ORC-Robotics/soul-robot/calibration/report/comparison.png

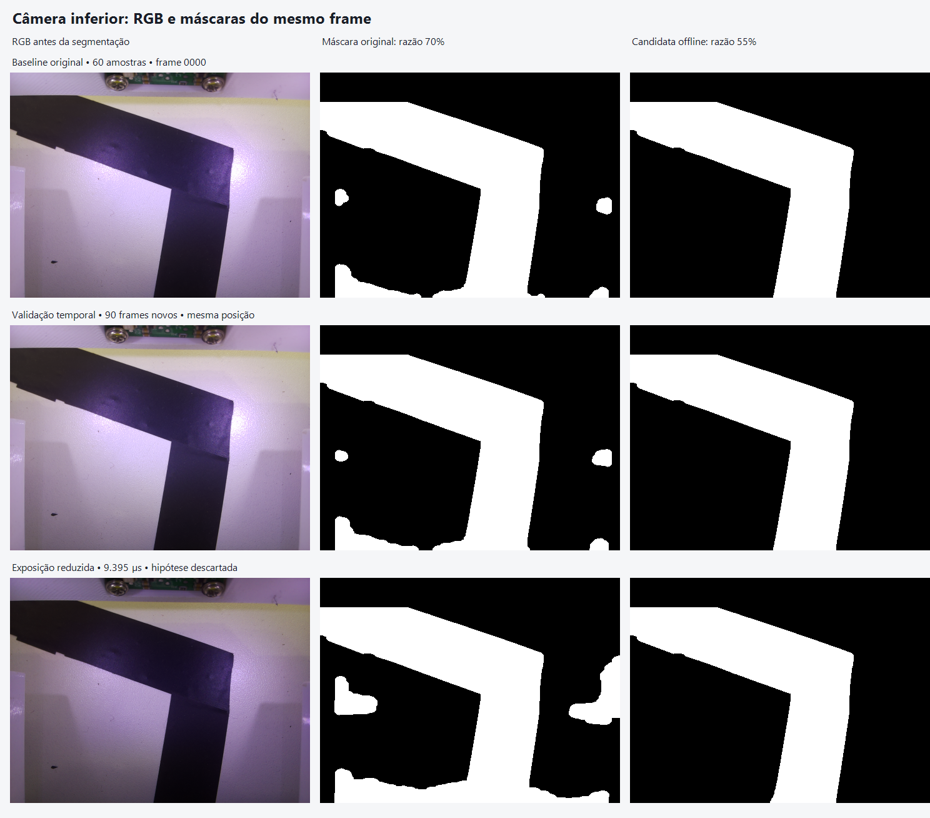
calibration/report/comparison.png
