ORC-Robotics/soul-robot/calibration/report/gap_live_55.png

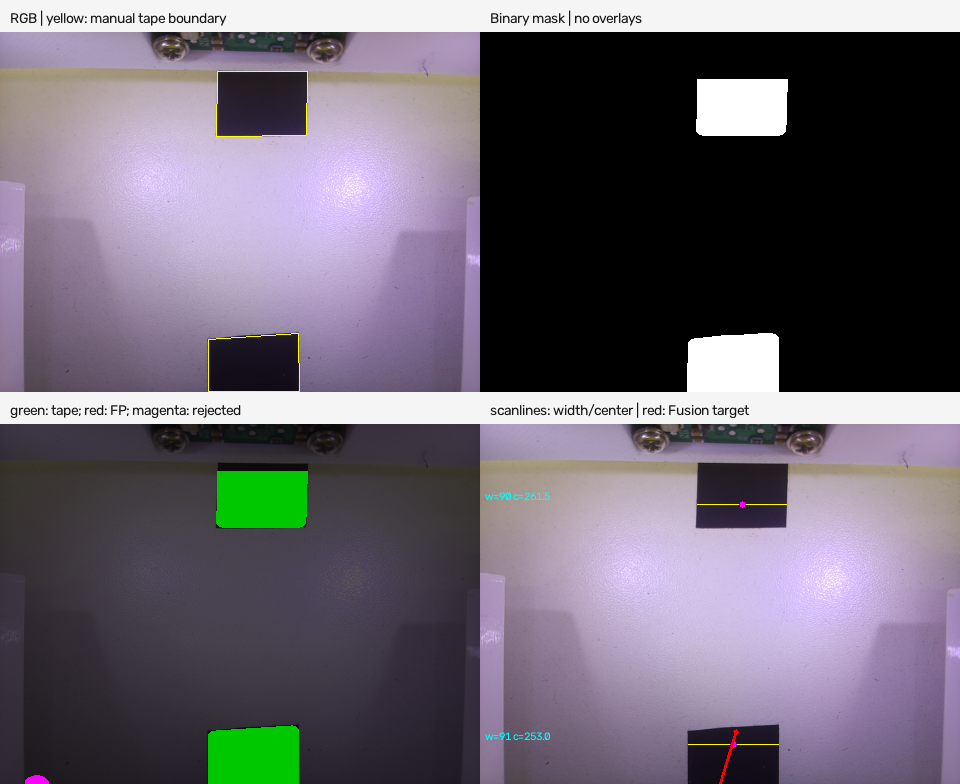
calibration/report/gap_live_55.png
