ORC-Robotics/soul-robot/esp32/obr_esp32_main/README.md

# Firmware principal ESP32 + Raspberry Pi

Abra `obr_esp32_main.ino` no Arduino IDE para gravar o firmware usado no robô.
Ele não cria rede Wi-Fi, não inicia servidor HTTP e não hospeda dashboard.

A ESP32 controla GPIO, motores e sensores. A Raspberry Pi controla o movimento
pela UART de 115200 bps e recebe telemetria a cada 100 ms.

## Ligação UART

| Raspberry Pi | ESP32 | Direção |
| --- | --- | --- |
| GPIO14 / TXD | GPIO3 / RX | Raspberry envia comandos |
| GPIO15 / RXD | GPIO1 / TX | ESP32 envia telemetria |
| GND | GND | Referência elétrica comum |

Desative o console serial da Raspberry antes de conectar. Durante a gravação
da ESP32, mantenha a Raspberry desligada ou desconectada da UART0.

## Comandos recebidos

```text
MOTOR,<esquerda>,<direita>,<emergencia>
STOP
ESTOP
CLEAR_ESTOP
RESET_ENCODERS
CALIBRATE_SENSORS
SYSTEM_STARTING
SYSTEM_READY
SERVO_HOLD,<0|1>
SERVO,<ARM|WRIST|GRIPPER>,<anguloGraus>
SERVO_POSE,<bracoGraus>,<pulsoGraus>,<garraGraus>
SERVO_SLEW,<ARM|WRIST|GRIPPER>,<alvoGraus>,<velocidadeGrausPorSegundo>
SERVO_DISABLE,<ARM|WRIST|GRIPPER>
SERVO_DISABLE_ALL
SERVO_CAL_BEGIN
SERVO_CAL_PULSE,<ARM|WRIST|GRIPPER>,<pulsoUs>
SERVO_CAL_DISABLE
SERVO_CAL_SAVE,<ARM|WRIST|GRIPPER>,<pulsoEmZeroUs>,<pulsoEm180Us>
SERVO_CAL_END
OLED,<duracaoMs>,<tituloHex>,<linha1Hex>,<linha2Hex>
OLED_BIG,<duracaoMs>,<textoPrincipalHex>,<detalheHex>
OLED_CLEAR
PING
```

`OLED` mostra uma página temporária enviada pela Raspberry. O título aceita até
12 caracteres ASCII, cada linha aceita até 20 e a duração fica entre 500 e
30.000 ms. Os textos usam hexadecimal para não conflitar com as vírgulas do
protocolo; um campo vazio é enviado como `-`. `OLED_CLEAR` retorna imediatamente
à página local de bateria e ângulos. E-Stop e calibração continuam tendo
prioridade visual sobre qualquer página remota.

`OLED_BIG` usa o maior tamanho da fonte nativa que comporte o texto principal e
o posiciona somente entre as linhas 16 e 63. Nos módulos bicolores usados pelo
robô, essa é a região fisicamente azul. O detalhe opcional aparece na última
linha. Enquanto ativo, o layout pulsa suavemente o contraste sem apagar o texto.
O conteúdo permanece centralizado, com margem mínima de 4 pixels nas laterais e
2 pixels nos limites verticais da região azul.
E-Stop, calibração e animação de boot continuam tendo prioridade sobre esse
alerta e restauram imediatamente o contraste normal.

O conteúdo e a duração fazem parte de cada comando. Portanto, depois que esta
versão for gravada, novos textos e eventos podem ser criados na Raspberry sem
outra gravação da ESP32. Alterações no layout ou no pulso de contraste continuam
pertencendo ao firmware.

`SYSTEM_STARTING` mantém a animação de inicialização ativa. Depois que UART,
câmera e serviços estão prontos, a Raspberry envia `SYSTEM_READY` a cada segundo.
Se esse heartbeat desaparecer por mais de 3 segundos, a ESP32 volta à animação.
Esse heartbeat não substitui os timeouts e travas dos motores. Fora do modo de
retenção, ele também impede que um pulso antigo permaneça ativo se a Raspberry cair.

`SERVO_HOLD,1` protege mecanismos sujeitos à gravidade: nenhum caminho lógico
aplica `FULL_OFF`, inclusive após Stop, E-Stop ou perda do heartbeat. Novos
movimentos continuam bloqueados sem heartbeat. `SERVO_HOLD,0` libera a trava e
restaura o comportamento normal. A sala de resgate arma a trava; entrar em
Manual ou Calibração, ou pedir o desligamento explícito, libera essa proteção.

`SERVO` movimenta um mecanismo entre 0° e 180°. `SERVO_POSE` valida os três
ângulos antes de aplicar uma pose completa, sendo o formato indicado para
programações predefinidas. Esses dois comandos preservam a aplicação imediata
usada pelas rotinas atuais.

`SERVO_SLEW` é uma capacidade opcional: recebe o alvo e a velocidade máxima
entre 1 e 720 graus por segundo. O canal precisa estar habilitado em uma posição
conhecida antes do comando. A ESP32 atualiza apenas esse servo até o alvo, e um
novo `SERVO`, `SERVO_POSE`, `SERVO_DISABLE` ou `SERVO_DISABLE_ALL` cancela o
movimento gradual correspondente. Nenhum caminho atual da Raspberry envia
`SERVO_SLEW`, portanto gravar o firmware não muda as rotinas existentes.

`SERVO_DISABLE` remove somente o sinal do mecanismo indicado;
`SERVO_DISABLE_ALL` remove os sinais dos três canais quando `SERVO_HOLD` está
inativo. Com a trava ativa, ambos são bloqueados para impedir a queda do braço.
Os servos também são desligados por `STOP`, `ESTOP`, calibração,
`SYSTEM_STARTING` ou perda do heartbeat `SYSTEM_READY`. Os canais e pulsos ficam
centralizados em `../obr_esp32_bridge/robot_config.h`.

A calibração de servo é um modo separado, iniciado por `SERVO_CAL_BEGIN`, e
começa sem emitir pulso. `SERVO_CAL_PULSE` aceita somente 500–2500 µs e mantém
um único canal ativo; se o comando não for renovado por 2 s, o sinal é removido.
`SERVO_CAL_SAVE` recebe os pulsos físicos correspondentes às posições lógicas
0° e 180°, deduz automaticamente a inversão e grava o perfil na NVS com
`Preferences`. `STOP` e `SERVO_CAL_END` encerram o modo e desligam os três
canais. Uma gravação normal preserva os perfis; usar uma opção de apagamento
total da flash pode remover a NVS e restaurar os padrões compilados.

As potências ficam entre `-1.000` e `1.000` e são aplicadas diretamente ao PWM.
Os lados esquerdo e direito são independentes: `MOTOR,0.050,0.000,0` aplica 5%
somente ao lado esquerdo. Não existe perfil, mínimo, boost ou recuperação automática.

Se nenhum comando de motor chegar durante 500 ms, os dois lados são zerados.
O E-Stop permanece travado até `CLEAR_ESTOP` e tem prioridade sobre qualquer
comando de movimento.

O nSLEEP permanece HIGH durante a operação. Partidas e inversões aplicam diretamente
a potência recebida. E-Stop, `STOP` e timeout continuam zerando os motores imediatamente.

`CALIBRATE_SENSORS` para os motores, zera encoders, ângulos e filtros de
navegação e mede novamente os desvios do giroscópio. O mesmo processo começa ao
manter o botão Start no GPIO27 pressionado continuamente por 5 segundos. O robô
deve permanecer imóvel durante a calibração. Depois dela, a trava local mantém
os motores parados até a Raspberry enviar `CLEAR_ESTOP` como parte de uma nova
habilitação explícita; um comando de movimento antigo não é reaplicado.

## Respostas

```text
READY
PONG
ERR,<motivo>
CALIBRATION,START
CALIBRATION,DONE
CALIBRATION,FAILED
START_BUTTON,SHORT
OLED,OK
OLED,CLEARED
SERVO_CAL,START
SERVO_CAL,SAVED,<ARM|WRIST|GRIPPER>
SERVO_CAL,END
SENSOR,<campos CSV...>
```

`START_BUTTON,SHORT` é emitido ao soltar o botão depois de um toque válido. A
Raspberry usa esse evento para iniciar a missão selecionada quando estiver parada.
Em Manual/Autônomo, a telemetria do botão pressionado para o robô imediatamente
e o evento curto posterior é consumido. O evento não é emitido quando a pressão
alcança os 5 segundos da calibração, impedindo que uma tentativa de calibrar
também coloque o robô em movimento.

Os primeiros campos de `SENSOR` preservam o protocolo anterior. Os demais
incluem bateria, encoders, botão, PCA9685, potências aplicadas, velocidades dos
encoders, rampa, giroscópio, temperatura, OLED, nSLEEP, E-Stop e uptime.

Ordem completa dos campos:

```text
SENSOR,
distanciaCm,gyroZ,yawZ,accelX,accelY,accelZ,mpuOk,
bateriaV,encoderEsquerdo,encoderDireito,startButton,pcaOk,
potenciaEsquerda,potenciaDireita,taxaEsquerda,taxaDireita,
rampa,gyroX,gyroY,temperaturaImu,oledOk,nSleepHigh,estop,
bateriaAdcMillivolts,uptimeMs,calibracaoAtiva,oledRemotaAtiva,sistemaRaspberryPronto,
idadeComandoMotorMs,timeoutMotor,fonteMotor,
anguloBraco,pulsoBracoUs,bracoAtivo,
anguloPulso,pulsoPulsoUs,pulsoAtivo,
anguloGarra,pulsoGarraUs,garraAtiva,
calibracaoServoAtiva,indiceServoEmTeste,
minBracoUs,maxBracoUs,bracoInvertido,
minPulsoUs,maxPulsoUs,pulsoInvertido,
minGarraUs,maxGarraUs,garraInvertida
alvoBracoGraus,velocidadeBracoGrausPorSegundo,bracoEmMovimentoGradual,
alvoPulsoGraus,velocidadePulsoGrausPorSegundo,pulsoEmMovimentoGradual,
alvoGarraGraus,velocidadeGarraGrausPorSegundo,garraEmMovimentoGradual
```

A tensão da bateria não é zerada durante a calibração porque é uma medição
absoluta usada para acompanhar a alimentação do robô.
