ORC-Robotics/soul-robot/docs/SILVER_DATASET.md

# Coleta e treinamento da faixa prata

A coleta usa as câmeras já abertas pela aplicação. Na inferior,
`vision.application.DownwardCameraApplication` entrega o frame original ao
`SilverDatasetRecorder`; na frontal, o frame passa pela orientação física antes
da coleta, ainda sem overlays. `vision.status_publisher.LineStatusPublisher`
e o status frontal incluem a mesma telemetria de dataset no dashboard.

O recorder e o classificador já são classes com responsabilidades específicas.
O treinamento permanece offline, separado do ciclo do robô. TensorFlow não é
uma dependência das câmeras. O classificador distingue `black`, `other` e
`silver`; ele não substitui o seguidor geométrico nem calcula comandos dos
motores. Quando quatro inferências consecutivas confirmam `silver`, porém, a
câmera publica `courseMarkerConfirmed=GRAY`. Antes de confirmar a entrada, a
missão recua primeiro 3 cm pelos encoders e então centraliza a linha preta
anterior somente pelo sensor virtual `NEAR`, na parte inferior da imagem. Se a
linha não aparecer, aguarda parada por um frame válido; a busca de vítimas não
é iniciada automaticamente.

## Estado operacional temporário

O detector está ativo por padrão em `vision.camera_config`. A variável de
ambiente `SILVER_DETECTION_ENABLED=0` desliga a inferência durante diagnósticos.
Quando desligado, a câmera publica `courseMarkerConfirmed=false` e
`courseMarker=NONE`; a visão de linha continua funcionando.

O desligamento foi motivado por falsos positivos observados em pista sobre uma
faixa preta sem cinza aparente. O modelo chegou a 85,1% de probabilidade de
`silver`, com margem de 71,4 pontos percentuais, e sustentou quatro positivos
até acionar a entrada na área de resgate. Aumentar somente a confirmação
temporal não corrige esse caso, pois o erro persistiu entre frames.

O modelo atual recebe o frame inteiro reduzido para 128×128. Ele não confirma
cor neutra, brilho, formato transversal, largura nem posição do marcador em
relação à trajetória. O dataset inferior disponível durante o diagnóstico
possuía apenas três sessões físicas, todas coletadas no mesmo dia. Isso permite
que o classificador aprenda iluminação e contexto da cena em vez do material
prateado. Também não há resultado versionado de uma validação independente em
runs completas.

Para continuar melhorando o marcador:

1. grave como exemplos `black` os falsos positivos reais, além de sombras,
   reflexos, curvas, interseções e diferentes trechos de fita;
2. faça novas sessões em dias, posições e iluminações diferentes, separando
   treino, validação e teste por sessão física;
3. detecte primeiro uma faixa transversal plausível e classifique apenas essa
   ROI, exigindo brilho e neutralidade compatíveis com prata;
4. relacione o candidato à trajetória preta e rejeite regiões sem geometria de
   marcador;
5. meça falsos acionamentos por run e recall de prata em sessões que não
   participaram do ajuste;
6. calibre confiança, margem e confirmação temporal somente depois dessas
   medições.

Elevar apenas o limiar não substitui a validação: já houve falso positivo acima
de 85%. O limite operacional foi ajustado para 92% depois que a fita verdadeira
permaneceu acima desse valor e um reflexo roxo chegou a 89,8% na pista.

## Fotografar na Raspberry Pi

Com os serviços normais de câmera em execução e o robô parado, abra uma sessão SSH:

```bash
cd /home/raspberry/OBR2026K
python3 scripts/capture_silver_dataset.py --camera down --session session_001 --fps 4
```

Use `b`, `o` ou `s` e Enter para selecionar a classe e capturar; `p` pausa,
`r` consulta a contagem e `q` encerra pausando. A coleta começa pausada.
Para a frontal, substitua `down` por `forward`. Use um único controlador de
coleta por vez: o arquivo de controle é compartilhado entre as câmeras.

Os JPEGs ficam em `dataset/raw/<camera>/<session>/<classe>/`. A gravação ocorre
na thread do recorder com fila de dois frames. Falhas da coleta não interrompem
a visão. Ao abrir uma sessão, novos frames aguardam a contagem inicial sem
serem contabilizados como descartes. O dashboard mostra coleta ativa, pausada
ou sem atualização (4 segundos). O painel não controla a coleta.

Faça pelo menos duas sessões **por câmera**, cada uma com as três classes.
Para uma coleta simples, use uma sessão `light_on` com a sala acesa e outra
`light_off` com a sala escura, mantendo os LEDs do robô ligados nas duas.
Misture distâncias, ângulos e posições dentro de cada sessão.

Com exatamente duas sessões, o treino separa cada classe de cada sessão em
blocos consecutivos de 20 imagens e distribui blocos inteiros entre treino,
validação e teste. As duas iluminações participam dos três conjuntos sem
dividir frames consecutivos individualmente. Essa avaliação não substitui
passagens reais, pois os três conjuntos ainda vieram das mesmas duas montagens.
Cada classe precisa ter pelo menos 41 imagens em cada sessão; a coleta sugerida
de 500 imagens por classe fica bem acima desse mínimo técnico.

Com três ou mais sessões, o treino continua separando sessões inteiras, que é
o método mais rigoroso. Confira espaço livre e examine alguns JPEGs antes de
fazer uma coleta longa.

## Conferir e treinar no computador

Copie `dataset/raw/` da Raspberry para `dataset/raw/` neste repositório. As
pastas de dataset e resultados continuam ignoradas pelo Git.

```bash
python3 training/training_silver_classifier.py --camera down --validate-only
```

A conferência exige NumPy, mas não TensorFlow. Ela verifica sessões, distribuição
das classes e separação dos conjuntos; a qualidade visual precisa ser revisada.

Para executar a inferência TFLite no serviço da câmera inferior, prepare o
ambiente opcional que o launcher reconhece somente quando todas as dependências
necessárias podem ser importadas:

```bash
cd /home/raspberry/OBR2026K
python3 -m venv --system-site-packages .venv-ai
.venv-ai/bin/python3 -m pip install ai-edge-litert
```

Se esse ambiente estiver ausente ou incompleto, o serviço continua usando
`.venv` ou o Python do sistema. Nesse caso, a visão de linha permanece ativa e
o detector Silver informa indisponibilidade na telemetria, sem confirmar cinza.

Em um ambiente de treinamento com NumPy e TensorFlow instalados:

```bash
python3 training/training_silver_classifier.py --camera down
python3 training/training_silver_classifier.py --camera forward
```

O treinamento usa MobileNetV3Small com pesos ImageNet (o primeiro uso precisa
baixá-los). `--fine-tune` habilita a segunda fase. `--roi LEFT TOP RIGHT BOTTOM`
define um recorte normalizado; se utilizado, a inferência futura deverá aplicar
o mesmo recorte no `SilverLineDetector`. O padrão é a imagem inteira. Os modelos
existentes de teste em `assets/models/` não demonstram qualidade de classificação
na pista.

Saídas: `training_outputs/silver_<camera>/` contém divisão das sessões, modelo
Keras, métricas, histórico e falsos positivos; `assets/models/silver_<camera>.tflite`
recebe o modelo exportado. Reexecutar o treinamento substitui essas saídas da
mesma câmera. Preserve uma cópia quando quiser comparar experimentos.

Depois do treinamento, `vision.silver_detection.SilverLineDetector` carrega o
modelo correspondente com `from_camera_model("down")` ou
`from_camera_model("forward")`. `detect(frame)` retorna `detected`, a classe
vencedora, as probabilidades e a margem da faixa prata sobre a concorrente mais
forte. Os limites atuais são 80% de confiança e 15 pontos percentuais de
margem. A busca e a confirmação rodam em até 30 FPS e exigem quatro positivos
consecutivos. Calibre esses valores com as
métricas e falsos positivos do dataset real antes de operar a missão principal.

## Validação antes de operar

```bash
python3 -m unittest discover -s tests/python
cmake -S . -B build -DBUILD_TESTING=ON
cmake --build build -j2
ctest --test-dir build --output-on-failure
```

Após o deploy autorizado, valide primeiro com rodas suspensas: inicialização
parada, parada de emergência e perda de comandos. Confira ambas as imagens,
as três classes, pausa/retomada, troca de sessão e telemetria antiga com o
processo da câmera parado. Só então teste movimentação em potência reduzida.
Os entrypoints de deploy continuam `scripts/deploy.sh` e `scripts/deploy.ps1`,
delegando para `deployment/`. Nenhum serviço precisa mudar para a coleta.
