ORC-Robotics/soul-robot/calibration/report/border_background_301.png

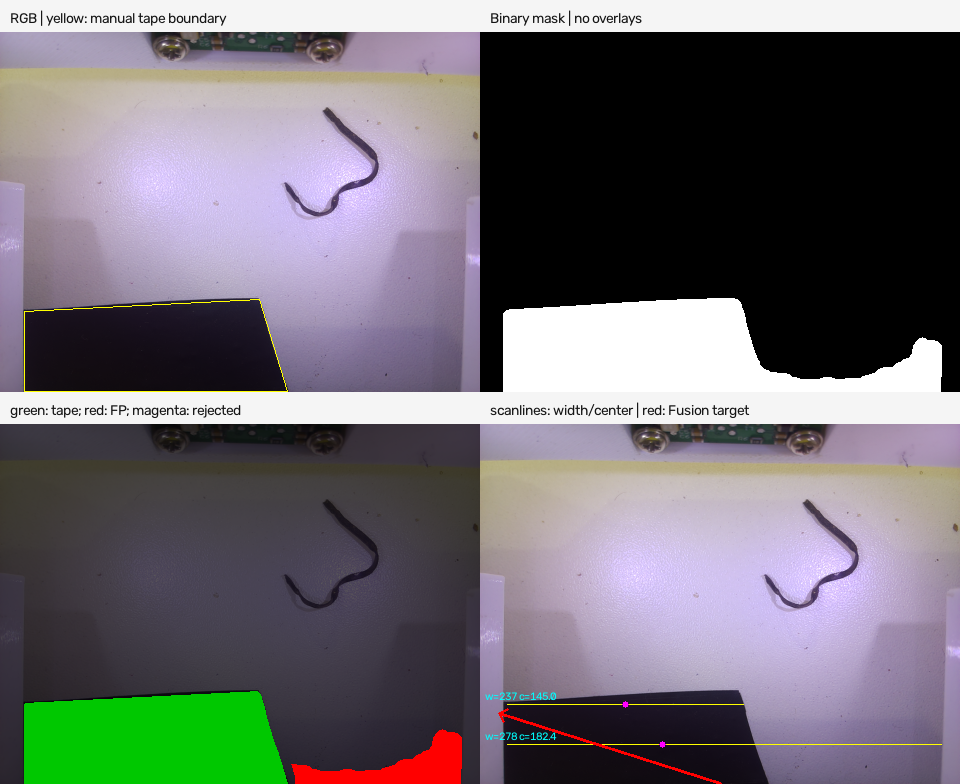
calibration/report/border_background_301.png
