ORC-Robotics/soul-robot/calibration/report/current_pose_preview.png

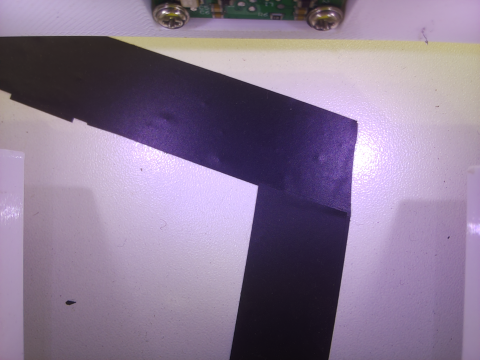
calibration/report/current_pose_preview.png
