ORC-Robotics/soul-robot/calibration/report/final_shadow_after.png

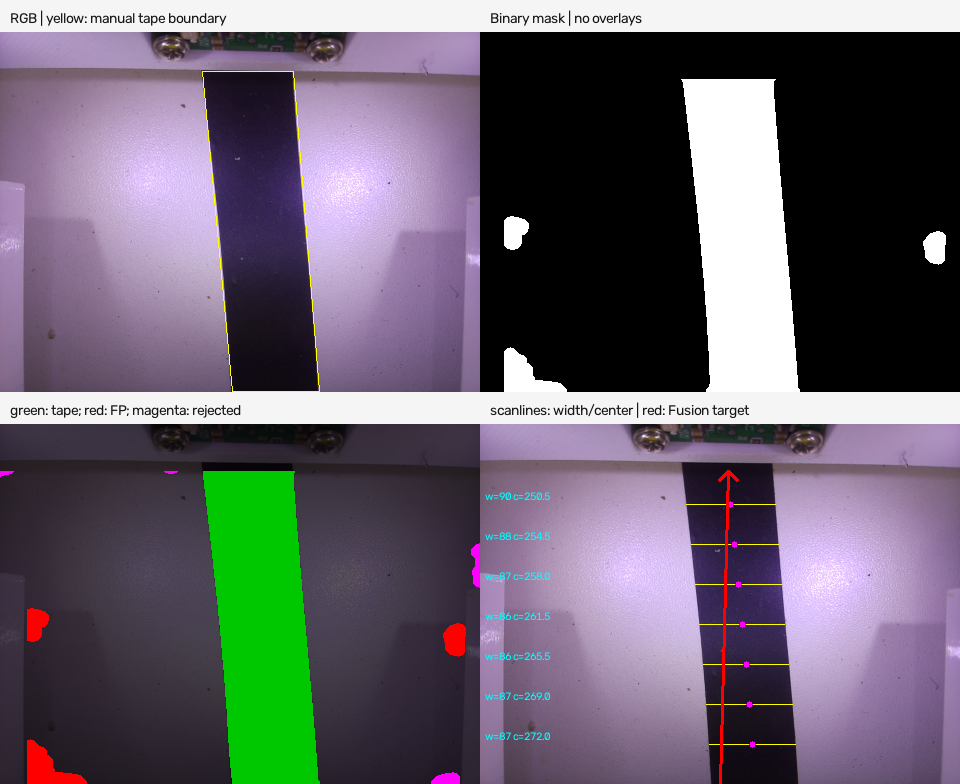
calibration/report/final_shadow_after.png
