ORC-Robotics/soul-robot/calibration/report/final_turn90_after.png

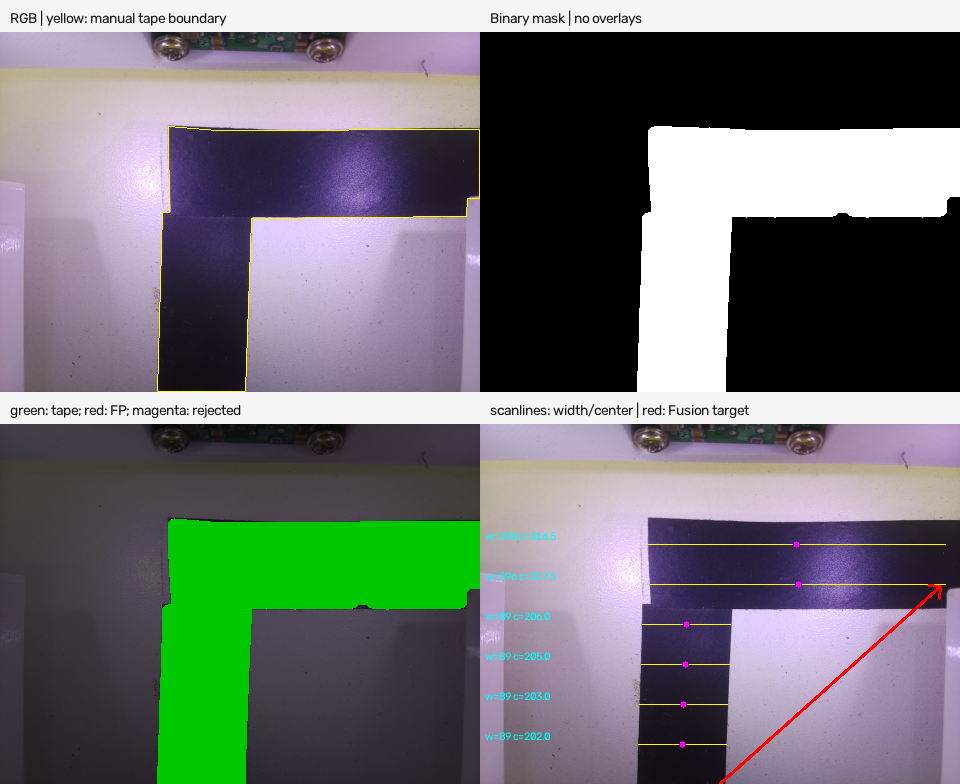
calibration/report/final_turn90_after.png
