ORC-Robotics/soul-robot/calibration/report/gentle_curve_live_55.png

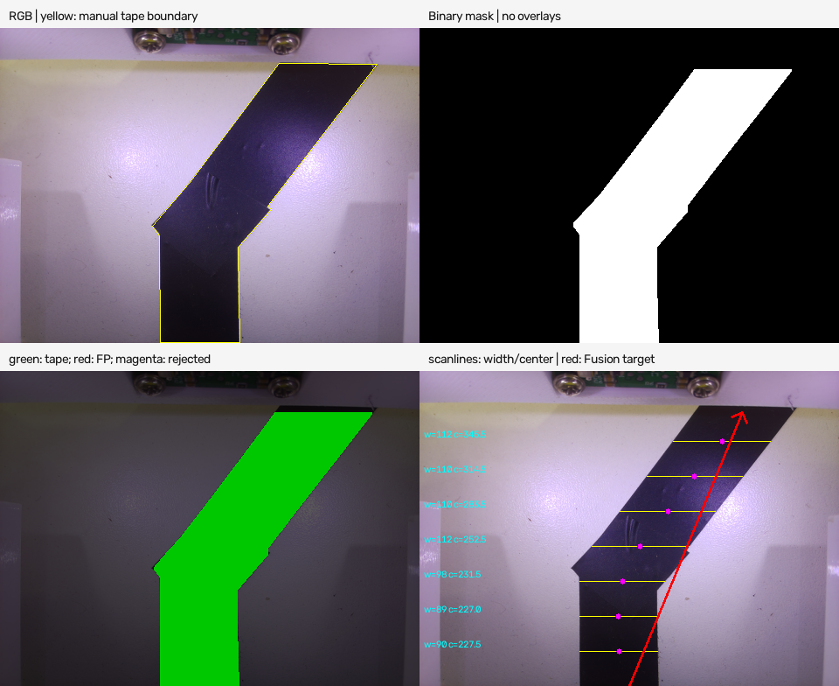
calibration/report/gentle_curve_live_55.png
