ORC-Robotics/soul-robot/calibration/report/green_live_61_exclusion.png

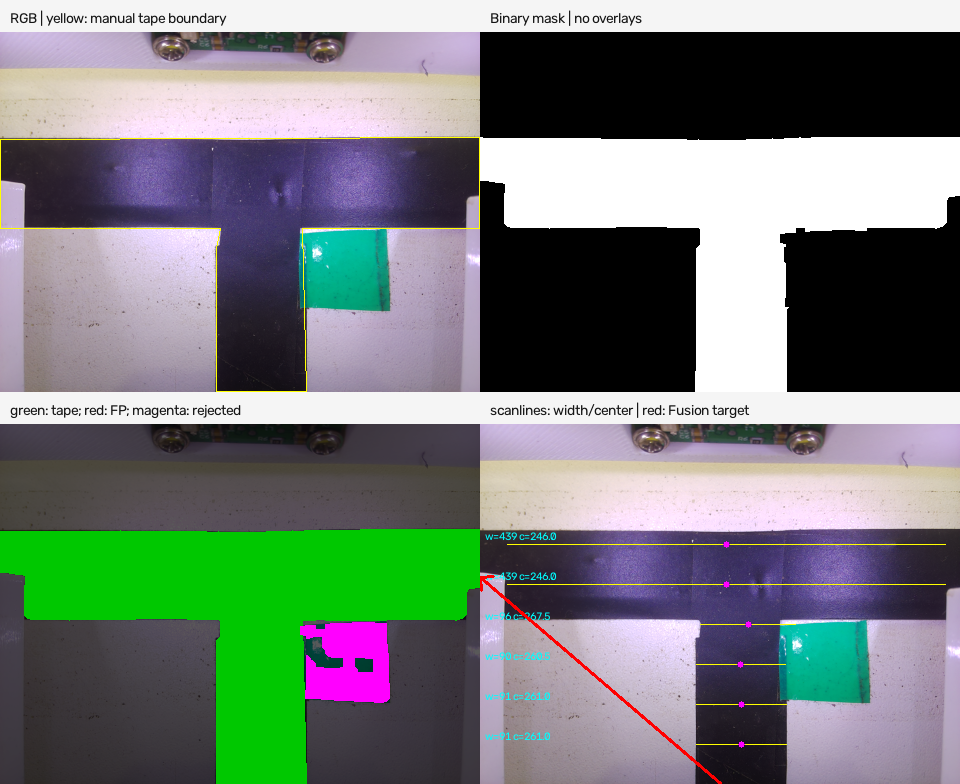
calibration/report/green_live_61_exclusion.png
