ORC-Robotics/soul-robot/calibration/report/illumination_border_wire.png

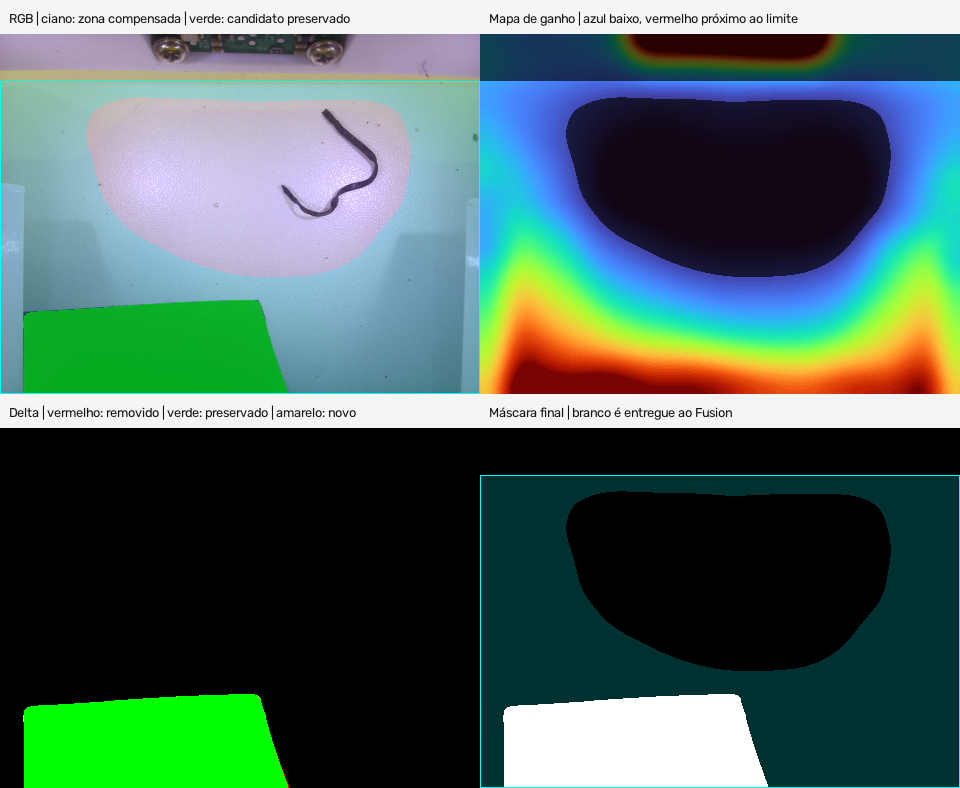
calibration/report/illumination_border_wire.png
