ORC-Robotics/soul-robot/calibration/report/illumination_white_floor.png

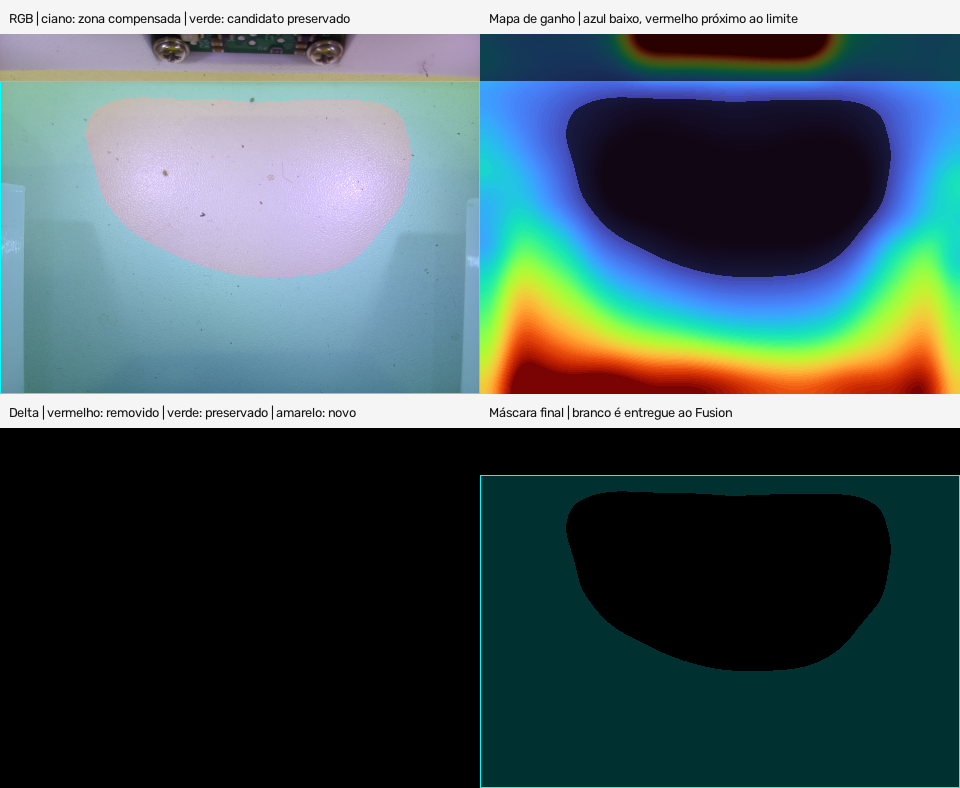
calibration/report/illumination_white_floor.png
