ORC-Robotics/soul-robot/calibration/report/intersection_candidate_55.png

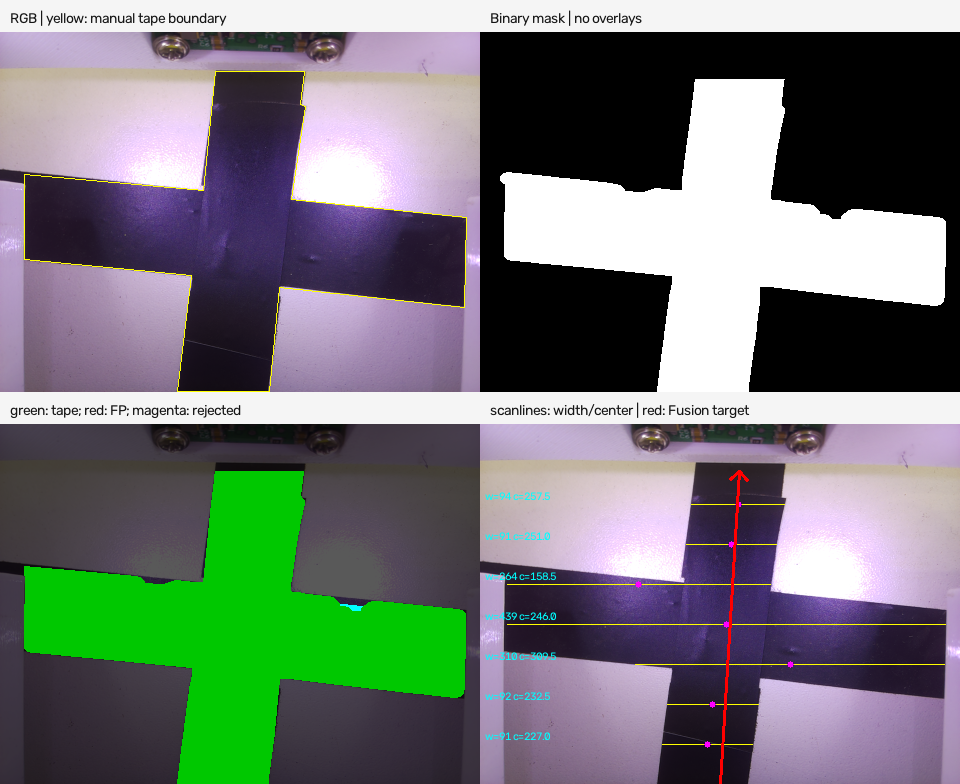
calibration/report/intersection_candidate_55.png
