ORC-Robotics/soul-robot/calibration/report/scanlines_candidate_55.png

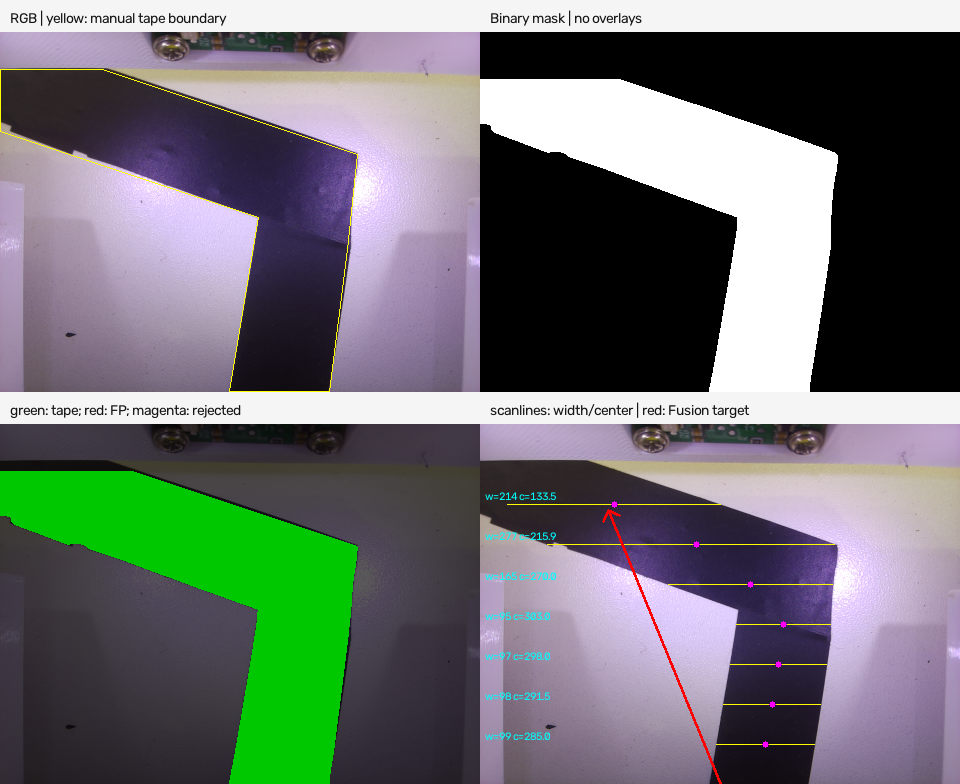
calibration/report/scanlines_candidate_55.png
