ORC-Robotics/soul-robot/calibration/report/straight_candidate_55.png

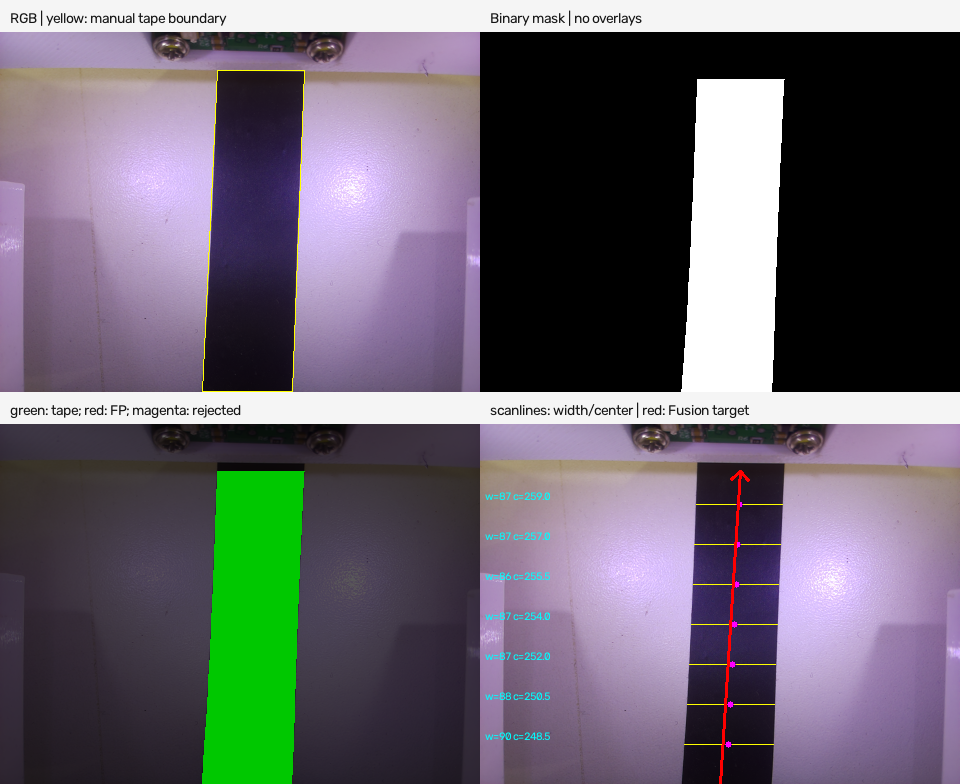
calibration/report/straight_candidate_55.png
