ORC-Robotics/soul-robot/docs/gap-presence-evidence/down.jpg

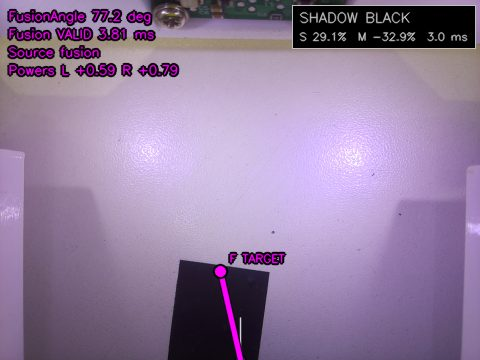
docs/gap-presence-evidence/down.jpg
