ORC-Robotics/soul-robot/docs/gap-presence-evidence/forward.jpg

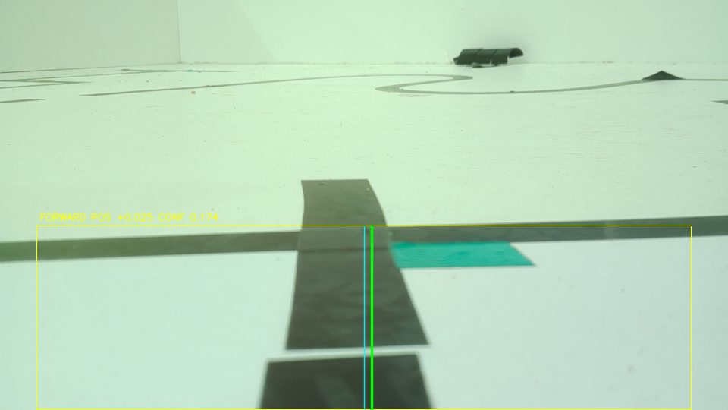
docs/gap-presence-evidence/forward.jpg
