ORC-Robotics/soul-robot/docs/validation-status.md

# Status de validação do robô

**STATUS: EXPERIMENTAL / NÃO VALIDADO**

Este checkpoint preserva o estado atual do algoritmo para instalação e ensaios
sem movimento na Raspberry Pi 5. Ele não representa uma versão estável para
competição e não autoriza testes autônomos no chão.

## Mapeamento físico da Raspberry Pi 5

- CAM0 / índice `0`: câmera inferior (`down`), responsável pelo segue-faixa,
  detecção de verde e publicação de `obr_line_status.json`.
- CAM1 / índice `1`: câmera frontal (`forward`), usada pelo assistente leve de
  linha e pela visão de resgate. O detector de vítimas permanece desligado fora
  da execução explícita de `rescue_area`.

Os papéis são definidos pelos índices configurados, não pelo modelo do sensor.
Uma câmera ausente não pode fazer a outra assumir seu papel automaticamente.

## Problemas conhecidos ainda abertos

- Falsos candidatos verdes podem aparecer no chão branco.
- O verde real ainda pode aparecer como ambíguo em situações físicas.
- O HSV precisa ser calibrado usando frames RGB reais da pista.
- A nova transição START/RUN (`0.67` para `0.61`) ainda precisa de validação
  física com os encoders e as rodas suspensas.
- O pipeline de resgate existe, mas HSV, Hough, FOV, distância e aproximação ainda
  não foram validados na iluminação e no piso da arena.
- O desvio de obstáculo ainda precisa validar no robô os limiares de 8/15 cm e a
  sequência calibrada de giros e deslocamentos.
- A visualização RGB e as máscaras do dashboard continuam em evolução.

## Resultados da validação de 17 de agosto de 2026

- A validação histórica usou `base_speed_preview=0.66` e piso `0.65`. Esses
  valores foram substituídos porque um dos motores não gira nessa potência. A
  calibração física atual definiu partida em `0.67` e manutenção em `0.61`.
  A trajetória válida usa base `0.70`, diferencial contínuo e pode pedir
  `0.86 / 0.61`; a camada C++ mantém `0.67` até o encoder confirmar a roda.
- A captura da câmera inferior já operou próxima de 30 FPS na configuração
  anterior. O [status registrado](../artifacts/pi5-camera-validation-20260817/camera-status.json)
  mostra 30,07 FPS, e o
  [traço de 300 amostras](../artifacts/pi5-camera-validation-20260817/line-regression-trace-300.csv)
  registra a frequência e o tempo de processamento de cada quadro. Após mudar a
  saída inferior para 480×360, é obrigatório registrar uma nova medição antes de
  considerar os 30 FPS confirmados nessa resolução.
- CAM0 e CAM1 foram registradas separadamente nas evidências
  [cam0.jpg](../artifacts/pi5-camera-validation-20260817/cam0.jpg) e
  [cam1.jpg](../artifacts/pi5-camera-validation-20260817/cam1.jpg).
- O controlador normal registrado nas evidências históricas foi removido; esses
  números não descrevem o ponto de extensão atual, que mantém os motores parados.

## Validação física dos verdes em 11 de setembro de 2026

- Os verdes direcionais à esquerda e à direita foram validados fisicamente.
  Depois da confirmação, um pivô inicial curto impede avanço reto; o controle é
  entregue ao Fusion quando o FAR encontra a continuação do ramo selecionado.
- A ROI lateral dos verdes direcionais usa 18% de preto para tolerar a chegada
  diagonal, sem reduzir os 25% exigidos pela ROI superior ligada à faixa.
- O retorno de 180 graus foi validado fisicamente com 140 graus iniciais
  controlados pelo MPU6050. O restante do giro procura a faixa pela câmera e é
  encerrado após duas confirmações consecutivas por NEAR ou Fusion.
- Durante a estabilização após os 140 graus, uma faixa válida tem prioridade
  sobre a espera do giroscópio. Isso devolve imediatamente o controle ao
  segue-faixa quando o robô já está sobre a linha.
- O MPU6050 não apresentou falhas nas outras manobras. A espera angular que
  ocorreu neste ensaio ficou restrita ao retorno e foi resolvida pela prioridade
  visual, sem alterar globalmente os limites do controlador da IMU.
- Caso conhecido para a próxima etapa: dois verdes pertencentes a faixas
  diferentes ainda podem formar um falso retorno de 180 graus. Esse caso não
  foi alterado neste checkpoint para preservar os comportamentos já validados.

## Validação ainda obrigatória antes de novos testes no chão

1. Manter o robô suspenso e o E-Stop disponível no primeiro ensaio após deploy.
2. Confirmar startup com os motores parados e sem loop de reinicialização do
   serviço `obr-robot`.
3. Confirmar que somente CAM0 atualiza `obr_line_status.json` durante a execução.
4. Calibrar o HSV com imagens reais da pista e repetir os casos de verde.
5. Confirmar que o estado normal permanece parado e que uma manobra verde ativa
   mantém seu próprio comando sem ser sobrescrita pela parada normal.
6. Com `obr-line-camera` parado, confirmar que o IPC de linha foi removido e que
   a Missão Principal não pode ser iniciada; após iniciar o serviço, aceitar
   somente uma publicação nova e fresca.
7. Validar por lado a troca STARTING (`0.67`) para RUNNING (`0.61`) depois de
   duas amostras recentes do encoder e o retorno a STARTING após três falhas.
8. Fora de `rescue_area`, confirmar pelo HUD e pela CPU que HSV/Hough permanecem
   inativos; depois iniciar a etapa e validar aquisição, alinhamento, perda do
   alvo, Stop e E-Stop com as rodas suspensas.
9. Validar o desvio primeiro com motores suspensos e potência reduzida; conferir
   confirmação ultrassônica, cada giro, cada distância, falhas de IMU/encoder e
   retorno da autoridade ao segue-faixa.
