ORC-Robotics/soul-robot/scripts/vision/calibration/down_line_illumination_480x360.png

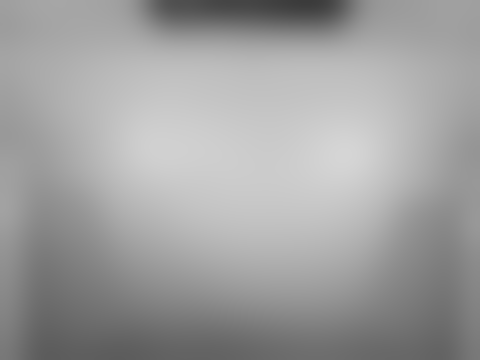
scripts/vision/calibration/down_line_illumination_480x360.png
