ORC-Robotics/soul-robot/esp32/obr_esp32_bridge/obr_esp32_bridge.ino

#include <Arduino.h>
#include <Adafruit_GFX.h>
#include <Adafruit_MPU6050.h>
#include <Adafruit_PWMServoDriver.h>
#include <Adafruit_Sensor.h>
#include <Adafruit_SSD1306.h>
#include <Preferences.h>
#ifndef OBR_ESP32_RASPBERRY_MODE
#include <WebServer.h>
#include <WiFi.h>
#endif
#include <Wire.h>
#include <driver/gpio.h>

#ifndef OBR_ESP32_RASPBERRY_MODE
#include "dashboard_page.h"
#endif
#include "robot_config.h"

#if __has_include(<esp_arduino_version.h>)
#include <esp_arduino_version.h>
#endif

#ifndef ESP_ARDUINO_VERSION_MAJOR
#define ESP_ARDUINO_VERSION_MAJOR 2
#endif

using namespace robot_config;

enum class ControlSource
{
  None,
  Dashboard,
  Raspberry
};

enum class ServoId : uint8_t
{
  Arm = 0,
  Wrist = 1,
  Gripper = 2
};

struct ServoOutputConfig
{
  const char* protocolName;
  const char* preferencesKey;
  uint8_t channel;
  uint16_t defaultMinimumPulseUs;
  uint16_t defaultMaximumPulseUs;
  bool defaultInverted;
};

struct ServoCalibration
{
  uint16_t minimumPulseUs;
  uint16_t maximumPulseUs;
  bool inverted;
};

struct StoredServoCalibration
{
  uint16_t version;
  uint16_t minimumPulseUs;
  uint16_t maximumPulseUs;
  uint8_t inverted;
  uint8_t reserved;
};

static_assert(sizeof(StoredServoCalibration) == 8,
              "Stored servo calibration layout changed");

struct ServoOutputState
{
  float angleDegrees = 0.0f;
  uint16_t pulseUs = 0;
  bool enabled = false;
  float targetAngleDegrees = 0.0f;
  float slewRateDegreesPerSecond = 0.0f;
  uint32_t lastSlewUpdateMs = 0;
  bool slewActive = false;
};

// A ordem desta tabela deve permanecer igual à ordem de ServoId.
// Cada entrada concentra canal, calibração e sentido de um mecanismo.
constexpr ServoOutputConfig kServoOutputConfigs[] = {
    {"ARM", "arm", kArmServoChannel, kArmServoMinimumPulseUs,
     kArmServoMaximumPulseUs, kArmServoInverted},
    {"WRIST", "wrist", kWristServoChannel, kWristServoMinimumPulseUs,
     kWristServoMaximumPulseUs, kWristServoInverted},
    {"GRIPPER", "gripper", kGripperServoChannel, kGripperServoMinimumPulseUs,
     kGripperServoMaximumPulseUs, kGripperServoInverted}};

constexpr size_t kServoOutputCount =
    sizeof(kServoOutputConfigs) / sizeof(kServoOutputConfigs[0]);

void forceMotorPinsLowImmediately()
{
  // Mantém o driver dormindo antes de configurar qualquer entrada de motor.
  // O pull-down físico da PCB garante o mesmo estado antes deste código rodar.
  gpio_set_level(static_cast<gpio_num_t>(kMotorSleepPin), 0);
  // INPUT_OUTPUT permite dirigir nSLEEP e ler no dashboard o nível presente
  // no pad. Em OUTPUT puro, gpio_get_level() pode informar LOW incorretamente.
  gpio_set_direction(static_cast<gpio_num_t>(kMotorSleepPin), GPIO_MODE_INPUT_OUTPUT);

  // Grava LOW antes de habilitar os GPIOs como saída. Assim, nenhuma entrada
  // do DRV8833 recebe um pulso alto causado pela troca de direção do pino.
  gpio_set_level(static_cast<gpio_num_t>(kLeftMotorIn1Pin), 0);
  gpio_set_level(static_cast<gpio_num_t>(kLeftMotorIn2Pin), 0);
  gpio_set_level(static_cast<gpio_num_t>(kRightMotorIn1Pin), 0);
  gpio_set_level(static_cast<gpio_num_t>(kRightMotorIn2Pin), 0);
  gpio_set_direction(static_cast<gpio_num_t>(kLeftMotorIn1Pin), GPIO_MODE_OUTPUT);
  gpio_set_direction(static_cast<gpio_num_t>(kLeftMotorIn2Pin), GPIO_MODE_OUTPUT);
  gpio_set_direction(static_cast<gpio_num_t>(kRightMotorIn1Pin), GPIO_MODE_OUTPUT);
  gpio_set_direction(static_cast<gpio_num_t>(kRightMotorIn2Pin), GPIO_MODE_OUTPUT);
}

// Este inicializador executa antes do setup() e antecipa a parada dos motores.
// Ele existe porque a PCB mantém o DRV8833 habilitado durante o boot da ESP32.
class EarlyMotorSafetyInitializer
{
public:
  EarlyMotorSafetyInitializer()
  {
    forceMotorPinsLowImmediately();
  }
};

EarlyMotorSafetyInitializer earlyMotorSafetyInitializer;

#ifndef OBR_ESP32_RASPBERRY_MODE
// O servidor existe somente no firmware de bancada. O firmware principal
// exclui Wi-Fi e HTTP durante a compilação e obedece apenas à Raspberry.
WebServer server(80);
#endif
Adafruit_MPU6050 mpu;
Adafruit_PWMServoDriver pca9685(kPca9685Address, Wire);
Adafruit_SSD1306 oled(kOledWidth, kOledHeight, &Wire, -1);

struct SensorState
{
  float batteryVoltage = 0.0f;
  uint32_t batteryAdcMillivolts = 0;
  float ultrasonicDistanceCm = -1.0f;
  bool ultrasonicValid = false;
  float accelX = 0.0f;
  float accelY = 0.0f;
  float accelZ = 0.0f;
  float gyroX = 0.0f;
  float gyroY = 0.0f;
  float gyroZ = 0.0f;
  float yawZ = 0.0f;
  float rampAngleDegrees = 0.0f;
  float imuTemperatureCelsius = 0.0f;
  float leftEncoderRate = 0.0f;
  float rightEncoderRate = 0.0f;
};

SensorState sensors;
ServoOutputState servoOutputStates[kServoOutputCount];
ServoCalibration servoCalibrations[kServoOutputCount] = {
    {kArmServoMinimumPulseUs, kArmServoMaximumPulseUs, kArmServoInverted},
    {kWristServoMinimumPulseUs, kWristServoMaximumPulseUs,
     kWristServoInverted},
    {kGripperServoMinimumPulseUs, kGripperServoMaximumPulseUs,
     kGripperServoInverted}};
bool mpuReady = false;
bool pca9685Ready = false;
bool oledReady = false;
bool motorDriverAwake = false;
uint8_t mpuAddress = 0;
uint8_t oledAddress = 0;
bool startButtonPressed = false;
bool rawStartButtonPressed = false;
bool calibrationActive = false;
bool calibrationStopLatched = false;
bool servoCalibrationActive = false;
// Enquanto ativo, nenhum caminho lógico pode remover o PWM dos servos. Esse
// modo existe para mecanismos que caem por gravidade quando recebem FULL_OFF.
bool servoHoldActive = false;
int8_t servoCalibrationSelectedIndex = -1;
bool dashboardArmed = false;
bool emergencyStopActive = false;
float currentLeftPower = 0.0f;
float currentRightPower = 0.0f;
float gyroYBias = 0.0f;
float gyroZBias = 0.0f;
float filteredGyroZ = 0.0f;
bool gyroFilterInitialized = false;
bool rampAngleInitialized = false;
ControlSource controlSource = ControlSource::None;

uint32_t lastMotorCommandMs = 0;
uint32_t lastImuReadMs = 0;
uint32_t lastTelemetryMs = 0;
uint32_t lastBatteryReadMs = 0;
uint32_t lastEncoderRateMs = 0;
uint32_t lastUltrasonicTriggerMs = 0;
uint32_t lastButtonChangeMs = 0;
uint32_t startButtonPressedSinceMs = 0;
uint32_t lastStartButtonShortEventMs = 0;
uint32_t lastMpuIntegrationUs = 0;
uint32_t lastOledRefreshMs = 0;
bool startButtonLongPressHandled = false;
bool remoteOledActive = false;
bool remoteOledLargeLayout = false;
bool oledAlertContrastModified = false;
uint32_t remoteOledStartedAtMs = 0;
uint32_t remoteOledExpiresAtMs = 0;
char remoteOledTitle[kRemoteOledTitleMaxLength + 1] = {};
char remoteOledFirstLine[kRemoteOledLineMaxLength + 1] = {};
char remoteOledSecondLine[kRemoteOledLineMaxLength + 1] = {};
#ifdef OBR_ESP32_RASPBERRY_MODE
bool raspberrySystemReady = false;
#else
// O firmware de bancada não depende da Raspberry e libera a tela imediatamente.
bool raspberrySystemReady = true;
#endif
uint32_t lastRaspberrySystemReadyMs = 0;
uint32_t lastServoCalibrationCommandMs = 0;

portMUX_TYPE encoderMux = portMUX_INITIALIZER_UNLOCKED;
volatile int32_t leftEncoderCount = 0;
volatile int32_t rightEncoderCount = 0;
volatile uint8_t previousLeftEncoderState = 0;
volatile uint8_t previousRightEncoderState = 0;
int32_t lastLeftEncoderRateCount = 0;
int32_t lastRightEncoderRateCount = 0;
portMUX_TYPE ultrasonicMux = portMUX_INITIALIZER_UNLOCKED;
volatile bool ultrasonicWaitingForEcho = false;
volatile bool ultrasonicSampleAvailable = false;
volatile uint32_t ultrasonicTriggerUs = 0;
volatile uint32_t ultrasonicEchoStartUs = 0;
volatile uint32_t ultrasonicEchoDurationUs = 0;

// O maior comando OLED ocupa menos de 128 bytes com os limites definidos em
// robot_config.h. Comandos maiores são descartados antes de serem interpretados.
constexpr size_t kCommandBufferSize = 128;
char commandBuffer[kCommandBufferSize] = {};
size_t commandLength = 0;

// Tabela de transições do encoder quadrature. Transições inválidas
// contam zero e reduzem erros causados por ruído ou bordas perdidas.
constexpr int8_t kQuadratureTransitions[16] = {
    0, -1, 1, 0,
    1, 0, 0, -1,
    -1, 0, 0, 1,
    0, 1, -1, 0};

void ARDUINO_ISR_ATTR updateLeftEncoder()
{
  const uint8_t currentState =
      (digitalRead(kLeftEncoderAPin) << 1) | digitalRead(kLeftEncoderBPin);
  portENTER_CRITICAL_ISR(&encoderMux);
  leftEncoderCount += kQuadratureTransitions[(previousLeftEncoderState << 2) | currentState];
  previousLeftEncoderState = currentState;
  portEXIT_CRITICAL_ISR(&encoderMux);
}

void ARDUINO_ISR_ATTR updateRightEncoder()
{
  const uint8_t currentState =
      (digitalRead(kRightEncoderAPin) << 1) | digitalRead(kRightEncoderBPin);
  portENTER_CRITICAL_ISR(&encoderMux);
  rightEncoderCount += kQuadratureTransitions[(previousRightEncoderState << 2) | currentState];
  previousRightEncoderState = currentState;
  portEXIT_CRITICAL_ISR(&encoderMux);
}

void ARDUINO_ISR_ATTR captureUltrasonicEcho()
{
  const uint32_t nowUs = micros();
  const bool echoHigh = digitalRead(kFrontUltrasonicEchoPin) == HIGH;

  portENTER_CRITICAL_ISR(&ultrasonicMux);
  if (ultrasonicWaitingForEcho && echoHigh)
  {
    ultrasonicEchoStartUs = nowUs;
  }
  else if (ultrasonicWaitingForEcho && ultrasonicEchoStartUs != 0)
  {
    ultrasonicEchoDurationUs = nowUs - ultrasonicEchoStartUs;
    ultrasonicSampleAvailable = true;
    ultrasonicWaitingForEcho = false;
    ultrasonicEchoStartUs = 0;
  }
  portEXIT_CRITICAL_ISR(&ultrasonicMux);
}

void attachMotorPwm(uint8_t pin, uint8_t channel)
{
#if ESP_ARDUINO_VERSION_MAJOR >= 3
  ledcAttach(pin, kMotorPwmFrequencyHz, kMotorPwmResolutionBits);
  ledcWrite(pin, 0);
#else
  ledcSetup(channel, kMotorPwmFrequencyHz, kMotorPwmResolutionBits);
  ledcAttachPin(pin, channel);
  ledcWrite(channel, 0);
#endif
}

void writeMotorPwm(uint8_t pin, uint8_t channel, uint16_t duty)
{
  duty = constrain(duty, 0, kMotorPwmMaxDuty);
#if ESP_ARDUINO_VERSION_MAJOR >= 3
  ledcWrite(pin, duty);
#else
  ledcWrite(channel, duty);
#endif
}

float safeMotorCommand(float command)
{
  if (!isfinite(command))
  {
    return 0.0f;
  }

  // A faixa de -1 a 1 é o próprio formato do protocolo: 0,05 corresponde
  // diretamente a 5% do duty e não recebe remapeamento, mínimo ou boost.
  return constrain(command, -kMaximumMotorPower, kMaximumMotorPower);
}

size_t servoIndex(ServoId servo)
{
  return static_cast<size_t>(servo);
}

const ServoOutputConfig& servoConfig(ServoId servo)
{
  return kServoOutputConfigs[servoIndex(servo)];
}

ServoCalibration& servoCalibration(ServoId servo)
{
  return servoCalibrations[servoIndex(servo)];
}

ServoOutputState& servoState(ServoId servo)
{
  return servoOutputStates[servoIndex(servo)];
}

bool parseServoId(const char* text, ServoId& servo)
{
  for (size_t index = 0; index < kServoOutputCount; ++index)
  {
    if (strcmp(text, kServoOutputConfigs[index].protocolName) == 0)
    {
      servo = static_cast<ServoId>(index);
      return true;
    }
  }
  return false;
}

bool isValidServoAngle(float angleDegrees)
{
  return isfinite(angleDegrees) &&
         angleDegrees >= kServoMinimumAngleDegrees &&
         angleDegrees <= kServoMaximumAngleDegrees;
}

bool isValidServoCalibration(const ServoCalibration& calibration)
{
  return calibration.minimumPulseUs >=
             kServoCalibrationAbsoluteMinimumPulseUs &&
         calibration.maximumPulseUs <=
             kServoCalibrationAbsoluteMaximumPulseUs &&
         calibration.maximumPulseUs > calibration.minimumPulseUs &&
         calibration.maximumPulseUs - calibration.minimumPulseUs >=
             kServoCalibrationMinimumSpanUs;
}

ServoCalibration defaultServoCalibration(ServoId servo)
{
  const ServoOutputConfig& config = servoConfig(servo);
  return {config.defaultMinimumPulseUs, config.defaultMaximumPulseUs,
          config.defaultInverted};
}

void loadServoCalibrations()
{
  Preferences preferences;
  if (!preferences.begin(kServoPreferencesNamespace, true))
  {
    return;
  }

  for (size_t index = 0; index < kServoOutputCount; ++index)
  {
    const ServoId servo = static_cast<ServoId>(index);
    servoCalibrations[index] = defaultServoCalibration(servo);
    const ServoOutputConfig& config = servoConfig(servo);
    if (preferences.getBytesLength(config.preferencesKey) !=
        sizeof(StoredServoCalibration))
    {
      continue;
    }

    StoredServoCalibration stored = {};
    if (preferences.getBytes(
            config.preferencesKey, &stored, sizeof(stored)) != sizeof(stored))
    {
      continue;
    }

    const ServoCalibration loaded = {
        stored.minimumPulseUs, stored.maximumPulseUs, stored.inverted != 0};
    if (stored.version == kServoCalibrationStorageVersion &&
        stored.inverted <= 1 && isValidServoCalibration(loaded))
    {
      servoCalibrations[index] = loaded;
    }
  }
  preferences.end();
}

bool persistServoCalibration(ServoId servo,
                             const ServoCalibration& calibration)
{
  if (!isValidServoCalibration(calibration))
  {
    return false;
  }

  Preferences preferences;
  if (!preferences.begin(kServoPreferencesNamespace, false))
  {
    return false;
  }

  const StoredServoCalibration stored = {
      kServoCalibrationStorageVersion,
      calibration.minimumPulseUs,
      calibration.maximumPulseUs,
      calibration.inverted ? static_cast<uint8_t>(1) : static_cast<uint8_t>(0),
      0};
  const size_t written = preferences.putBytes(
      servoConfig(servo).preferencesKey, &stored, sizeof(stored));
  preferences.end();
  return written == sizeof(stored);
}

uint16_t servoPulseForAngle(const ServoCalibration& calibration,
                            float angleDegrees)
{
  // Conversão linear usada pelas poses: pulso = mínimo +
  // (ângulo / 180°) × (máximo - mínimo), com inversão quando configurada.
  const float normalizedAngle =
      (angleDegrees - kServoMinimumAngleDegrees) /
      (kServoMaximumAngleDegrees - kServoMinimumAngleDegrees);
  const float directedPosition = calibration.inverted
                                     ? 1.0f - normalizedAngle
                                     : normalizedAngle;
  const float pulseUs = calibration.minimumPulseUs +
                        directedPosition *
                            (calibration.maximumPulseUs -
                             calibration.minimumPulseUs);
  return static_cast<uint16_t>(lroundf(pulseUs));
}

uint16_t pca9685TicksForPulse(uint16_t pulseUs)
{
  // O PCA9685 divide o período de 50 Hz em 4096 passos. A conversão mantém a
  // unidade de calibração em microssegundos, que é mais fácil de conferir no
  // programador e no osciloscópio.
  const float ticks = static_cast<float>(pulseUs) *
                      kPca9685FrequencyHz * 4096.0f / 1000000.0f;
  return static_cast<uint16_t>(constrain(lroundf(ticks), 1L, 4095L));
}

void disableServoOutput(ServoId servo)
{
  ServoOutputState& state = servoState(servo);
  if (pca9685Ready && state.enabled)
  {
    // O valor 4096 ativa o bit FULL_OFF do canal e torna o desligamento
    // explícito, sem depender de ON e OFF coincidirem no mesmo contador.
    pca9685.setPWM(servoConfig(servo).channel, 0, 4096);
  }
  state.enabled = false;
  state.pulseUs = 0;
  state.targetAngleDegrees = state.angleDegrees;
  state.slewRateDegreesPerSecond = 0.0f;
  state.lastSlewUpdateMs = 0;
  state.slewActive = false;
  if (servoCalibrationSelectedIndex ==
      static_cast<int8_t>(servoIndex(servo)))
  {
    servoCalibrationSelectedIndex = -1;
  }
}

void disableAllServoOutputs()
{
  if (servoHoldActive)
  {
    // A sala de resgate depende do torque contínuo do braço. Mesmo E-Stop ou
    // perda da Raspberry mantêm a última pose; a tração continua sendo zerada.
    return;
  }

  // Remover o sinal evita manter um comando antigo durante parada, E-Stop,
  // calibração ou perda da Raspberry. Isso não corta a alimentação V+.
  for (size_t index = 0; index < kServoOutputCount; ++index)
  {
    disableServoOutput(static_cast<ServoId>(index));
  }
  servoCalibrationSelectedIndex = -1;
}

bool servoOutputCommandIsAllowed()
{
  if (!pca9685Ready || emergencyStopActive || calibrationActive ||
      calibrationStopLatched || servoCalibrationActive)
  {
    return false;
  }

#ifdef OBR_ESP32_RASPBERRY_MODE
  const uint32_t nowMs = millis();
  if (!raspberrySystemReady ||
      nowMs - lastRaspberrySystemReadyMs > kRaspberrySystemReadyTimeoutMs)
  {
    return false;
  }
#endif

  return true;
}

void writeServoAngle(ServoId servo, float angleDegrees)
{
  const ServoOutputConfig& config = servoConfig(servo);
  ServoOutputState& state = servoState(servo);
  const uint16_t pulseUs = servoPulseForAngle(
      servoCalibration(servo), angleDegrees);
  pca9685.setPWM(config.channel, 0, pca9685TicksForPulse(pulseUs));
  state.angleDegrees = angleDegrees;
  state.pulseUs = pulseUs;
  state.enabled = true;
}

bool applyServoAngle(ServoId servo, float angleDegrees)
{
  if (!isValidServoAngle(angleDegrees) || !servoOutputCommandIsAllowed())
  {
    return false;
  }

  ServoOutputState& state = servoState(servo);
  writeServoAngle(servo, angleDegrees);
  state.targetAngleDegrees = angleDegrees;
  state.slewRateDegreesPerSecond = 0.0f;
  state.lastSlewUpdateMs = 0;
  state.slewActive = false;
  return true;
}

bool beginServoSlew(ServoId servo, float targetAngleDegrees,
                    float maximumSpeedDegreesPerSecond)
{
  if (!isValidServoAngle(targetAngleDegrees) ||
      !isfinite(maximumSpeedDegreesPerSecond) ||
      maximumSpeedDegreesPerSecond <
          kServoSlewMinimumSpeedDegreesPerSecond ||
      maximumSpeedDegreesPerSecond >
          kServoSlewMaximumSpeedDegreesPerSecond ||
      !servoOutputCommandIsAllowed())
  {
    return false;
  }

  ServoOutputState& state = servoState(servo);
  // Sem realimentação física, um canal desligado não possui uma posição inicial
  // confiável. A Raspberry deve primeiro aplicar uma pose conhecida.
  if (!state.enabled)
  {
    return false;
  }

  state.targetAngleDegrees = targetAngleDegrees;
  state.slewRateDegreesPerSecond = maximumSpeedDegreesPerSecond;
  state.lastSlewUpdateMs = millis();
  state.slewActive = fabsf(
      state.targetAngleDegrees - state.angleDegrees) > 0.001f;
  return true;
}

void updateServoSlewMotion()
{
  bool hasActiveSlew = false;
  for (size_t index = 0; index < kServoOutputCount; ++index)
  {
    hasActiveSlew = hasActiveSlew || servoOutputStates[index].slewActive;
  }
  if (!hasActiveSlew)
  {
    return;
  }

  if (!servoOutputCommandIsAllowed())
  {
    return;
  }

  const uint32_t nowMs = millis();
  for (size_t index = 0; index < kServoOutputCount; ++index)
  {
    ServoOutputState& state = servoOutputStates[index];
    if (!state.enabled || !state.slewActive)
    {
      continue;
    }

    const uint32_t elapsedSinceUpdateMs =
        nowMs - state.lastSlewUpdateMs;
    if (elapsedSinceUpdateMs < kServoSlewUpdateIntervalMs)
    {
      continue;
    }
    const uint32_t elapsedMs = min(
        elapsedSinceUpdateMs,
        kServoSlewMaximumElapsedMs);
    state.lastSlewUpdateMs = nowMs;

    const float difference =
        state.targetAngleDegrees - state.angleDegrees;
    const float maximumStep =
        state.slewRateDegreesPerSecond * elapsedMs / 1000.0f;
    const float nextAngle =
        fabsf(difference) <= maximumStep
            ? state.targetAngleDegrees
            : state.angleDegrees + copysignf(maximumStep, difference);
    writeServoAngle(static_cast<ServoId>(index), nextAngle);
    if (fabsf(state.targetAngleDegrees - state.angleDegrees) <= 0.001f)
    {
      state.angleDegrees = state.targetAngleDegrees;
      state.slewActive = false;
    }
  }
}

bool applyServoPose(float armDegrees, float wristDegrees,
                    float gripperDegrees)
{
  // Valida a pose inteira antes de movimentar o primeiro mecanismo. Assim, um
  // campo inválido nunca deixa uma programação predefinida aplicada pela metade.
  if (!isValidServoAngle(armDegrees) ||
      !isValidServoAngle(wristDegrees) ||
      !isValidServoAngle(gripperDegrees))
  {
    return false;
  }

  return applyServoAngle(ServoId::Arm, armDegrees) &&
         applyServoAngle(ServoId::Wrist, wristDegrees) &&
         applyServoAngle(ServoId::Gripper, gripperDegrees);
}

void zeroMotorPwmOutputs()
{
  writeMotorPwm(kLeftMotorIn1Pin, kLeftMotorIn1Channel, 0);
  writeMotorPwm(kLeftMotorIn2Pin, kLeftMotorIn2Channel, 0);
  writeMotorPwm(kRightMotorIn1Pin, kRightMotorIn1Channel, 0);
  writeMotorPwm(kRightMotorIn2Pin, kRightMotorIn2Channel, 0);
  currentLeftPower = 0.0f;
  currentRightPower = 0.0f;
}

void keepMotorDriverEnabled();

void stopMotorOutputs()
{
  // A parada mantém o DRV8833 habilitado e zera somente IN1/IN2. Isso evita
  // repetir o tempo de inicialização do driver a cada novo movimento.
  keepMotorDriverEnabled();
  zeroMotorPwmOutputs();
}

bool beginServoCalibrationMode()
{
  if (!pca9685Ready || emergencyStopActive || calibrationActive ||
      servoHoldActive)
  {
    return false;
  }

#ifdef OBR_ESP32_RASPBERRY_MODE
  const uint32_t nowMs = millis();
  if (!raspberrySystemReady ||
      nowMs - lastRaspberrySystemReadyMs > kRaspberrySystemReadyTimeoutMs)
  {
    return false;
  }
#endif

  // Entrar neste modo sempre zera a tração e começa sem sinal de servo. O
  // operador precisa acionar explicitamente o primeiro pulso pelo dashboard.
  stopMotorOutputs();
  dashboardArmed = false;
  disableAllServoOutputs();
  servoCalibrationActive = true;
  lastServoCalibrationCommandMs = millis();
  return true;
}

void endServoCalibrationMode()
{
  disableAllServoOutputs();
  servoCalibrationActive = false;
}

bool applyServoCalibrationPulse(ServoId servo, uint16_t pulseUs)
{
  if (!servoCalibrationActive || !pca9685Ready || emergencyStopActive ||
      calibrationActive ||
      pulseUs < kServoCalibrationAbsoluteMinimumPulseUs ||
      pulseUs > kServoCalibrationAbsoluteMaximumPulseUs)
  {
    return false;
  }

#ifdef OBR_ESP32_RASPBERRY_MODE
  const uint32_t nowMs = millis();
  if (!raspberrySystemReady ||
      nowMs - lastRaspberrySystemReadyMs > kRaspberrySystemReadyTimeoutMs)
  {
    return false;
  }
#endif

  // Somente um canal recebe pulso bruto por vez. Isso evita que outro
  // mecanismo permaneça exercendo força enquanto o operador observa o atual.
  disableAllServoOutputs();
  const ServoOutputConfig& config = servoConfig(servo);
  ServoOutputState& state = servoState(servo);
  pca9685.setPWM(config.channel, 0, pca9685TicksForPulse(pulseUs));
  state.angleDegrees = -1.0f;
  state.pulseUs = pulseUs;
  state.enabled = true;
  state.targetAngleDegrees = -1.0f;
  state.slewRateDegreesPerSecond = 0.0f;
  state.lastSlewUpdateMs = 0;
  state.slewActive = false;
  servoCalibrationSelectedIndex = static_cast<int8_t>(servoIndex(servo));
  lastServoCalibrationCommandMs = millis();
  return true;
}

bool saveServoCalibration(ServoId servo, uint16_t pulseAtZeroUs,
                          uint16_t pulseAt180Us)
{
  if (!servoCalibrationActive ||
      pulseAtZeroUs < kServoCalibrationAbsoluteMinimumPulseUs ||
      pulseAtZeroUs > kServoCalibrationAbsoluteMaximumPulseUs ||
      pulseAt180Us < kServoCalibrationAbsoluteMinimumPulseUs ||
      pulseAt180Us > kServoCalibrationAbsoluteMaximumPulseUs)
  {
    return false;
  }

  const uint16_t minimumPulseUs = min(pulseAtZeroUs, pulseAt180Us);
  const uint16_t maximumPulseUs = max(pulseAtZeroUs, pulseAt180Us);
  const ServoCalibration calibration = {
      minimumPulseUs, maximumPulseUs, pulseAtZeroUs > pulseAt180Us};
  if (!isValidServoCalibration(calibration) ||
      !persistServoCalibration(servo, calibration))
  {
    return false;
  }

  // A RAM só muda depois da confirmação de escrita na NVS. O canal é desligado
  // para o valor bruto usado na busca não permanecer aplicado após salvar.
  servoCalibration(servo) = calibration;
  disableAllServoOutputs();
  lastServoCalibrationCommandMs = millis();
  return true;
}

void keepMotorDriverEnabled()
{
  // Reafirma HIGH sem alternar nSLEEP e sem repetir o tempo de wake. Esta
  // escrita ocorre em todo comando para garantir a habilitação do driver
  // mesmo quando somente um dos lados recebe potência.
  gpio_set_level(static_cast<gpio_num_t>(kMotorSleepPin), 1);
  motorDriverAwake = true;
}

void enableMotorDriver()
{
  // O driver é habilitado uma única vez, depois que os quatro PWMs já estão
  // em zero. O tempo de estabilização ocorre apenas durante o setup().
  zeroMotorPwmOutputs();
  keepMotorDriverEnabled();
  delayMicroseconds(kMotorDriverWakeDelayUs);
}

void setMotorSide(uint8_t in1Pin, uint8_t in1Channel, uint8_t in2Pin,
                  uint8_t in2Channel, float power, bool inverted)
{
  const float directedPower = inverted ? -power : power;
  const uint16_t duty = static_cast<uint16_t>(fabs(directedPower) * kMotorPwmMaxDuty);

  // Zera o sentido oposto antes de aplicar PWM para nunca comandar uma
  // mudança de direção com as duas entradas ativas por engano.
  if (directedPower > 0.0f)
  {
    writeMotorPwm(in2Pin, in2Channel, 0);
    writeMotorPwm(in1Pin, in1Channel, duty);
  }
  else if (directedPower < 0.0f)
  {
    writeMotorPwm(in1Pin, in1Channel, 0);
    writeMotorPwm(in2Pin, in2Channel, duty);
  }
  else
  {
    writeMotorPwm(in1Pin, in1Channel, 0);
    writeMotorPwm(in2Pin, in2Channel, 0);
  }
}

void applyMotorPowers(float leftPower, float rightPower)
{
  // Os dois lados são atualizados na mesma passagem do loop. A diferença entre
  // as escritas LEDC é de apenas microssegundos e não envolve o nSLEEP.
  setMotorSide(kLeftMotorIn1Pin, kLeftMotorIn1Channel, kLeftMotorIn2Pin,
               kLeftMotorIn2Channel, leftPower, kLeftMotorInverted);
  setMotorSide(kRightMotorIn1Pin, kRightMotorIn1Channel, kRightMotorIn2Pin,
               kRightMotorIn2Channel, rightPower, kRightMotorInverted);
  currentLeftPower = leftPower;
  currentRightPower = rightPower;
}

void applyMotorCommand(float leftPower, float rightPower, ControlSource source)
{
  if (emergencyStopActive || calibrationActive || calibrationStopLatched ||
      servoCalibrationActive ||
      (source == ControlSource::Dashboard && !dashboardArmed))
  {
    // A calibração dos servos nunca aceita tração, mesmo que uma origem envie
    // por engano um comando de motor diferente de zero durante o ajuste.
    stopMotorOutputs();
    return;
  }

  keepMotorDriverEnabled();

  const float safeLeftCommand = safeMotorCommand(leftPower);
  const float safeRightCommand = safeMotorCommand(rightPower);

  if (safeLeftCommand == 0.0f && safeRightCommand == 0.0f)
  {
    stopMotorOutputs();
    controlSource = source;
    lastMotorCommandMs = millis();
    return;
  }

  controlSource = source;
  lastMotorCommandMs = millis();

  // Cada lado é independente. As rodas omni permitem parar um lado sem que o
  // firmware invente movimento no outro, e o duty aplicado é exatamente o recebido.
  applyMotorPowers(safeLeftCommand, safeRightCommand);
}

void setupMotors()
{
  // Mantém nSLEEP em LOW até que o periférico PWM esteja configurado e com
  // as quatro saídas zeradas. Depois disso, o driver permanece habilitado.
  forceMotorPinsLowImmediately();
  attachMotorPwm(kLeftMotorIn1Pin, kLeftMotorIn1Channel);
  attachMotorPwm(kLeftMotorIn2Pin, kLeftMotorIn2Channel);
  attachMotorPwm(kRightMotorIn1Pin, kRightMotorIn1Channel);
  attachMotorPwm(kRightMotorIn2Pin, kRightMotorIn2Channel);
  enableMotorDriver();
}

bool i2cDeviceResponds(uint8_t address)
{
  Wire.beginTransmission(address);
  return Wire.endTransmission() == 0;
}

void setupOled()
{
  if (i2cDeviceResponds(kOledPrimaryAddress))
  {
    oledAddress = kOledPrimaryAddress;
  }
  else if (i2cDeviceResponds(kOledSecondaryAddress))
  {
    oledAddress = kOledSecondaryAddress;
  }

  if (oledAddress == 0)
  {
    return;
  }

  // O Wire já usa SDA13/SCL14. periphBegin=false impede a biblioteca do OLED
  // de reiniciar o I2C nos pinos padrão da placa e desconectar MPU/PCA9685.
  oledReady = oled.begin(SSD1306_SWITCHCAPVCC, oledAddress, true, false);
  if (!oledReady)
  {
    oledAddress = 0;
    return;
  }

  oled.clearDisplay();
  oled.setTextWrap(false);
  oled.setTextColor(SSD1306_WHITE);
  oled.drawRoundRect(0, 0, kOledWidth, kOledHeight, 4, SSD1306_WHITE);
  oled.setTextSize(1);
  oled.setCursor(25, 16);
  oled.print(F("OBR 2026"));
  oled.setCursor(19, 38);
  oled.print(F("INICIALIZANDO"));
  oled.display();
}

void drawCalibrationProgress(int completedSamples, int totalSamples)
{
  if (!oledReady)
  {
    return;
  }

  // Os pontos ao redor do centro formam uma animação circular. A posição
  // preenchida avança junto com as amostras reais coletadas pelo MPU6050.
  constexpr int8_t kOrbitX[] = {0, 6, 8, 6, 0, -6, -8, -6};
  constexpr int8_t kOrbitY[] = {-8, -6, 0, 6, 8, 6, 0, -6};
  constexpr int kOrbitPointCount = sizeof(kOrbitX) / sizeof(kOrbitX[0]);
  const int animationFrame =
      (completedSamples * kOrbitPointCount / totalSamples) % kOrbitPointCount;
  const int progressWidth = constrain(completedSamples * 100 / totalSamples, 0, 100);

  oled.clearDisplay();
  oled.drawRoundRect(0, 0, kOledWidth, kOledHeight, 4, SSD1306_WHITE);
  oled.setTextColor(SSD1306_WHITE);
  oled.setTextSize(1);
  oled.setCursor(34, 4);
  oled.print(F("CALIBRANDO"));

  for (int point = 0; point < kOrbitPointCount; ++point)
  {
    const int16_t pointX = 64 + kOrbitX[point];
    const int16_t pointY = 27 + kOrbitY[point];
    if (point == animationFrame)
    {
      oled.fillCircle(pointX, pointY, 2, SSD1306_WHITE);
    }
    else
    {
      oled.drawPixel(pointX, pointY, SSD1306_WHITE);
    }
  }

  oled.setCursor(40, 39);
  oled.print(F("NAO MOVA"));
  oled.drawRoundRect(12, 52, 104, 8, 3, SSD1306_WHITE);
  if (progressWidth > 0)
  {
    oled.fillRoundRect(14, 54, progressWidth, 4, 1, SSD1306_WHITE);
  }
  oled.display();
}

void drawCalibrationResult(bool succeeded)
{
  if (!oledReady)
  {
    return;
  }

  oled.clearDisplay();
  oled.drawRoundRect(0, 0, kOledWidth, kOledHeight, 4, SSD1306_WHITE);
  oled.setTextColor(SSD1306_WHITE);
  oled.setTextSize(1);
  oled.setCursor(34, 4);
  oled.print(F("CALIBRACAO"));
  oled.drawCircle(23, 36, 12, SSD1306_WHITE);

  if (succeeded)
  {
    // O símbolo de confirmação permanece grande e legível mesmo à distância.
    oled.drawLine(16, 36, 21, 42, SSD1306_WHITE);
    oled.drawLine(21, 42, 31, 30, SSD1306_WHITE);
    oled.setTextSize(2);
    oled.setCursor(43, 24);
    oled.print(F("PRONTO"));
    oled.setTextSize(1);
    oled.setCursor(47, 45);
    oled.print(F("SENSORES OK"));
  }
  else
  {
    oled.drawLine(17, 30, 29, 42, SSD1306_WHITE);
    oled.drawLine(29, 30, 17, 42, SSD1306_WHITE);
    oled.setTextSize(2);
    oled.setCursor(43, 24);
    oled.print(F("FALHOU"));
    oled.setTextSize(1);
    oled.setCursor(47, 45);
    oled.print(F("VERIFIQUE MPU"));
  }
  oled.display();
}

void calibrateGyroscopeBias()
{
  // A calibração ocorre no boot ou após uma solicitação de reset. O robô deve
  // permanecer parado para reduzir a deriva nas leituras de giro e rampa.
  constexpr int kCalibrationSamples = 300;
  constexpr int kOledProgressUpdateSamples = 25;
  float gyroYSum = 0.0f;
  float gyroZSum = 0.0f;
  for (int sample = 0; sample < kCalibrationSamples; ++sample)
  {
    if (sample % kOledProgressUpdateSamples == 0)
    {
      drawCalibrationProgress(sample, kCalibrationSamples);
    }

    sensors_event_t accel;
    sensors_event_t gyro;
    sensors_event_t temperature;
    mpu.getEvent(&accel, &gyro, &temperature);
    gyroYSum += gyro.gyro.y;
    gyroZSum += gyro.gyro.z;
    delay(3);
  }
  gyroYBias = gyroYSum / kCalibrationSamples;
  gyroZBias = gyroZSum / kCalibrationSamples;
  drawCalibrationProgress(kCalibrationSamples, kCalibrationSamples);
}

void resetEncoderData()
{
  portENTER_CRITICAL(&encoderMux);
  leftEncoderCount = 0;
  rightEncoderCount = 0;
  portEXIT_CRITICAL(&encoderMux);
  lastLeftEncoderRateCount = 0;
  lastRightEncoderRateCount = 0;
  sensors.leftEncoderRate = 0.0f;
  sensors.rightEncoderRate = 0.0f;
  lastEncoderRateMs = millis();
}

void resetSensorMeasurements()
{
  // Mantém a tensão da bateria disponível, mas limpa medidas de navegação que
  // dependem de posição, movimento ou de uma referência inicial do MPU6050.
  sensors.ultrasonicDistanceCm = -1.0f;
  sensors.ultrasonicValid = false;
  sensors.accelX = 0.0f;
  sensors.accelY = 0.0f;
  sensors.accelZ = 0.0f;
  sensors.gyroX = 0.0f;
  sensors.gyroY = 0.0f;
  sensors.gyroZ = 0.0f;
  sensors.yawZ = 0.0f;
  sensors.rampAngleDegrees = 0.0f;
  sensors.imuTemperatureCelsius = 0.0f;
  filteredGyroZ = 0.0f;
  gyroFilterInitialized = false;
  rampAngleInitialized = false;
  lastMpuIntegrationUs = micros();

  portENTER_CRITICAL(&ultrasonicMux);
  ultrasonicWaitingForEcho = false;
  ultrasonicSampleAvailable = false;
  ultrasonicEchoStartUs = 0;
  ultrasonicEchoDurationUs = 0;
  portEXIT_CRITICAL(&ultrasonicMux);

  resetEncoderData();
}

void runSensorCalibration()
{
  // A calibração sempre começa com motores e servos parados e desabilita o
  // controle de bancada. O E-Stop existente é preservado e nunca é liberado aqui.
  dashboardArmed = false;
  stopMotorOutputs();
  endServoCalibrationMode();
  controlSource = ControlSource::None;
  calibrationActive = true;
  calibrationStopLatched = true;
  Serial.println("CALIBRATION,START");

  if (oledReady && oledAlertContrastModified)
  {
    // A calibração desenha a própria página dentro de um trecho bloqueante.
    // Por isso, restaura o brilho antes de iniciar as amostras do MPU6050.
    oled.dim(false);
    oledAlertContrastModified = false;
  }

  resetSensorMeasurements();
  if (mpuReady)
  {
    calibrateGyroscopeBias();
  }

  drawCalibrationResult(mpuReady);
  if (oledReady)
  {
    // Mantém o resultado visível sem liberar os motores durante a mensagem.
    delay(kOledCalibrationResultDurationMs);
  }

  lastMotorCommandMs = millis();
  calibrationActive = false;
  Serial.println(mpuReady ? "CALIBRATION,DONE" : "CALIBRATION,FAILED");
}

void setupI2cDevices()
{
  Wire.begin(kI2cSdaPin, kI2cSclPin, kI2cFrequencyHz);
  setupOled();

  if (mpu.begin(kMpu6050PrimaryAddress, &Wire))
  {
    mpuAddress = kMpu6050PrimaryAddress;
    mpuReady = true;
  }
  else if (mpu.begin(kMpu6050SecondaryAddress, &Wire))
  {
    mpuAddress = kMpu6050SecondaryAddress;
    mpuReady = true;
  }

  if (mpuReady)
  {
    mpu.setAccelerometerRange(MPU6050_RANGE_8_G);
    mpu.setGyroRange(MPU6050_RANGE_500_DEG);
    mpu.setFilterBandwidth(MPU6050_BAND_21_HZ);
    calibrateGyroscopeBias();
  }

  drawCalibrationResult(mpuReady);
  if (oledReady)
  {
    delay(kOledCalibrationResultDurationMs);
  }

  pca9685Ready = i2cDeviceResponds(kPca9685Address) && pca9685.begin();
  if (pca9685Ready)
  {
    pca9685.setPWMFreq(kPca9685FrequencyHz);
    for (uint8_t channel = 0; channel < 16; ++channel)
    {
      // Todos os canais começam em FULL_OFF. Braço, pulso e garra só recebem
      // sinal após um comando válido, evitando movimento inesperado na partida.
      pca9685.setPWM(channel, 0, 4096);
    }
  }
}

bool isRemoteOledPageActive(uint32_t nowMs)
{
  if (!remoteOledActive)
  {
    return false;
  }

  // A subtração com sinal mantém a comparação correta mesmo quando millis()
  // ultrapassa o limite de 32 bits após várias semanas de funcionamento.
  if (static_cast<int32_t>(nowMs - remoteOledExpiresAtMs) >= 0)
  {
    remoteOledActive = false;
    return false;
  }
  return true;
}

bool isRaspberrySystemReady(uint32_t nowMs)
{
#ifdef OBR_ESP32_RASPBERRY_MODE
  if (raspberrySystemReady &&
      nowMs - lastRaspberrySystemReadyMs > kRaspberrySystemReadyTimeoutMs)
  {
    // A ausência do heartbeat indica que o serviço da Raspberry reiniciou ou
    // caiu. A OLED volta ao boot e os servos deixam de repetir comandos antigos.
    raspberrySystemReady = false;
    endServoCalibrationMode();
  }
#else
  (void)nowMs;
#endif
  return raspberrySystemReady;
}

void drawCenteredOledText(const char* text, int16_t y, uint8_t textSize)
{
  int16_t textX;
  int16_t textY;
  uint16_t textWidth;
  uint16_t textHeight;
  oled.setTextSize(textSize);
  oled.getTextBounds(text, 0, 0, &textX, &textY, &textWidth, &textHeight);
  int16_t centeredX = (kOledWidth - static_cast<int16_t>(textWidth)) / 2;
  if (centeredX < 3)
  {
    centeredX = 3;
  }
  oled.setCursor(centeredX, y);
  oled.print(text);
}

void drawEmergencyOledPage()
{
  oled.clearDisplay();
  oled.drawRoundRect(0, 0, kOledWidth, kOledHeight, 4, SSD1306_WHITE);
  oled.setTextColor(SSD1306_WHITE);
  oled.setTextSize(1);
  oled.setCursor(28, 4);
  oled.print(F("EMERGENCIA"));
  oled.drawLine(3, 15, 124, 15, SSD1306_WHITE);
  drawCenteredOledText("E-STOP ATIVO", 23, 1);
  drawCenteredOledText("MOTORES", 37, 1);
  drawCenteredOledText("BLOQUEADOS", 49, 1);
  oled.display();
}

void drawSystemStartingOledPage(uint32_t nowMs)
{
  constexpr int8_t kSpinnerX[8] = {0, 6, 9, 6, 0, -6, -9, -6};
  constexpr int8_t kSpinnerY[8] = {-9, -6, 0, 6, 9, 6, 0, -6};
  const uint8_t activeDot = static_cast<uint8_t>((nowMs / 120) % 8);

  oled.clearDisplay();
  oled.drawRoundRect(0, 0, kOledWidth, kOledHeight, 4, SSD1306_WHITE);
  oled.setTextColor(SSD1306_WHITE);
  oled.setTextSize(1);
  oled.setCursor(25, 4);
  oled.print(F("OBR | SISTEMA"));
  oled.drawLine(3, 15, 124, 15, SSD1306_WHITE);

  // O indicador circular e a barra são animações indeterminadas: mostram que
  // o boot continua ativo sem inventar um percentual que a Raspberry não mede.
  for (uint8_t index = 0; index < 8; ++index)
  {
    const int16_t x = 17 + kSpinnerX[index];
    const int16_t y = 33 + kSpinnerY[index];
    if (index == activeDot)
    {
      oled.fillCircle(x, y, 2, SSD1306_WHITE);
    }
    else
    {
      oled.drawPixel(x, y, SSD1306_WHITE);
    }
  }

  oled.setCursor(34, 23);
  oled.print(F("INICIALIZANDO"));
  oled.setCursor(40, 37);
  oled.print(F("RASPBERRY PI"));

  constexpr uint8_t kBarTravel = 90;
  uint8_t barPosition = static_cast<uint8_t>((nowMs / 35) % (kBarTravel * 2));
  if (barPosition > kBarTravel)
  {
    barPosition = kBarTravel * 2 - barPosition;
  }
  oled.drawRoundRect(5, 50, 118, 8, 3, SSD1306_WHITE);
  oled.fillRoundRect(8 + barPosition, 53, 20, 2, 1, SSD1306_WHITE);
  oled.display();
}

void drawRemoteOledPage(uint32_t nowMs)
{
  oled.clearDisplay();
  oled.drawRoundRect(0, 0, kOledWidth, kOledHeight, 4, SSD1306_WHITE);
  oled.setTextColor(SSD1306_WHITE);
  oled.setTextSize(1);
  oled.setCursor(4, 4);
  oled.print(F("RPI | "));
  oled.print(remoteOledTitle[0] != '\0' ? remoteOledTitle : "MENSAGEM");
  oled.drawLine(3, 15, 124, 15, SSD1306_WHITE);

  // O conteúdo remoto usa somente a fonte nativa do SSD1306. Isso mantém o
  // desenho leve e garante que a atualização não atrase sensores ou motores.
  if (remoteOledSecondLine[0] == '\0')
  {
    drawCenteredOledText(remoteOledFirstLine, 30, 1);
  }
  else
  {
    drawCenteredOledText(remoteOledFirstLine, 23, 1);
    drawCenteredOledText(remoteOledSecondLine, 37, 1);
  }

  const uint32_t remainingMs = remoteOledExpiresAtMs - nowMs;
  char footer[18];
  snprintf(footer, sizeof(footer), "REMOTO | %lus",
           static_cast<unsigned long>((remainingMs + 999) / 1000));
  oled.drawLine(3, 51, 124, 51, SSD1306_WHITE);
  drawCenteredOledText(footer, 54, 1);
  oled.display();
}

uint8_t largestOledTextSize(const char* text, uint8_t maximumSize)
{
  // Quatro pixels de cada lado são a menor margem visual do alerta. Para
  // "VERDE", isso ainda permite usar tamanho 4 em uma tela de 128 pixels.
  constexpr int16_t kHorizontalMargin = 4;
  constexpr int16_t kAvailableWidth =
      kOledWidth - 2 * kHorizontalMargin;

  // A fonte nativa ocupa aproximadamente 6 pixels por caractere em cada nível.
  // getTextBounds() confirma a largura real para nunca cortar o alerta.
  for (uint8_t textSize = maximumSize; textSize > 1; --textSize)
  {
    int16_t textX;
    int16_t textY;
    uint16_t textWidth;
    uint16_t textHeight;
    oled.setTextSize(textSize);
    oled.getTextBounds(text, 0, 0, &textX, &textY, &textWidth, &textHeight);
    if (textWidth <= kAvailableWidth)
    {
      return textSize;
    }
  }
  return 1;
}

uint8_t oledAlertContrast(uint32_t nowMs)
{
  constexpr float kFullCycleRadians = 6.28318530718f;
  const uint32_t elapsedMs = nowMs - remoteOledStartedAtMs;
  const float phase = static_cast<float>(
                            elapsedMs % kOledAlertPulsePeriodMs) /
                      static_cast<float>(kOledAlertPulsePeriodMs);
  // O cosseno começa no brilho máximo e cria uma transição contínua. O valor
  // mínimo permanece visível para o alerta poder ser lido durante todo o pulso.
  const float wave = 0.5f + 0.5f * cosf(phase * kFullCycleRadians);
  const float contrast = kOledAlertMinimumContrast +
                         wave * (kOledAlertMaximumContrast -
                                 kOledAlertMinimumContrast);
  return static_cast<uint8_t>(lroundf(contrast));
}

void applyOledAlertContrast(uint32_t nowMs)
{
  oled.ssd1306_command(SSD1306_SETCONTRAST);
  oled.ssd1306_command(oledAlertContrast(nowMs));
  oledAlertContrastModified = true;
}

void restoreNormalOledContrast()
{
  if (!oledAlertContrastModified)
  {
    return;
  }

  // A biblioteca restaura o contraste padrão correto para o tipo de alimentação
  // usado no begin(), evitando manter a tela normal artificialmente escura.
  oled.dim(false);
  oledAlertContrastModified = false;
}

void drawLargeRemoteOledPage(uint32_t nowMs)
{
  applyOledAlertContrast(nowMs);
  oled.clearDisplay();
  oled.setTextColor(SSD1306_WHITE);

  // Em módulos bicolores, as linhas 16 a 63 são fisicamente azuis. O texto
  // principal e o detalhe ficam inteiros nessa região; a cor não é programável.
  constexpr int16_t kBlueRegionTop = 16;
  constexpr int16_t kVerticalMargin = 2;
  constexpr int16_t kSecondaryTextY = 54;
  const bool hasSecondaryText = remoteOledSecondLine[0] != '\0';
  const int16_t primaryRegionTop = kBlueRegionTop + kVerticalMargin;
  const int16_t primaryRegionBottom = hasSecondaryText
                                          ? kSecondaryTextY - kVerticalMargin
                                          : kOledHeight - kVerticalMargin;
  const uint8_t primaryTextSize = largestOledTextSize(remoteOledFirstLine, 4);

  int16_t textX;
  int16_t textY;
  uint16_t textWidth;
  uint16_t textHeight;
  oled.setTextSize(primaryTextSize);
  oled.getTextBounds(remoteOledFirstLine, 0, 0, &textX, &textY,
                     &textWidth, &textHeight);
  const int16_t primaryY = primaryRegionTop +
      (primaryRegionBottom - primaryRegionTop -
       static_cast<int16_t>(textHeight)) / 2;
  drawCenteredOledText(remoteOledFirstLine, primaryY, primaryTextSize);

  if (hasSecondaryText)
  {
    drawCenteredOledText(remoteOledSecondLine, kSecondaryTextY, 1);
  }
  oled.display();
}

void updateOledIfDue()
{
  const uint32_t nowMs = millis();
  if (!oledReady || nowMs - lastOledRefreshMs < kOledRefreshIntervalMs)
  {
    return;
  }
  lastOledRefreshMs = nowMs;

  // Estados locais críticos sempre têm prioridade sobre mensagens da Raspberry.
  if (emergencyStopActive)
  {
    restoreNormalOledContrast();
    drawEmergencyOledPage();
    return;
  }
  if (calibrationActive)
  {
    restoreNormalOledContrast();
    return;
  }
  if (!isRaspberrySystemReady(nowMs))
  {
    restoreNormalOledContrast();
    drawSystemStartingOledPage(nowMs);
    return;
  }
  if (isRemoteOledPageActive(nowMs))
  {
    if (remoteOledLargeLayout)
    {
      drawLargeRemoteOledPage(nowMs);
    }
    else
    {
      restoreNormalOledContrast();
      drawRemoteOledPage(nowMs);
    }
    return;
  }

  restoreNormalOledContrast();

  char batteryText[10] = "--.--V";
  char yawText[8] = "  --";
  char rampText[8] = "  --";
  if (isfinite(sensors.batteryVoltage))
  {
    snprintf(batteryText, sizeof(batteryText), "%5.2fV", sensors.batteryVoltage);
  }
  if (mpuReady && isfinite(sensors.yawZ))
  {
    snprintf(yawText, sizeof(yawText), "%+4.0f", sensors.yawZ);
  }
  if (mpuReady && isfinite(sensors.rampAngleDegrees))
  {
    snprintf(rampText, sizeof(rampText), "%+4.0f", sensors.rampAngleDegrees);
  }

  const float batteryGauge = constrain(
      (sensors.batteryVoltage - kBatteryGaugeMinimumVoltage) /
          (kBatteryGaugeMaximumVoltage - kBatteryGaugeMinimumVoltage),
      0.0f, 1.0f);
  const int16_t batteryFillWidth = static_cast<int16_t>(batteryGauge * 67.0f);

  oled.clearDisplay();
  oled.drawRoundRect(0, 0, kOledWidth, kOledHeight, 4, SSD1306_WHITE);

  // Nos OLEDs bicolores, as primeiras 16 linhas são fisicamente amarelas.
  // Título e barra ficam nessa faixa para criar contraste sem cortar a tensão.
  oled.setTextColor(SSD1306_WHITE);
  oled.setTextSize(1);
  oled.setCursor(4, 4);
  oled.print(F("BATERIA"));

  oled.drawRoundRect(50, 3, 73, 9, 3, SSD1306_WHITE);
  if (batteryFillWidth > 0)
  {
    oled.fillRoundRect(53, 6, batteryFillWidth, 3, 1, SSD1306_WHITE);
  }

  // A tensão começa abaixo da linha 16 para permanecer completamente azul
  // nos displays SSD1306 que possuem duas cores definidas pelo próprio painel.
  oled.setTextColor(SSD1306_WHITE);
  oled.setTextSize(2);
  int16_t textX;
  int16_t textY;
  uint16_t textWidth;
  uint16_t textHeight;
  oled.getTextBounds(batteryText, 0, 0, &textX, &textY, &textWidth, &textHeight);
  oled.setCursor((kOledWidth - textWidth) / 2, 18);
  oled.print(batteryText);

  // A faixa inferior mantém giro e rampa disponíveis como informações
  // secundárias. Os sinais positivos e negativos facilitam testes de sentido.
  oled.drawLine(3, 39, 124, 39, SSD1306_WHITE);
  oled.drawLine(64, 42, 64, 60, SSD1306_WHITE);
  oled.setTextSize(1);
  oled.setCursor(5, 48);
  oled.print(F("GIR"));
  oled.setCursor(25, 48);
  oled.print(yawText);
  oled.drawCircle(57, 48, 1, SSD1306_WHITE);
  oled.setCursor(68, 48);
  oled.print(F("RMP"));
  oled.setCursor(89, 48);
  oled.print(rampText);
  oled.drawCircle(121, 48, 1, SSD1306_WHITE);
  oled.display();
}

void setupEncoders()
{
  pinMode(kLeftEncoderAPin, INPUT_PULLUP);
  pinMode(kLeftEncoderBPin, INPUT_PULLUP);
  pinMode(kRightEncoderAPin, INPUT_PULLUP);
  pinMode(kRightEncoderBPin, INPUT_PULLUP);
  previousLeftEncoderState =
      (digitalRead(kLeftEncoderAPin) << 1) | digitalRead(kLeftEncoderBPin);
  previousRightEncoderState =
      (digitalRead(kRightEncoderAPin) << 1) | digitalRead(kRightEncoderBPin);
  attachInterrupt(digitalPinToInterrupt(kLeftEncoderAPin), updateLeftEncoder, CHANGE);
  attachInterrupt(digitalPinToInterrupt(kLeftEncoderBPin), updateLeftEncoder, CHANGE);
  attachInterrupt(digitalPinToInterrupt(kRightEncoderAPin), updateRightEncoder, CHANGE);
  attachInterrupt(digitalPinToInterrupt(kRightEncoderBPin), updateRightEncoder, CHANGE);
}

void setupUltrasonic()
{
  pinMode(kFrontUltrasonicTriggerPin, OUTPUT);
  pinMode(kFrontUltrasonicEchoPin, INPUT);
  digitalWrite(kFrontUltrasonicTriggerPin, LOW);
  attachInterrupt(digitalPinToInterrupt(kFrontUltrasonicEchoPin), captureUltrasonicEcho, CHANGE);
}

void triggerUltrasonicIfDue()
{
  const uint32_t nowMs = millis();
  const uint32_t nowUs = micros();

  portENTER_CRITICAL(&ultrasonicMux);
  if (ultrasonicWaitingForEcho &&
      nowUs - ultrasonicTriggerUs > kUltrasonicTimeoutUs)
  {
    ultrasonicWaitingForEcho = false;
    ultrasonicEchoStartUs = 0;
    sensors.ultrasonicValid = false;
  }
  const bool canTrigger = !ultrasonicWaitingForEcho &&
                          nowMs - lastUltrasonicTriggerMs >= kUltrasonicIntervalMs;
  if (canTrigger)
  {
    ultrasonicWaitingForEcho = true;
    ultrasonicTriggerUs = nowUs;
    ultrasonicEchoStartUs = 0;
    lastUltrasonicTriggerMs = nowMs;
  }
  portEXIT_CRITICAL(&ultrasonicMux);

  if (canTrigger)
  {
    digitalWrite(kFrontUltrasonicTriggerPin, HIGH);
    delayMicroseconds(10);
    digitalWrite(kFrontUltrasonicTriggerPin, LOW);
  }
}

void consumeUltrasonicSample()
{
  uint32_t durationUs = 0;
  portENTER_CRITICAL(&ultrasonicMux);
  if (ultrasonicSampleAvailable)
  {
    durationUs = ultrasonicEchoDurationUs;
    ultrasonicSampleAvailable = false;
  }
  portEXIT_CRITICAL(&ultrasonicMux);

  if (durationUs == 0)
  {
    return;
  }

  const float distanceCm = durationUs * 0.0343f / 2.0f;
  sensors.ultrasonicValid = distanceCm >= 2.0f && distanceCm <= 400.0f;
  sensors.ultrasonicDistanceCm = sensors.ultrasonicValid ? distanceCm : -1.0f;
}

void readBatteryIfDue()
{
  const uint32_t nowMs = millis();
  if (nowMs - lastBatteryReadMs < kBatteryReadIntervalMs)
  {
    return;
  }
  lastBatteryReadMs = nowMs;

  constexpr int kSampleCount = 16;
  uint32_t millivoltSum = 0;
  for (int sample = 0; sample < kSampleCount; ++sample)
  {
    millivoltSum += analogReadMilliVolts(kBatteryAdcPin);
  }
  sensors.batteryAdcMillivolts = millivoltSum / kSampleCount;
  sensors.batteryVoltage =
      (sensors.batteryAdcMillivolts / 1000.0f) * kBatteryDividerRatio;
}

void readImuIfDue()
{
  const uint32_t nowMs = millis();
  if (!mpuReady || nowMs - lastImuReadMs < kImuReadIntervalMs)
  {
    return;
  }
  lastImuReadMs = nowMs;

  sensors_event_t accel;
  sensors_event_t gyro;
  sensors_event_t temperature;
  mpu.getEvent(&accel, &gyro, &temperature);

  const uint32_t nowUs = micros();
  const float deltaSeconds = lastMpuIntegrationUs == 0
                                 ? 0.0f
                                 : (nowUs - lastMpuIntegrationUs) / 1000000.0f;
  lastMpuIntegrationUs = nowUs;

  sensors.accelX = accel.acceleration.x;
  sensors.accelY = accel.acceleration.y;
  sensors.accelZ = accel.acceleration.z;
  sensors.gyroX = gyro.gyro.x * RAD_TO_DEG;
  sensors.gyroY = (gyro.gyro.y - gyroYBias) * RAD_TO_DEG;
  const float correctedGyroZ = (gyro.gyro.z - gyroZBias) * RAD_TO_DEG;

  if (!gyroFilterInitialized)
  {
    filteredGyroZ = correctedGyroZ;
    gyroFilterInitialized = true;
  }
  else
  {
    filteredGyroZ = kGyroLowPassAlpha * filteredGyroZ +
                    (1.0f - kGyroLowPassAlpha) * correctedGyroZ;
  }
  sensors.gyroZ = fabs(filteredGyroZ) < kGyroDeadbandDegreesPerSecond
                      ? 0.0f
                      : filteredGyroZ;
  sensors.imuTemperatureCelsius = temperature.temperature;

  const float accelRampAngle =
      atan2f(-sensors.accelX,
             sqrtf(sensors.accelY * sensors.accelY + sensors.accelZ * sensors.accelZ)) *
      RAD_TO_DEG * kRampAngleSign;
  const float rampGyroRate = sensors.gyroY * kRampAngleSign;
  if (!rampAngleInitialized || deltaSeconds <= 0.0f || deltaSeconds > 0.20f)
  {
    sensors.rampAngleDegrees = accelRampAngle;
    rampAngleInitialized = true;
  }
  else
  {
    const float filterAlpha =
        kRampFilterTimeConstantSeconds / (kRampFilterTimeConstantSeconds + deltaSeconds);
    sensors.rampAngleDegrees =
        filterAlpha * (sensors.rampAngleDegrees + rampGyroRate * deltaSeconds) +
        (1.0f - filterAlpha) * accelRampAngle;
  }

  sensors.yawZ += sensors.gyroZ * deltaSeconds;
  if (sensors.yawZ > 180.0f)
  {
    sensors.yawZ -= 360.0f;
  }
  else if (sensors.yawZ < -180.0f)
  {
    sensors.yawZ += 360.0f;
  }
}

void updateEncoderRatesIfDue()
{
  const uint32_t nowMs = millis();
  const uint32_t elapsedMs = nowMs - lastEncoderRateMs;
  if (elapsedMs < kEncoderRateIntervalMs)
  {
    return;
  }

  int32_t currentLeftCount;
  int32_t currentRightCount;
  portENTER_CRITICAL(&encoderMux);
  currentLeftCount = leftEncoderCount;
  currentRightCount = rightEncoderCount;
  portEXIT_CRITICAL(&encoderMux);

  sensors.leftEncoderRate =
      (currentLeftCount - lastLeftEncoderRateCount) * 1000.0f / elapsedMs;
  sensors.rightEncoderRate =
      (currentRightCount - lastRightEncoderRateCount) * 1000.0f / elapsedMs;
  lastLeftEncoderRateCount = currentLeftCount;
  lastRightEncoderRateCount = currentRightCount;
  lastEncoderRateMs = nowMs;
}

void updateStartButton()
{
  const uint32_t nowMs = millis();
  const bool sampledPressed = digitalRead(kStartButtonPin) == LOW;
  if (sampledPressed != rawStartButtonPressed)
  {
    // A janela começa novamente a cada oscilação elétrica. O estado estável
    // só muda quando a leitura permanece igual durante todo o debounce.
    rawStartButtonPressed = sampledPressed;
    lastButtonChangeMs = nowMs;
  }

  if (rawStartButtonPressed != startButtonPressed &&
      nowMs - lastButtonChangeMs >= kStartButtonDebounceMs)
  {
    startButtonPressed = rawStartButtonPressed;
    if (startButtonPressed)
    {
      startButtonPressedSinceMs = nowMs;
      startButtonLongPressHandled = false;
    }
    else
    {
      const uint32_t pressDurationMs = nowMs - startButtonPressedSinceMs;
      if (!startButtonLongPressHandled && startButtonPressedSinceMs != 0 &&
          pressDurationMs >= kStartButtonMinimumPressMs &&
          (lastStartButtonShortEventMs == 0 ||
           nowMs - lastStartButtonShortEventMs >= kStartButtonDuplicateGuardMs))
      {
        // O evento só é emitido ao soltar para distinguir um toque curto da
        // pressão de 5 segundos reservada à calibração dos sensores.
        Serial.println("START_BUTTON,SHORT");
        lastStartButtonShortEventMs = nowMs;
      }
      startButtonPressedSinceMs = 0;
      startButtonLongPressHandled = false;
    }
  }

  if (startButtonPressed && !startButtonLongPressHandled &&
      nowMs - startButtonPressedSinceMs >= kSensorCalibrationHoldMs)
  {
    startButtonLongPressHandled = true;
    runSensorCalibration();
  }
}

#ifndef OBR_ESP32_RASPBERRY_MODE
const char* controlSourceName()
{
  if (controlSource == ControlSource::Dashboard)
  {
    return "dashboard";
  }
  if (controlSource == ControlSource::Raspberry)
  {
    return "raspberry";
  }
  return "nenhuma";
}

void addJsonFloat(String& json, const char* name, float value, uint8_t digits = 3)
{
  json += ",\"";
  json += name;
  json += "\":";
  json += isfinite(value) ? String(value, static_cast<unsigned int>(digits)) : "0";
}

String telemetryJson()
{
  int32_t leftCount;
  int32_t rightCount;
  portENTER_CRITICAL(&encoderMux);
  leftCount = leftEncoderCount;
  rightCount = rightEncoderCount;
  portEXIT_CRITICAL(&encoderMux);

  String json;
  json.reserve(1100);
  json = '{';
  json += "\"uptimeMs\":" + String(millis());
  json += ",\"wifiClients\":" + String(WiFi.softAPgetStationNum());
  json += ",\"emergencyStop\":" + String(emergencyStopActive ? "true" : "false");
  json += ",\"dashboardArmed\":" + String(dashboardArmed ? "true" : "false");
  json += ",\"startButtonPressed\":" + String(startButtonPressed ? "true" : "false");
  json += ",\"calibrationActive\":" + String(calibrationActive ? "true" : "false");
  json += ",\"mpuReady\":" + String(mpuReady ? "true" : "false");
  json += ",\"mpuAddress\":" + String(mpuAddress);
  json += ",\"pca9685Ready\":" + String(pca9685Ready ? "true" : "false");
  json += ",\"oledReady\":" + String(oledReady ? "true" : "false");
  json += ",\"oledAddress\":" + String(oledAddress);
  json += ",\"motorDriverAwake\":" + String(motorDriverAwake ? "true" : "false");
  json += ",\"motorSleepPinHigh\":" +
          String(gpio_get_level(static_cast<gpio_num_t>(kMotorSleepPin)) ? "true" : "false");
  json += ",\"ultrasonicValid\":" + String(sensors.ultrasonicValid ? "true" : "false");
  json += ",\"controlSource\":\"" + String(controlSourceName()) + "\"";
  json += ",\"lastCommandAgeMs\":" + String(millis() - lastMotorCommandMs);
  json += ",\"leftEncoderCount\":" + String(leftCount);
  json += ",\"rightEncoderCount\":" + String(rightCount);
  addJsonFloat(json, "batteryVoltage", sensors.batteryVoltage);
  json += ",\"batteryAdcMillivolts\":" + String(sensors.batteryAdcMillivolts);
  addJsonFloat(json, "ultrasonicDistanceCm", sensors.ultrasonicDistanceCm);
  addJsonFloat(json, "leftMotorPower", currentLeftPower);
  addJsonFloat(json, "rightMotorPower", currentRightPower);
  addJsonFloat(json, "leftEncoderRate", sensors.leftEncoderRate);
  addJsonFloat(json, "rightEncoderRate", sensors.rightEncoderRate);
  addJsonFloat(json, "accelX", sensors.accelX);
  addJsonFloat(json, "accelY", sensors.accelY);
  addJsonFloat(json, "accelZ", sensors.accelZ);
  addJsonFloat(json, "gyroX", sensors.gyroX);
  addJsonFloat(json, "gyroY", sensors.gyroY);
  addJsonFloat(json, "gyroZ", sensors.gyroZ);
  addJsonFloat(json, "yawZ", sensors.yawZ);
  addJsonFloat(json, "rampAngleDegrees", sensors.rampAngleDegrees);
  addJsonFloat(json, "imuTemperatureCelsius", sensors.imuTemperatureCelsius);
  json += '}';
  return json;
}

void sendJsonResponse(int statusCode, const String& body)
{
  server.sendHeader("Cache-Control", "no-store");
  server.send(statusCode, "application/json", body);
}

bool readValidatedMotorArgument(const char* name, float& value)
{
  if (!server.hasArg(name))
  {
    return false;
  }
  const String text = server.arg(name);
  char* end = nullptr;
  value = strtof(text.c_str(), &end);
  return end != text.c_str() && *end == '\0' && isfinite(value) &&
         value >= -kMaximumMotorPower && value <= kMaximumMotorPower;
}

void setupDashboardRoutes()
{
  server.on("/", HTTP_GET, []()
            {
              // Impede que o celular continue mostrando uma versão antiga do
              // dashboard depois que um novo firmware é gravado na ESP32.
              server.sendHeader("Cache-Control", "no-store, no-cache, must-revalidate, max-age=0");
              server.sendHeader("Pragma", "no-cache");
              server.send_P(200, "text/html; charset=utf-8", DASHBOARD_HTML); });
  server.on("/api/telemetry", HTTP_GET, []()
            { sendJsonResponse(200, telemetryJson()); });
  server.on("/api/arm", HTTP_POST, []()
            {
              stopMotorOutputs();
              if (emergencyStopActive)
              {
                sendJsonResponse(409, "{\"error\":\"Libere o E-Stop antes de habilitar\"}");
                return;
              }
              calibrationStopLatched = false;
              dashboardArmed = true;
              controlSource = ControlSource::Dashboard;
              lastMotorCommandMs = millis();
              sendJsonResponse(200, "{\"ok\":true}"); });
  server.on("/api/disarm", HTTP_ANY, []()
            {
              dashboardArmed = false;
              stopMotorOutputs();
              endServoCalibrationMode();
              sendJsonResponse(200, "{\"ok\":true}"); });
  server.on("/api/estop", HTTP_POST, []()
            {
              emergencyStopActive = true;
              dashboardArmed = false;
              stopMotorOutputs();
              endServoCalibrationMode();
              sendJsonResponse(200, "{\"ok\":true}"); });
  server.on("/api/clear-estop", HTTP_POST, []()
            {
              stopMotorOutputs();
              dashboardArmed = false;
              emergencyStopActive = false;
              sendJsonResponse(200, "{\"ok\":true}"); });
  server.on("/api/motor", HTTP_POST, []()
            {
              float leftPower;
              float rightPower;
              if (!readValidatedMotorArgument("left", leftPower) ||
                  !readValidatedMotorArgument("right", rightPower))
              {
                stopMotorOutputs();
                sendJsonResponse(400, "{\"error\":\"Potencia fora do limite seguro\"}");
                return;
              }
              if (!dashboardArmed || emergencyStopActive)
              {
                stopMotorOutputs();
                sendJsonResponse(409, "{\"error\":\"Motores nao habilitados\"}");
                return;
              }
              applyMotorCommand(leftPower, rightPower, ControlSource::Dashboard);
              sendJsonResponse(200, "{\"ok\":true}"); });
  server.on("/api/reset-encoders", HTTP_POST, []()
            {
              resetEncoderData();
              sendJsonResponse(200, "{\"ok\":true}"); });
  server.on("/api/calibrate-sensors", HTTP_POST, []()
            {
              runSensorCalibration();
              sendJsonResponse(mpuReady ? 200 : 503,
                               mpuReady ? "{\"ok\":true}" : "{\"error\":\"MPU6050 indisponivel\"}"); });
  server.onNotFound([]()
                    { sendJsonResponse(404, "{\"error\":\"Endpoint nao encontrado\"}"); });
  server.begin();
}
#endif

void sendUartError(const char* message)
{
  Serial.print("ERR,");
  Serial.println(message);
}

int8_t hexadecimalNibble(char character)
{
  if (character >= '0' && character <= '9')
  {
    return character - '0';
  }
  if (character >= 'A' && character <= 'F')
  {
    return character - 'A' + 10;
  }
  if (character >= 'a' && character <= 'f')
  {
    return character - 'a' + 10;
  }
  return -1;
}

bool decodeRemoteOledText(const char* encoded, char* destination,
                          size_t destinationSize)
{
  if (strcmp(encoded, "-") == 0)
  {
    destination[0] = '\0';
    return true;
  }

  const size_t encodedLength = strlen(encoded);
  if (encodedLength == 0 || (encodedLength % 2) != 0 ||
      encodedLength / 2 >= destinationSize)
  {
    return false;
  }

  for (size_t index = 0; index < encodedLength; index += 2)
  {
    const int8_t high = hexadecimalNibble(encoded[index]);
    const int8_t low = hexadecimalNibble(encoded[index + 1]);
    if (high < 0 || low < 0)
    {
      return false;
    }

    const char decoded = static_cast<char>((high << 4) | low);
    // A fonte padrão da biblioteca exibe ASCII imprimível. Outros bytes são
    // rejeitados para não mostrar símbolos corrompidos nem controles na tela.
    if (decoded < 32 || decoded > 126)
    {
      return false;
    }
    destination[index / 2] = decoded;
  }
  destination[encodedLength / 2] = '\0';
  return true;
}

bool applyRemoteOledCommand(const char* line)
{
  unsigned long durationMs = 0;
  char encodedTitle[kRemoteOledTitleMaxLength * 2 + 1] = {};
  char encodedFirstLine[kRemoteOledLineMaxLength * 2 + 1] = {};
  char encodedSecondLine[kRemoteOledLineMaxLength * 2 + 1] = {};
  int consumedCharacters = 0;
  const int parsedFields = sscanf(
      line, "OLED,%lu,%24[^,],%40[^,],%40s%n", &durationMs, encodedTitle,
      encodedFirstLine, encodedSecondLine, &consumedCharacters);
  if (parsedFields != 4 ||
      consumedCharacters != static_cast<int>(strlen(line)) ||
      durationMs < kRemoteOledMinimumDurationMs ||
      durationMs > kRemoteOledMaximumDurationMs)
  {
    return false;
  }

  char title[kRemoteOledTitleMaxLength + 1] = {};
  char firstLine[kRemoteOledLineMaxLength + 1] = {};
  char secondLine[kRemoteOledLineMaxLength + 1] = {};
  if (!decodeRemoteOledText(encodedTitle, title, sizeof(title)) ||
      !decodeRemoteOledText(encodedFirstLine, firstLine, sizeof(firstLine)) ||
      !decodeRemoteOledText(encodedSecondLine, secondLine, sizeof(secondLine)))
  {
    return false;
  }
  if (title[0] == '\0' && firstLine[0] == '\0' && secondLine[0] == '\0')
  {
    return false;
  }

  memcpy(remoteOledTitle, title, sizeof(remoteOledTitle));
  memcpy(remoteOledFirstLine, firstLine, sizeof(remoteOledFirstLine));
  memcpy(remoteOledSecondLine, secondLine, sizeof(remoteOledSecondLine));
  remoteOledStartedAtMs = millis();
  remoteOledExpiresAtMs = remoteOledStartedAtMs +
                          static_cast<uint32_t>(durationMs);
  remoteOledLargeLayout = false;
  remoteOledActive = true;
  return true;
}

bool applyLargeRemoteOledCommand(const char* line)
{
  unsigned long durationMs = 0;
  char encodedPrimaryText[kRemoteOledLineMaxLength * 2 + 1] = {};
  char encodedSecondaryText[kRemoteOledLineMaxLength * 2 + 1] = {};
  int consumedCharacters = 0;
  const int parsedFields = sscanf(
      line, "OLED_BIG,%lu,%40[^,],%40s%n", &durationMs, encodedPrimaryText,
      encodedSecondaryText, &consumedCharacters);
  if (parsedFields != 3 ||
      consumedCharacters != static_cast<int>(strlen(line)) ||
      durationMs < kRemoteOledMinimumDurationMs ||
      durationMs > kRemoteOledMaximumDurationMs)
  {
    return false;
  }

  char primaryText[kRemoteOledLineMaxLength + 1] = {};
  char secondaryText[kRemoteOledLineMaxLength + 1] = {};
  if (!decodeRemoteOledText(
          encodedPrimaryText, primaryText, sizeof(primaryText)) ||
      !decodeRemoteOledText(
          encodedSecondaryText, secondaryText, sizeof(secondaryText)) ||
      primaryText[0] == '\0')
  {
    return false;
  }

  remoteOledTitle[0] = '\0';
  memcpy(remoteOledFirstLine, primaryText, sizeof(remoteOledFirstLine));
  memcpy(remoteOledSecondLine, secondaryText, sizeof(remoteOledSecondLine));
  remoteOledStartedAtMs = millis();
  remoteOledExpiresAtMs = remoteOledStartedAtMs +
                          static_cast<uint32_t>(durationMs);
  remoteOledLargeLayout = true;
  remoteOledActive = true;
  return true;
}

void handleUartCommand(const char* line)
{
  if (strcmp(line, "PING") == 0)
  {
    Serial.println("PONG");
    return;
  }
  if (strcmp(line, "STOP") == 0)
  {
    stopMotorOutputs();
    endServoCalibrationMode();
    controlSource = ControlSource::Raspberry;
    lastMotorCommandMs = millis();
    return;
  }
  if (strcmp(line, "ESTOP") == 0)
  {
    emergencyStopActive = true;
    dashboardArmed = false;
    stopMotorOutputs();
    endServoCalibrationMode();
    return;
  }
  if (strcmp(line, "CLEAR_ESTOP") == 0)
  {
    stopMotorOutputs();
    emergencyStopActive = false;
    calibrationStopLatched = false;
    return;
  }
  if (strcmp(line, "RESET_ENCODERS") == 0)
  {
    resetEncoderData();
    return;
  }
  if (strcmp(line, "CALIBRATE_SENSORS") == 0)
  {
    runSensorCalibration();
    return;
  }
  if (strcmp(line, "SYSTEM_STARTING") == 0)
  {
    raspberrySystemReady = false;
    remoteOledActive = false;
    endServoCalibrationMode();
    return;
  }
  if (strcmp(line, "SYSTEM_READY") == 0)
  {
    raspberrySystemReady = true;
    lastRaspberrySystemReadyMs = millis();
    return;
  }
  if (strcmp(line, "SERVO_HOLD,1") == 0)
  {
    // A trava conserva o último PWM. O timeout da Raspberry ainda impede que
    // comandos de movimento novos sejam aceitos até o heartbeat retornar.
    servoHoldActive = true;
    Serial.println("SERVO_HOLD,ON");
    return;
  }
  if (strcmp(line, "SERVO_HOLD,0") == 0)
  {
    servoHoldActive = false;
    if (!isRaspberrySystemReady(millis()))
    {
      disableAllServoOutputs();
    }
    Serial.println("SERVO_HOLD,OFF");
    return;
  }
  if (strcmp(line, "OLED_CLEAR") == 0)
  {
    remoteOledActive = false;
    remoteOledLargeLayout = false;
    Serial.println("OLED,CLEARED");
    return;
  }
  if (strncmp(line, "OLED_BIG,", 9) == 0)
  {
    if (applyLargeRemoteOledCommand(line))
    {
      Serial.println("OLED,OK");
    }
    else
    {
      sendUartError("invalid_large_oled_message");
    }
    return;
  }
  if (strncmp(line, "OLED,", 5) == 0)
  {
    if (applyRemoteOledCommand(line))
    {
      Serial.println("OLED,OK");
    }
    else
    {
      sendUartError("invalid_oled_message");
    }
    return;
  }

  if (strcmp(line, "SERVO_CAL_BEGIN") == 0)
  {
    if (beginServoCalibrationMode())
    {
      Serial.println("SERVO_CAL,START");
    }
    else
    {
      sendUartError("servo_calibration_unavailable");
    }
    return;
  }

  if (strcmp(line, "SERVO_CAL_END") == 0)
  {
    endServoCalibrationMode();
    Serial.println("SERVO_CAL,END");
    return;
  }

  if (strcmp(line, "SERVO_CAL_DISABLE") == 0)
  {
    if (!servoCalibrationActive)
    {
      sendUartError("servo_calibration_not_active");
    }
    else
    {
      disableAllServoOutputs();
    }
    return;
  }

  if (strncmp(line, "SERVO_CAL_PULSE,", 16) == 0)
  {
    char servoName[16] = {};
    unsigned int pulseUs = 0;
    int consumedCharacters = 0;
    const int parsedFields = sscanf(
        line, "SERVO_CAL_PULSE,%15[^,],%u%n", servoName, &pulseUs,
        &consumedCharacters);
    ServoId servo = ServoId::Arm;
    if (parsedFields != 2 ||
        consumedCharacters != static_cast<int>(strlen(line)) ||
        !parseServoId(servoName, servo) ||
        pulseUs > UINT16_MAX ||
        !applyServoCalibrationPulse(servo, static_cast<uint16_t>(pulseUs)))
    {
      disableAllServoOutputs();
      sendUartError("invalid_servo_calibration_pulse");
    }
    return;
  }

  if (strncmp(line, "SERVO_CAL_SAVE,", 15) == 0)
  {
    char servoName[16] = {};
    unsigned int pulseAtZeroUs = 0;
    unsigned int pulseAt180Us = 0;
    int consumedCharacters = 0;
    const int parsedFields = sscanf(
        line, "SERVO_CAL_SAVE,%15[^,],%u,%u%n", servoName,
        &pulseAtZeroUs, &pulseAt180Us, &consumedCharacters);
    ServoId servo = ServoId::Arm;
    if (parsedFields != 3 ||
        consumedCharacters != static_cast<int>(strlen(line)) ||
        !parseServoId(servoName, servo) ||
        pulseAtZeroUs > UINT16_MAX || pulseAt180Us > UINT16_MAX ||
        !saveServoCalibration(servo,
                              static_cast<uint16_t>(pulseAtZeroUs),
                              static_cast<uint16_t>(pulseAt180Us)))
    {
      disableAllServoOutputs();
      sendUartError("servo_calibration_save_failed");
    }
    else
    {
      Serial.print("SERVO_CAL,SAVED,");
      Serial.println(servoConfig(servo).protocolName);
    }
    return;
  }

  if (strcmp(line, "SERVO_DISABLE_ALL") == 0)
  {
    disableAllServoOutputs();
    return;
  }

  if (strncmp(line, "SERVO_DISABLE,", 14) == 0)
  {
    if (servoHoldActive)
    {
      sendUartError("servo_hold_active");
      return;
    }
    char servoName[16] = {};
    int consumedCharacters = 0;
    const int parsedFields = sscanf(
        line, "SERVO_DISABLE,%15[^,]%n", servoName, &consumedCharacters);
    ServoId servo = ServoId::Arm;
    if (parsedFields != 1 ||
        consumedCharacters != static_cast<int>(strlen(line)) ||
        !parseServoId(servoName, servo))
    {
      sendUartError("invalid_servo_disable");
      return;
    }
    disableServoOutput(servo);
    return;
  }

  if (strncmp(line, "SERVO_SLEW,", 11) == 0)
  {
    char servoName[16] = {};
    float targetAngleDegrees = 0.0f;
    float maximumSpeedDegreesPerSecond = 0.0f;
    int consumedCharacters = 0;
    const int parsedFields = sscanf(
        line, "SERVO_SLEW,%15[^,],%f,%f%n", servoName,
        &targetAngleDegrees, &maximumSpeedDegreesPerSecond,
        &consumedCharacters);
    ServoId servo = ServoId::Arm;
    if (parsedFields != 3 ||
        consumedCharacters != static_cast<int>(strlen(line)) ||
        !parseServoId(servoName, servo) ||
        !beginServoSlew(
            servo, targetAngleDegrees, maximumSpeedDegreesPerSecond))
    {
      sendUartError("invalid_servo_slew");
      return;
    }
    return;
  }

  if (strncmp(line, "SERVO_POSE,", 11) == 0)
  {
    float armDegrees = 0.0f;
    float wristDegrees = 0.0f;
    float gripperDegrees = 0.0f;
    int consumedCharacters = 0;
    const int parsedFields = sscanf(
        line, "SERVO_POSE,%f,%f,%f%n", &armDegrees, &wristDegrees,
        &gripperDegrees, &consumedCharacters);
    if (parsedFields != 3 ||
        consumedCharacters != static_cast<int>(strlen(line)) ||
        !applyServoPose(armDegrees, wristDegrees, gripperDegrees))
    {
      disableAllServoOutputs();
      sendUartError("invalid_servo_pose");
      return;
    }
    return;
  }

  if (strncmp(line, "SERVO,", 6) == 0)
  {
    char servoName[16] = {};
    float angleDegrees = 0.0f;
    int consumedCharacters = 0;
    const int parsedFields = sscanf(
        line, "SERVO,%15[^,],%f%n", servoName, &angleDegrees,
        &consumedCharacters);
    ServoId servo = ServoId::Arm;
    if (parsedFields != 2 ||
        consumedCharacters != static_cast<int>(strlen(line)) ||
        !parseServoId(servoName, servo) ||
        !applyServoAngle(servo, angleDegrees))
    {
      sendUartError("invalid_servo_command");
      return;
    }
    return;
  }

  float leftPower = 0.0f;
  float rightPower = 0.0f;
  int emergencyFlag = 0;
  const int parsedFields = sscanf(line, "MOTOR,%f,%f,%d",
                                  &leftPower, &rightPower, &emergencyFlag);
  if (parsedFields == 3)
  {
    if (emergencyFlag != 0)
    {
      emergencyStopActive = true;
      dashboardArmed = false;
      stopMotorOutputs();
      endServoCalibrationMode();
      return;
    }
    if (!isfinite(leftPower) || !isfinite(rightPower) ||
        leftPower < -1.0f || leftPower > 1.0f ||
        rightPower < -1.0f || rightPower > 1.0f)
    {
      stopMotorOutputs();
      sendUartError("invalid_motor_power");
      return;
    }
    applyMotorCommand(leftPower, rightPower, ControlSource::Raspberry);
    return;
  }
  sendUartError("bad_command");
}

void readUartCommands()
{
  while (Serial.available() > 0)
  {
    const char character = static_cast<char>(Serial.read());
    if (character == '\n')
    {
      commandBuffer[commandLength] = '\0';
      if (commandLength > 0)
      {
        handleUartCommand(commandBuffer);
      }
      commandLength = 0;
    }
    else if (character != '\r')
    {
      if (commandLength < kCommandBufferSize - 1)
      {
        commandBuffer[commandLength++] = character;
      }
      else
      {
        commandLength = 0;
        sendUartError("command_too_long");
      }
    }
  }
}

void sendUartTelemetryIfDue()
{
  const uint32_t nowMs = millis();
  if (nowMs - lastTelemetryMs < kTelemetryIntervalMs)
  {
    return;
  }
  lastTelemetryMs = nowMs;

  int32_t leftCount;
  int32_t rightCount;
  portENTER_CRITICAL(&encoderMux);
  leftCount = leftEncoderCount;
  rightCount = rightEncoderCount;
  portEXIT_CRITICAL(&encoderMux);

  // Os oito primeiros campos mantêm compatibilidade com o parser atual da
  // Raspberry. Os campos adicionais levam bateria, encoders, botão e PCA9685.
  Serial.print("SENSOR,");
  Serial.print(sensors.ultrasonicValid ? sensors.ultrasonicDistanceCm : -1.0f, 2);
  Serial.print(',');
  Serial.print(sensors.gyroZ, 2);
  Serial.print(',');
  Serial.print(sensors.yawZ, 2);
  Serial.print(',');
  Serial.print(sensors.accelX, 2);
  Serial.print(',');
  Serial.print(sensors.accelY, 2);
  Serial.print(',');
  Serial.print(sensors.accelZ, 2);
  Serial.print(',');
  Serial.print(mpuReady ? 1 : 0);
  Serial.print(',');
  Serial.print(sensors.batteryVoltage, 2);
  Serial.print(',');
  Serial.print(leftCount);
  Serial.print(',');
  Serial.print(rightCount);
  Serial.print(',');
  Serial.print(startButtonPressed ? 1 : 0);
  Serial.print(',');
  Serial.print(pca9685Ready ? 1 : 0);
  Serial.print(',');
  Serial.print(currentLeftPower, 2);
  Serial.print(',');
  Serial.print(currentRightPower, 2);
  Serial.print(',');
  Serial.print(sensors.leftEncoderRate, 1);
  Serial.print(',');
  Serial.print(sensors.rightEncoderRate, 1);
  Serial.print(',');
  Serial.print(sensors.rampAngleDegrees, 2);
  Serial.print(',');
  Serial.print(sensors.gyroX, 2);
  Serial.print(',');
  Serial.print(sensors.gyroY, 2);
  Serial.print(',');
  Serial.print(sensors.imuTemperatureCelsius, 2);
  Serial.print(',');
  Serial.print(oledReady ? 1 : 0);
  Serial.print(',');
  Serial.print(gpio_get_level(static_cast<gpio_num_t>(kMotorSleepPin)) ? 1 : 0);
  Serial.print(',');
  Serial.print(emergencyStopActive ? 1 : 0);
  Serial.print(',');
  Serial.print(sensors.batteryAdcMillivolts);
  Serial.print(',');
  Serial.print(millis());
  Serial.print(',');
  Serial.print(calibrationActive ? 1 : 0);
  Serial.print(',');
  Serial.print(isRemoteOledPageActive(nowMs) ? 1 : 0);
  Serial.print(',');
  Serial.print(isRaspberrySystemReady(nowMs) ? 1 : 0);

  // Estes campos adicionais são somente diagnósticos. Eles permitem conferir
  // se o watchdog zerou a saída e qual interface enviou o último comando.
  const uint32_t motorCommandAgeMs = nowMs - lastMotorCommandMs;
  Serial.print(',');
  Serial.print(motorCommandAgeMs);
  Serial.print(',');
  Serial.print(motorCommandAgeMs > kMotorCommandTimeoutMs ? 1 : 0);
  Serial.print(',');
  Serial.print(static_cast<int>(controlSource));

  // Os ângulos são as últimas referências realmente aplicadas. O campo enabled
  // informa se o PCA9685 ainda emite o pulso de cada mecanismo.
  for (size_t index = 0; index < kServoOutputCount; ++index)
  {
    Serial.print(',');
    Serial.print(servoOutputStates[index].angleDegrees, 1);
    Serial.print(',');
    Serial.print(servoOutputStates[index].pulseUs);
    Serial.print(',');
    Serial.print(servoOutputStates[index].enabled ? 1 : 0);
  }

  Serial.print(',');
  Serial.print(servoCalibrationActive ? 1 : 0);
  Serial.print(',');
  Serial.print(servoCalibrationSelectedIndex);
  for (size_t index = 0; index < kServoOutputCount; ++index)
  {
    // A Raspberry recebe a calibração realmente carregada da NVS, não apenas
    // os valores padrão compilados. Isso permite conferir o que será usado.
    Serial.print(',');
    Serial.print(servoCalibrations[index].minimumPulseUs);
    Serial.print(',');
    Serial.print(servoCalibrations[index].maximumPulseUs);
    Serial.print(',');
    Serial.print(servoCalibrations[index].inverted ? 1 : 0);
  }

  // Estes campos opcionais mostram o alvo e o progresso de SERVO_SLEW.
  // Firmwares e parsers anteriores ignoram os campos anexados ao final.
  for (size_t index = 0; index < kServoOutputCount; ++index)
  {
    Serial.print(',');
    Serial.print(servoOutputStates[index].targetAngleDegrees, 1);
    Serial.print(',');
    Serial.print(servoOutputStates[index].slewRateDegreesPerSecond, 1);
    Serial.print(',');
    Serial.print(servoOutputStates[index].slewActive ? 1 : 0);
  }
  // Confirma à Raspberry que o firmware protege a pose contra FULL_OFF.
  Serial.print(',');
  Serial.print(servoHoldActive ? 1 : 0);
  Serial.println();
}

void enforceMotorTimeout()
{
  if (millis() - lastMotorCommandMs <= kMotorCommandTimeoutMs)
  {
    return;
  }

  stopMotorOutputs();
  if (controlSource == ControlSource::Dashboard)
  {
    // O navegador deve enviar heartbeat continuamente. Se ele desaparecer,
    // a habilitação de bancada também é removida e exige nova ação humana.
    dashboardArmed = false;
  }
}

void enforceServoSafety()
{
  if (emergencyStopActive || calibrationActive)
  {
    endServoCalibrationMode();
    return;
  }

  if (calibrationStopLatched && !servoCalibrationActive)
  {
    disableAllServoOutputs();
    return;
  }


  if (servoCalibrationActive && servoCalibrationSelectedIndex >= 0 &&
      millis() - lastServoCalibrationCommandMs >
          kServoCalibrationCommandTimeoutMs)
  {
    // A calibração continua aberta para permitir nova tentativa, mas o pulso
    // bruto expira sozinho quando a aba deixa de renová-lo.
    disableAllServoOutputs();
  }

#ifdef OBR_ESP32_RASPBERRY_MODE
  // Os servos posicionais podem manter esforço indefinidamente. Se o processo
  // principal cair, o heartbeat expirado remove os sinais em até três segundos.
  if (!isRaspberrySystemReady(millis()))
  {
    endServoCalibrationMode();
  }
#endif
}

void setup()
{
  // Os motores são a primeira parte configurada pelo setup(). Sensores, UART
  // e o modo opcional de bancada só iniciam depois que as entradas estão LOW.
  setupMotors();

  // A UART0 usa exatamente GPIO1/GPIO3, conforme a fiação com a Raspberry.
  // Mensagens de depuração não são enviadas para evitar corromper o protocolo.
  Serial.begin(kRaspberryBaudRate, SERIAL_8N1, kRaspberryRxPin, kRaspberryTxPin);

  // Carrega os limites antes de inicializar o PCA9685. Nenhum pulso é emitido
  // nesta etapa; valores ausentes ou inválidos mantêm os padrões compilados.
  loadServoCalibrations();

  pinMode(kStartButtonPin, INPUT_PULLUP);
  rawStartButtonPressed = digitalRead(kStartButtonPin) == LOW;
  startButtonPressed = rawStartButtonPressed;
  lastButtonChangeMs = millis();
  startButtonPressedSinceMs = startButtonPressed ? lastButtonChangeMs : 0;
  setupEncoders();
  setupUltrasonic();

  analogReadResolution(12);
  analogSetPinAttenuation(kBatteryAdcPin, ADC_11db);
  setupI2cDevices();

#ifndef OBR_ESP32_RASPBERRY_MODE
  WiFi.mode(WIFI_AP);
  WiFi.softAP(kWifiSsid, kWifiPassword);
  setupDashboardRoutes();
#endif

  lastMotorCommandMs = millis();
  lastEncoderRateMs = millis();
  Serial.println("READY");
}

void loop()
{
#ifndef OBR_ESP32_RASPBERRY_MODE
  server.handleClient();
#endif
  readUartCommands();
  updateStartButton();
  readImuIfDue();
  readBatteryIfDue();
  updateOledIfDue();
  updateEncoderRatesIfDue();
  triggerUltrasonicIfDue();
  consumeUltrasonicSample();
  enforceMotorTimeout();
  enforceServoSafety();
  updateServoSlewMotion();
  sendUartTelemetryIfDue();
  delay(1);
}
