ORC-Robotics/soul-robot/src/dashboard/dashboard_server.cpp

#include "obr/dashboard_server.h"

#include "obr/config.h"

#include <algorithm>
#include <chrono>
#include <cctype>
#include <cmath>
#include <cstdio>
#include <cstdint>
#include <exception>
#include <fstream>
#include <iomanip>
#include <iostream>
#include <limits>
#include <sstream>
#include <thread>

namespace
{
// O serviço inicia na raiz do projeto, onde o deploy também copia os recursos visuais.
constexpr const char* kDashboardLogoPath = "assets/dashboard-logo.png";
constexpr const char* kDashboardFaviconPath = "assets/soul-sync-favicon.png";

std::string lowerCopy(std::string text)
{
    std::transform(text.begin(), text.end(), text.begin(), [](unsigned char c) {
        return static_cast<char>(std::tolower(c));
    });
    return text;
}

bool parseServoName(const std::string& name, ServoId& servo)
{
    if (name == "arm")
    {
        servo = ServoId::Arm;
        return true;
    }
    if (name == "wrist")
    {
        servo = ServoId::Wrist;
        return true;
    }
    if (name == "gripper")
    {
        servo = ServoId::Gripper;
        return true;
    }
    return false;
}
}

DashboardServer::DashboardServer(RobotState& robotState, Telemetry& telemetry, Esp32Bridge& esp32,
                                 MotorController& motors, ServoController& servos,
                                 StatusLed& readyLed)
    : robotState_(robotState), telemetry_(telemetry), esp32_(esp32),
      motors_(motors), servos_(servos), readyLed_(readyLed)
{
}

DashboardServer::~DashboardServer()
{
    stop();
}

bool DashboardServer::start()
{
    if (!initializeSockets())
    {
        std::cerr << "Failed to initialize sockets\n";
        return false;
    }

    server_ = socket(AF_INET, SOCK_STREAM, 0);
    if (isInvalidSocket(server_))
    {
        std::cerr << "Failed to create socket\n";
        cleanupSockets();
        return false;
    }

    int opt = 1;
#ifdef _WIN32
    const char* reuseOpt = reinterpret_cast<const char*>(&opt);
#else
    const void* reuseOpt = &opt;
#endif
    setsockopt(server_, SOL_SOCKET, SO_REUSEADDR, reuseOpt, sizeof(opt));

    sockaddr_in address = {};
    address.sin_family = AF_INET;
#ifdef _WIN32
    // No Windows, o executável serve apenas como prévia local sem hardware.
    // Restringir ao loopback impede o acesso ao painel por outros computadores da rede.
    address.sin_addr.s_addr = htonl(INADDR_LOOPBACK);
#else
    address.sin_addr.s_addr = INADDR_ANY;
#endif
    address.sin_port = htons(config::kDashboardPort);

    if (bind(server_, reinterpret_cast<sockaddr*>(&address), sizeof(address)) < 0)
    {
        std::cerr << "Failed to bind port " << config::kDashboardPort << "\n";
        closeSocket(server_);
        cleanupSockets();
        return false;
    }

    if (listen(server_, 8) < 0)
    {
        std::cerr << "Failed to listen on port " << config::kDashboardPort << "\n";
        closeSocket(server_);
        cleanupSockets();
        return false;
    }

    running_ = true;
    acceptThread_ = std::thread(&DashboardServer::acceptLoop, this);
    telemetryThread_ = std::thread(&DashboardServer::telemetryLoop, this);

    return true;
}

void DashboardServer::stop()
{
    if (!running_)
    {
        return;
    }

    running_ = false;
    shutdownSocket(server_);

    {
        std::lock_guard<std::mutex> lock(clientsMutex_);
        for (SocketHandle client : clients_)
        {
            closeSocket(client);
        }
        clients_.clear();
    }

    if (acceptThread_.joinable())
    {
        acceptThread_.join();
    }

    if (telemetryThread_.joinable())
    {
        telemetryThread_.join();
    }

    cleanupSockets();
}

bool DashboardServer::initializeSockets()
{
#if defined(_WIN32) && !defined(__INTELLISENSE__)
    WSADATA data;
    return WSAStartup(MAKEWORD(2, 2), &data) == 0;
#else
    return true;
#endif
}

void DashboardServer::cleanupSockets()
{
#if defined(_WIN32) && !defined(__INTELLISENSE__)
    WSACleanup();
#endif
}

bool DashboardServer::isInvalidSocket(SocketHandle socketHandle) const
{
#ifdef _WIN32
    return socketHandle == INVALID_SOCKET;
#else
    return socketHandle < 0;
#endif
}

void DashboardServer::closeSocket(SocketHandle socketHandle)
{
#if defined(_WIN32) && defined(__INTELLISENSE__)
    (void)socketHandle;
#elif defined(_WIN32)
    closesocket(socketHandle);
#else
    close(socketHandle);
#endif
}

void DashboardServer::shutdownSocket(SocketHandle socketHandle)
{
#if defined(_WIN32) && defined(__INTELLISENSE__)
    (void)socketHandle;
#elif defined(_WIN32)
    shutdown(socketHandle, SD_BOTH);
    closesocket(socketHandle);
#else
    shutdown(socketHandle, SHUT_RDWR);
    close(socketHandle);
#endif
}

void DashboardServer::acceptLoop()
{
    while (running_)
    {
        sockaddr_in clientAddress = {};
        SocketLength clientLength = sizeof(clientAddress);
        SocketHandle client = accept(server_, reinterpret_cast<sockaddr*>(&clientAddress), &clientLength);

        if (!isInvalidSocket(client))
        {
            std::thread(&DashboardServer::handleClient, this, client).detach();
        }
    }
}

void DashboardServer::telemetryLoop()
{
    int telemetryLogCounter = 0;
    auto previousTelemetryTime = std::chrono::steady_clock::time_point{};
    double previousWorkMs = 0.0;

    while (running_)
    {
        std::this_thread::sleep_for(std::chrono::milliseconds(config::kTelemetryPeriodMs));

        const auto workStartedAt = std::chrono::steady_clock::now();
        const double effectiveIntervalMs =
            previousTelemetryTime.time_since_epoch().count() == 0
                ? 0.0
                : std::chrono::duration<double, std::milli>(
                      workStartedAt - previousTelemetryTime)
                      .count();
        previousTelemetryTime = workStartedAt;

        TelemetrySample sample = telemetry_.read();
        const long long generatedUnixMs =
            std::chrono::duration_cast<std::chrono::milliseconds>(
                std::chrono::system_clock::now().time_since_epoch())
                .count();
        std::size_t websocketClientCount = 0;
        {
            std::lock_guard<std::mutex> lock(clientsMutex_);
            websocketClientCount = clients_.size();
        }
        const std::uint64_t sequence = ++telemetrySequence_;
        // O pacote publica o custo do ciclo anterior porque só é possível
        // incluir o tempo completo depois que o broadcast daquele ciclo termina.
        std::string json = buildTelemetryJson(
            sample,
            sequence,
            generatedUnixMs,
            effectiveIntervalMs,
            previousWorkMs,
            websocketClientCount);
        broadcast(json);
        previousWorkMs = std::chrono::duration<double, std::milli>(
                             std::chrono::steady_clock::now() - workStartedAt)
                             .count();

        ++telemetryLogCounter;
        if (telemetryLogCounter >= config::kTelemetryLogEverySamples)
        {
            telemetryLogCounter = 0;
            std::cout << "Telemetry " << json << "\n";
        }
    }
}

void DashboardServer::handleClient(SocketHandle client)
{
    char buffer[4096] = {};
    SocketResult bytesRead = recv(client, buffer, sizeof(buffer) - 1, 0);
    if (bytesRead <= 0)
    {
        closeSocket(client);
        return;
    }

    std::string request(buffer, bytesRead);
    if (lowerCopy(request).find("upgrade: websocket") != std::string::npos)
    {
        handleWebSocket(client, request);
        return;
    }

    if (request.find("GET /camera.jpg") == 0)
    {
        if (!sendCameraFrame(client))
        {
            sendHttpNotFound(client);
        }
        closeSocket(client);
        return;
    }

    if (request.find("GET /camera-stream.mjpg") == 0)
    {
        if (!proxyCameraStream(client, request, config::kCameraStreamPort,
                               config::kCameraStreamPath, true))
        {
            sendHttpNotFound(client);
        }
        closeSocket(client);
        return;
    }

    if (request.find("HEAD /camera-stream.mjpg") == 0)
    {
        if (!sendCameraStreamHead(client, config::kCameraStreamPort))
        {
            sendHttpNotFound(client);
        }
        closeSocket(client);
        return;
    }

    if (request.find("GET /camera-status.json") == 0)
    {
        sendCameraStatus(client, config::kCameraStatusPath);
        closeSocket(client);
        return;
    }

    if (request.find("GET /forward-camera-stream.mjpg") == 0)
    {
        if (!proxyCameraStream(client, request, config::kForwardCameraStreamPort,
                               config::kForwardCameraStreamPath, true))
        {
            sendHttpNotFound(client);
        }
        closeSocket(client);
        return;
    }

    if (request.find("HEAD /forward-camera-stream.mjpg") == 0)
    {
        if (!sendCameraStreamHead(client, config::kForwardCameraStreamPort))
        {
            sendHttpNotFound(client);
        }
        closeSocket(client);
        return;
    }

    if (request.find("GET /forward-camera-status.json") == 0)
    {
        sendCameraStatus(client, config::kForwardCameraStatusPath);
        closeSocket(client);
        return;
    }

    if (request.find("GET /dashboard-logo.png") == 0)
    {
        if (!sendStaticFile(client, kDashboardLogoPath, "image/png"))
        {
            sendHttpNotFound(client);
        }
        closeSocket(client);
        return;
    }

    if (request.find("GET /soul-sync-favicon.png") == 0)
    {
        if (!sendStaticFile(client, kDashboardFaviconPath, "image/png"))
        {
            sendHttpNotFound(client);
        }
        closeSocket(client);
        return;
    }

    sendHttpResponse(client, dashboardHtml(), "text/html; charset=utf-8");
    closeSocket(client);
}

void DashboardServer::handleWebSocket(SocketHandle client, const std::string& request)
{
    std::string key = getHeaderValue(request, "Sec-WebSocket-Key: ");
    std::string accept = base64Encode(sha1(key + "258EAFA5-E914-47DA-95CA-C5AB0DC85B11"));

    std::ostringstream response;
    response << "HTTP/1.1 101 Switching Protocols\r\n"
             << "Upgrade: websocket\r\n"
             << "Connection: Upgrade\r\n"
             << "Sec-WebSocket-Accept: " << accept << "\r\n\r\n";

    std::string text = response.str();
    send(client, text.c_str(), static_cast<int>(text.size()), 0);
    addWebSocketClient(client);

    std::string payload;
    while (running_ && readWebSocketFrame(client, payload))
    {
        handleCommand(payload);
    }

    removeWebSocketClient(client);
    closeSocket(client);
}

void DashboardServer::addWebSocketClient(SocketHandle client)
{
    std::lock_guard<std::mutex> lock(clientsMutex_);
    clients_.push_back(client);
}

void DashboardServer::removeWebSocketClient(SocketHandle client)
{
    std::lock_guard<std::mutex> lock(clientsMutex_);
    clients_.erase(std::remove(clients_.begin(), clients_.end(), client), clients_.end());
}

void DashboardServer::broadcast(const std::string& message)
{
    std::lock_guard<std::mutex> lock(clientsMutex_);

    for (auto it = clients_.begin(); it != clients_.end();)
    {
        if (sendWebSocketText(*it, message))
        {
            ++it;
        }
        else
        {
            closeSocket(*it);
            it = clients_.erase(it);
        }
    }
}

void DashboardServer::endServoCalibrationIfActive()
{
    const RobotSnapshot state = robotState_.snapshot();
    const Esp32TelemetrySnapshot esp32 = esp32_.telemetrySnapshot();
    if (state.servoCalibrationActive || esp32.servoCalibrationActive)
    {
        // O encerramento é enviado antes da próxima troca de modo para remover
        // o pulso imediatamente. O STOP subsequente permanece como segunda trava.
        if (!servos_.endCalibration())
        {
            std::cerr << "Servo calibration end command was not sent to ESP32\n";
        }
    }
    robotState_.endServoCalibration();
}

void DashboardServer::handleCommand(const std::string& message)
{
    if (message.find("\"command\":\"estop\"") != std::string::npos)
    {
        endServoCalibrationIfActive();
        robotState_.emergencyStop();
        std::cout << "Emergency stop received\n";
    }
    else if (message.find("\"command\":\"start\"") != std::string::npos)
    {
        endServoCalibrationIfActive();
        esp32_.sendClearEmergencyStop();
        robotState_.start();
        std::cout << "Start received\n";
    }
    else if (message.find("\"command\":\"auto\"") != std::string::npos)
    {
        endServoCalibrationIfActive();
        if (robotState_.snapshot().waveBonusRequested)
        {
            std::cout << "Autonomous start ignored: wave bonus is active\n";
            return;
        }
        if (!readyLed_.isReady())
        {
            std::cout << "Autonomous start ignored: system readiness is not stable\n";
            return;
        }
        esp32_.sendClearEmergencyStop();
        robotState_.startAutonomous();
        std::cout << "Autonomous start received\n";
    }
    else if (message.find("\"command\":\"set_rescue_test_memory\"") != std::string::npos)
    {
        const double alive = getJsonNumber(message, "alive", -1.0);
        const double dead = getJsonNumber(message, "dead", -1.0);
        if (!std::isfinite(alive) || !std::isfinite(dead) ||
            alive != std::floor(alive) || dead != std::floor(dead) ||
            alive < 0.0 || alive > 2.0 || dead < 0.0 || dead > 1.0 ||
            !robotState_.setRescueTestDeliveries(
                static_cast<int>(alive), static_cast<int>(dead)))
        {
            std::cerr << "Rescue test memory ignored: robot must be stopped and counts valid\n";
            return;
        }
        std::cout << "Rescue test memory set: alive=" << alive
                  << " dead=" << dead << '\n';
    }
    else if (message.find("\"command\":\"set_autonomous_mission\"") != std::string::npos)
    {
        endServoCalibrationIfActive();
        if (message.find("\"mission\":\"main_mission\"") != std::string::npos)
        {
            robotState_.setAutonomousMission(AutonomousMission::MainMission);
            std::cout << "Autonomous mission selected: main_mission\n";
        }
        else if (message.find("\"mission\":\"turn_right_90\"") != std::string::npos)
        {
            robotState_.setAutonomousMission(AutonomousMission::TurnRight90);
            std::cout << "Autonomous mission selected: turn_right_90\n";
        }
        else if (message.find("\"mission\":\"drive_distance\"") != std::string::npos)
        {
            const double targetCm = getJsonNumber(
                message, "distanceCm", config::kDriveDistanceDefaultTargetCm);
            if (robotState_.setDriveDistanceTargetCm(targetCm))
            {
                robotState_.setAutonomousMission(AutonomousMission::DriveDistance);
                std::cout << "Autonomous mission selected: drive_distance, target="
                          << targetCm << " cm\n";
            }
            else
            {
                // Alvos inválidos não podem substituir a missão segura atual.
                std::cerr << "Invalid drive-distance target ignored\n";
            }
        }
        else if (message.find("\"mission\":\"rescue_exit\"") != std::string::npos)
        {
            robotState_.setAutonomousMission(AutonomousMission::RescueExit);
            std::cout << "Autonomous mission selected: rescue_exit\n";
        }
        else if (message.find("\"mission\":\"rescue_exit_with_reverse\"") != std::string::npos)
        {
            robotState_.setAutonomousMission(
                AutonomousMission::RescueExitWithReverse);
            std::cout << "Autonomous mission selected: rescue_exit_with_reverse\n";
        }
        else if (message.find("\"mission\":\"rescue_corner_yaw_test\"") != std::string::npos)
        {
            robotState_.setAutonomousMission(AutonomousMission::RescueCornerYawTest);
            std::cout << "Autonomous mission selected: rescue_corner_yaw_test\n";
        }
        else if (message.find("\"mission\":\"rescue_area\"") != std::string::npos)
        {
            // Selecionar a etapa não liga o detector. O gate só abre depois
            // que o modo autônomo inicia, e fecha novamente em Stop ou E-Stop.
            robotState_.setAutonomousMission(AutonomousMission::RescueArea);
            std::cout << "Autonomous mission selected: rescue_area\n";
        }
        else if (message.find("\"mission\":\"rescue_zone_detection\"") != std::string::npos)
        {
            robotState_.setAutonomousMission(
                AutonomousMission::RescueZoneDetection);
            std::cout << "Autonomous mission selected: rescue_zone_detection\n";
        }
        else if (message.find("\"mission\":\"rescue_zone_align\"") != std::string::npos)
        {
            const bool targetRed =
                message.find("\"targetColor\":\"red\"") != std::string::npos;
            const bool targetGreen =
                message.find("\"targetColor\":\"green\"") != std::string::npos;
            if (!targetRed && !targetGreen)
            {
                std::cerr << "ALIGN_ZONE target color must be green or red\n";
                return;
            }
            robotState_.setAutonomousMission(AutonomousMission::RescueZoneAlign);
            robotState_.setRescueZoneTargetColor(
                targetRed ? RescueZoneTargetColor::Red
                          : RescueZoneTargetColor::Green);
            std::cout << "Autonomous mission selected: rescue_zone_align, target="
                      << (targetRed ? "red" : "green") << '\n';
        }
        else if (message.find("\"mission\":\"rescue_zone_search\"") != std::string::npos ||
                 message.find("\"mission\":\"rescue_zone_triangle\"") != std::string::npos)
        {
            const bool targetRed =
                message.find("\"targetColor\":\"red\"") != std::string::npos;
            const bool targetGreen =
                message.find("\"targetColor\":\"green\"") != std::string::npos;
            if (!targetRed && !targetGreen)
            {
                std::cerr << "SEARCH_ZONE/TRIANGLE target color must be green or red\n";
                return;
            }
            const bool triangle =
                message.find("\"mission\":\"rescue_zone_triangle\"") != std::string::npos;
            robotState_.setAutonomousMission(
                triangle ? AutonomousMission::RescueZoneTriangle
                         : AutonomousMission::RescueZoneSearch);
            robotState_.setRescueZoneTargetColor(
                targetRed ? RescueZoneTargetColor::Red
                          : RescueZoneTargetColor::Green);
            std::cout << "Autonomous mission selected: "
                      << (triangle ? "rescue_zone_triangle" : "rescue_zone_search")
                      << ", target=" << (targetRed ? "red" : "green") << '\n';
        }
        else if (message.find("\"mission\":\"rescue_zone_approach\"") != std::string::npos)
        {
            robotState_.setAutonomousMission(
                AutonomousMission::RescueZoneApproach);
            std::cout << "Autonomous mission selected: rescue_zone_approach\n";
        }
        else if (message.find("\"mission\":\"obstacle_avoidance\"") != std::string::npos)
        {
            robotState_.setAutonomousMission(
                AutonomousMission::ObstacleAvoidance);
            std::cout << "Autonomous mission selected: obstacle_avoidance\n";
        }
        else if (message.find("\"mission\":\"servo_initialize\"") != std::string::npos)
        {
            robotState_.setAutonomousMission(AutonomousMission::ServoInitialize);
            std::cout << "Autonomous mission selected: servo_initialize\n";
        }
        else if (message.find("\"mission\":\"servo_wave\"") != std::string::npos)
        {
            robotState_.setAutonomousMission(AutonomousMission::ServoWave);
            std::cout << "Autonomous mission selected: servo_wave\n";
        }
        else if (message.find("\"mission\":\"servo_capture\"") != std::string::npos)
        {
            robotState_.setAutonomousMission(AutonomousMission::ServoCapture);
            std::cout << "Autonomous mission selected: servo_capture\n";
        }
        else if (message.find("\"mission\":\"servo_internal_storage\"") != std::string::npos)
        {
            robotState_.setAutonomousMission(
                AutonomousMission::ServoInternalStorage);
            std::cout << "Autonomous mission selected: servo_internal_storage\n";
        }
        else if (message.find("\"mission\":\"servo_deposit\"") != std::string::npos)
        {
            robotState_.setAutonomousMission(AutonomousMission::ServoDeposit);
            std::cout << "Autonomous mission selected: servo_deposit\n";
        }
        else if (message.find("\"mission\":\"servo_full_sequence\"") != std::string::npos)
        {
            robotState_.setAutonomousMission(
                AutonomousMission::ServoFullSequence);
            std::cout << "Autonomous mission selected: servo_full_sequence\n";
        }
        else if (message.find("\"mission\":\"servo_full_sequence_two\"") != std::string::npos)
        {
            robotState_.setAutonomousMission(
                AutonomousMission::ServoFullSequenceTwo);
            std::cout << "Autonomous mission selected: servo_full_sequence_two\n";
        }
        else
        {
            // Missões desconhecidas são ignoradas para nunca executar um
            // comportamento diferente daquele selecionado pelo operador.
            std::cerr << "Invalid autonomous mission ignored\n";
        }
    }
    else if (message.find("\"command\":\"servo_routine_confirm\"") != std::string::npos)
    {
        if (!robotState_.confirmServoRoutineAction())
        {
            std::cerr << "Servo routine confirmation ignored: no step is waiting\n";
        }
    }
    else if (message.find("\"command\":\"stop\"") != std::string::npos)
    {
        endServoCalibrationIfActive();
        robotState_.stop();
        motors_.stop();
        std::cout << "Stop received\n";
    }
    else if (message.find("\"command\":\"calibrate\"") != std::string::npos)
    {
        // A calibração nunca preserva um comando de movimento anterior.
        // A ESP32 também trava motores e servos até uma nova partida explícita.
        endServoCalibrationIfActive();
        robotState_.stop();
        if (!esp32_.sendCalibrateSensors())
        {
            std::cerr << "Sensor calibration command was not sent to ESP32\n";
        }
        else
        {
            std::cout << "Sensor calibration requested\n";
        }
    }
    else if (message.find("\"command\":\"oled_large_message\"") != std::string::npos)
    {
        const std::string primaryText = getJsonString(message, "primaryText", "");
        const std::string secondaryText = getJsonString(message, "secondaryText", "");
        const double requestedDurationMs = getJsonNumber(
            message, "durationMs", config::kRemoteOledMaximumDurationMs);
        const int durationMs = static_cast<int>(std::clamp(
            requestedDurationMs,
            static_cast<double>(config::kRemoteOledMinimumDurationMs),
            static_cast<double>(config::kRemoteOledMaximumDurationMs)));
        // O layout grande usa o mesmo caminho dos alertas automáticos. Assim,
        // o painel testa exatamente a fonte adaptativa e o pulso gravados na ESP32.
        if (!esp32_.sendOledLargeMessage(
                primaryText, secondaryText, durationMs))
        {
            std::cerr << "Large OLED message was not sent to ESP32\n";
        }
    }
    else if (message.find("\"command\":\"oled_message\"") != std::string::npos)
    {
        const std::string title = getJsonString(message, "title", "");
        const std::string firstLine = getJsonString(message, "firstLine", "");
        const std::string secondLine = getJsonString(message, "secondLine", "");
        const double requestedDurationMs = getJsonNumber(
            message, "durationMs", config::kRemoteOledMaximumDurationMs);
        const int durationMs = static_cast<int>(std::clamp(
            requestedDurationMs,
            static_cast<double>(config::kRemoteOledMinimumDurationMs),
            static_cast<double>(config::kRemoteOledMaximumDurationMs)));
        if (!esp32_.sendOledMessage(title, firstLine, secondLine, durationMs))
        {
            std::cerr << "OLED message was not sent to ESP32\n";
        }
    }
    else if (message.find("\"command\":\"oled_clear\"") != std::string::npos)
    {
        if (!esp32_.clearOledMessage())
        {
            std::cerr << "OLED clear command was not sent to ESP32\n";
        }
    }
    else if (message.find("\"command\":\"servo_disable_all\"") != std::string::npos)
    {
        // O botão é uma ordem explícita de manutenção. Libera primeiro a trava
        // herdada do resgate para que SERVO_DISABLE_ALL não seja ignorado.
        esp32_.sendServoHoldEnabled(false);
        robotState_.disableServos();
    }
    else if (message.find("\"command\":\"servo_calibration_begin\"") != std::string::npos)
    {
        const RobotSnapshot state = robotState_.snapshot();
        const Esp32TelemetrySnapshot esp32 = esp32_.telemetrySnapshot();
        const bool calibrationAllowed =
            (state.mode == "stopped" || state.mode == "manual") &&
            !state.emergencyStop &&
            esp32.sensorFresh && esp32.pca9685Ok &&
            esp32.raspberrySystemReady &&
            esp32.servoCalibrationSupported &&
            !esp32.emergencyStopActive && !esp32.calibrationActive &&
            !esp32.servoCalibrationActive;
        if (!calibrationAllowed)
        {
            std::cerr << "Servo calibration begin ignored: system is not in a safe state\n";
        }
        else
        {
            // A transição local ocorre primeiro para que o laço principal passe
            // a renovar somente MOTOR 0,0 antes de qualquer pulso de bancada.
            robotState_.stop();
            if (!robotState_.beginServoCalibration() ||
                !servos_.beginCalibration())
            {
                robotState_.endServoCalibration();
                motors_.stop();
                std::cerr << "Servo calibration could not be started\n";
            }
            else
            {
                std::cout << "Servo calibration started\n";
            }
        }
    }
    else if (message.find("\"command\":\"servo_calibration_end\"") != std::string::npos)
    {
        endServoCalibrationIfActive();
        robotState_.stop();
        motors_.stop();
        std::cout << "Servo calibration stopped\n";
    }
    else if (message.find("\"command\":\"servo_calibration_disable\"") != std::string::npos)
    {
        const RobotSnapshot state = robotState_.snapshot();
        if (state.servoCalibrationActive &&
            !servos_.disableCalibrationOutput())
        {
            std::cerr << "Servo calibration output could not be disabled\n";
        }
    }
    else if (message.find("\"command\":\"servo_calibration_pulse\"") != std::string::npos)
    {
        const std::string servoName = getJsonString(message, "servo", "");
        const double requestedPulseUs = getJsonNumber(
            message, "pulseUs", std::numeric_limits<double>::quiet_NaN());
        ServoId servo = ServoId::Arm;
        const bool pulseIsInteger = std::isfinite(requestedPulseUs) &&
                                    std::floor(requestedPulseUs) == requestedPulseUs;
        const bool valueFitsInt = pulseIsInteger &&
                                  requestedPulseUs >= std::numeric_limits<int>::min() &&
                                  requestedPulseUs <= std::numeric_limits<int>::max();
        const int pulseUs = valueFitsInt ? static_cast<int>(requestedPulseUs) : 0;
        const RobotSnapshot state = robotState_.snapshot();
        const Esp32TelemetrySnapshot esp32 = esp32_.telemetrySnapshot();
        const bool calibrationControlAllowed =
            state.servoCalibrationActive && !state.emergencyStop &&
            esp32.sensorFresh && esp32.pca9685Ok &&
            esp32.raspberrySystemReady && esp32.servoCalibrationActive &&
            !esp32.emergencyStopActive && !esp32.calibrationActive;
        if (!parseServoName(servoName, servo) || !valueFitsInt ||
            !ServoController::isValidCalibrationPulse(pulseUs) ||
            !calibrationControlAllowed ||
            !servos_.setCalibrationPulse(servo, pulseUs))
        {
            std::cerr << "Servo calibration pulse ignored\n";
        }
    }
    else if (message.find("\"command\":\"servo_calibration_save\"") != std::string::npos)
    {
        const std::string servoName = getJsonString(message, "servo", "");
        const double requestedZeroUs = getJsonNumber(
            message, "pulseAtZeroUs", std::numeric_limits<double>::quiet_NaN());
        const double requested180Us = getJsonNumber(
            message, "pulseAt180Us", std::numeric_limits<double>::quiet_NaN());
        ServoId servo = ServoId::Arm;
        const bool valuesAreIntegers =
            std::isfinite(requestedZeroUs) && std::isfinite(requested180Us) &&
            std::floor(requestedZeroUs) == requestedZeroUs &&
            std::floor(requested180Us) == requested180Us;
        const bool valuesFitInt =
            valuesAreIntegers &&
            requestedZeroUs >= std::numeric_limits<int>::min() &&
            requestedZeroUs <= std::numeric_limits<int>::max() &&
            requested180Us >= std::numeric_limits<int>::min() &&
            requested180Us <= std::numeric_limits<int>::max();
        const int pulseAtZeroUs = valuesFitInt ? static_cast<int>(requestedZeroUs) : 0;
        const int pulseAt180Us = valuesFitInt ? static_cast<int>(requested180Us) : 0;
        const RobotSnapshot state = robotState_.snapshot();
        const Esp32TelemetrySnapshot esp32 = esp32_.telemetrySnapshot();
        const bool calibrationControlAllowed =
            state.servoCalibrationActive && !state.emergencyStop &&
            esp32.sensorFresh && esp32.pca9685Ok &&
            esp32.raspberrySystemReady && esp32.servoCalibrationActive &&
            !esp32.emergencyStopActive && !esp32.calibrationActive;
        if (!parseServoName(servoName, servo) || !valuesFitInt ||
            !ServoController::isValidCalibrationEndpoints(
                pulseAtZeroUs, pulseAt180Us) ||
            !calibrationControlAllowed ||
            !servos_.saveCalibration(servo, pulseAtZeroUs, pulseAt180Us))
        {
            std::cerr << "Servo calibration save ignored\n";
        }
    }
    else if (message.find("\"command\":\"servo_angle\"") != std::string::npos)
    {
        const std::string servoName = getJsonString(message, "servo", "");
        const double angleDegrees = getJsonNumber(
            message, "angleDegrees", std::numeric_limits<double>::quiet_NaN());
        ServoId servo = ServoId::Arm;
        const bool knownServo = parseServoName(servoName, servo);

        const RobotSnapshot state = robotState_.snapshot();
        const Esp32TelemetrySnapshot esp32 = esp32_.telemetrySnapshot();
        const bool manualControlAllowed =
            state.mode == "manual" && !state.emergencyStop &&
            esp32.sensorFresh && esp32.pca9685Ok &&
            esp32.raspberrySystemReady && !esp32.emergencyStopActive &&
            !esp32.calibrationActive && !esp32.servoCalibrationActive &&
            !state.servoCalibrationActive;
        if (!knownServo)
        {
            std::cerr << "Servo command ignored: invalid name\n";
        }
        else if (!manualControlAllowed)
        {
            // O painel só movimenta mecanismos no modo Manual. As rotinas
            // autônomas publicam poses validadas no RobotState.
            std::cerr << "Servo command ignored: manual control is not available\n";
        }
        else if (!robotState_.setManualServoAngle(servo, angleDegrees))
        {
            std::cerr << "Servo command ignored: invalid angle or state\n";
        }
    }
    else if (message.find("\"command\":\"set_forward_camera\"") != std::string::npos)
    {
        bool enabled = false;
        if (!getJsonBool(message, "enabled", enabled))
        {
            std::cerr << "Forward camera command ignored: enabled must be boolean\n";
        }
        else if (!setForwardCameraEnabled(enabled))
        {
            std::cerr << "Forward camera state could not be written\n";
        }
        else
        {
            std::cout << "Forward camera requested: "
                      << (enabled ? "enabled" : "disabled") << "\n";
        }
    }
    else if (message.find("\"command\":\"set_line_camera\"") != std::string::npos)
    {
        bool enabled = false;
        if (!getJsonBool(message, "enabled", enabled))
        {
            std::cerr << "Line camera command ignored: enabled must be boolean\n";
        }
        else if (!setLineCameraEnabled(enabled))
        {
            std::cerr << "Line camera state could not be written\n";
        }
        else
        {
            std::cout << "Line camera requested: "
                      << (enabled ? "enabled" : "disabled") << "\n";
        }
    }
    else if (message.find("\"command\":\"drive_raw\"") != std::string::npos)
    {
        const double left = getJsonNumber(message, "left", 0.0);
        const double right = getJsonNumber(message, "right", 0.0);
        robotState_.driveRawDiagnostic(left, right);
        std::cout << "Raw diagnostic drive left=" << left << " right=" << right << "\n";
    }
    else if (message.find("\"command\":\"drive\"") != std::string::npos)
    {
        double left = getJsonNumber(message, "left", 0.0);
        double right = getJsonNumber(message, "right", 0.0);
        robotState_.drive(left, right);
        std::cout << "Drive left=" << left << " right=" << right << "\n";
    }
}

std::string DashboardServer::buildTelemetryJson(
    const TelemetrySample& sample,
    std::uint64_t sequence,
    long long generatedUnixMs,
    double effectiveIntervalMs,
    double previousWorkMs,
    std::size_t websocketClientCount) const
{
    RobotSnapshot state = robotState_.snapshot();
    Esp32TelemetrySnapshot esp32 = esp32_.telemetrySnapshot();
    MotorSynchronizationSnapshot motorSync = motors_.synchronizationSnapshot();
    const bool rescueZoneAlignAimAvailable =
        state.autonomousStatus.rescueZoneAlignState != "UNAVAILABLE" &&
        std::isfinite(state.autonomousStatus.rescueZoneAlignAimNormalized);
    const bool rescueZoneAlignHeadingAvailable = std::isfinite(
        state.autonomousStatus.rescueZoneAlignLockedHeading);
    const bool rescueZoneLockedHeadingAvailable =
        std::isfinite(state.rescueZoneLockedHeading);
    const bool rescueZoneApproachHeadingAvailable = std::isfinite(
        state.autonomousStatus.rescueZoneApproachLockedHeading);
    const bool rescueZoneApproachErrorAvailable = std::isfinite(
        state.autonomousStatus.rescueZoneApproachHeadingError);
    const bool obstacleYawBaseAvailable =
        std::isfinite(state.autonomousStatus.obstacleYawBase);
    const bool obstacleLeftClearanceAvailable =
        std::isfinite(state.autonomousStatus.obstacleLeftClearance);
    const bool obstacleRightClearanceAvailable =
        std::isfinite(state.autonomousStatus.obstacleRightClearance);

    std::ostringstream json;
    json << std::fixed << std::setprecision(2)
         << "{\"cpu\":" << sample.cpuUsage
         << ",\"temperature\":" << sample.temperature
         << ",\"ram\":" << sample.ramUsage
         << ",\"telemetrySequence\":" << sequence
         << ",\"telemetryGeneratedUnixMs\":" << generatedUnixMs
         << ",\"telemetryConfiguredPeriodMs\":" << config::kTelemetryPeriodMs
         << ",\"telemetryEffectiveIntervalMs\":" << effectiveIntervalMs
         << ",\"telemetryServerWorkMs\":" << previousWorkMs
         << ",\"websocketClientCount\":" << websocketClientCount
         << ",\"mode\":\"" << state.mode << "\""
         << ",\"autonomousMission\":\"" << autonomousMissionName(state.autonomousMission) << "\""
         << ",\"rescueZoneTargetColor\":\""
         << rescueZoneTargetColorName(state.rescueZoneTargetColor) << "\""
         << ",\"autonomousRunSequence\":" << state.autonomousRunSequence
         << ",\"rescueDeliveredAliveVictims\":" << state.rescueDeliveredAliveVictims
         << ",\"rescueDeliveredDeadVictims\":" << state.rescueDeliveredDeadVictims
         << ",\"rescueTestMemoryActive\":" << (state.rescueTestMemoryActive ? "true" : "false")
         << ",\"missionFinished\":" << (state.missionFinished ? "true" : "false")
         << ",\"redRatio\":" << state.redRatio
         << ",\"redValid\":" << (state.redValid ? "true" : "false")
         << ",\"rawMotorCommand\":" << (state.rawMotorCommand ? "true" : "false")
         << ",\"autonomousPhase\":\"" << state.autonomousStatus.phase << "\""
         << ",\"autonomousAction\":\"" << state.autonomousStatus.action << "\""
         << ",\"autonomousProgressPercent\":" << state.autonomousStatus.progressPercent
         << ",\"driveDistanceTargetCm\":" << state.driveDistanceTargetCm
         << ",\"autonomousTargetDistanceCm\":" << state.autonomousStatus.targetDistanceCm
         << ",\"autonomousLeftDistanceCm\":" << state.autonomousStatus.leftDistanceCm
         << ",\"autonomousRightDistanceCm\":" << state.autonomousStatus.rightDistanceCm
         << ",\"autonomousAverageDistanceCm\":" << state.autonomousStatus.averageDistanceCm
         << ",\"obstacleYawBase\":"
         << (obstacleYawBaseAvailable
                 ? state.autonomousStatus.obstacleYawBase
                 : 0.0)
         << ",\"obstacleYawBaseAvailable\":"
         << (obstacleYawBaseAvailable ? "true" : "false")
         << ",\"obstacleLeftClearance\":"
         << (obstacleLeftClearanceAvailable
                 ? state.autonomousStatus.obstacleLeftClearance
                 : 0.0)
         << ",\"obstacleLeftClearanceAvailable\":"
         << (obstacleLeftClearanceAvailable ? "true" : "false")
         << ",\"obstacleRightClearance\":"
         << (obstacleRightClearanceAvailable
                 ? state.autonomousStatus.obstacleRightClearance
                 : 0.0)
         << ",\"obstacleRightClearanceAvailable\":"
         << (obstacleRightClearanceAvailable ? "true" : "false")
         << ",\"obstacleSelectedSide\":\""
         << state.autonomousStatus.obstacleSelectedSide << "\""
         << ",\"obstacleWaitSecondsRemaining\":"
         << state.autonomousStatus.obstacleWaitSecondsRemaining
         << ",\"cameraBlackLeft\":"
         << (state.autonomousStatus.cameraBlackLeft ? "true" : "false")
         << ",\"cameraBlackRight\":"
         << (state.autonomousStatus.cameraBlackRight ? "true" : "false")
         << ",\"cameraBlackLeftFrames\":"
         << state.autonomousStatus.cameraBlackLeftFrames
         << ",\"cameraBlackRightFrames\":"
         << state.autonomousStatus.cameraBlackRightFrames
         << ",\"selectedSideSource\":\""
         << state.autonomousStatus.selectedSideSource << "\""
         << ",\"rawBestParabolaSide\":\""
         << state.autonomousStatus.rawBestParabolaSide << "\""
         << ",\"bestParabolaSide\":\""
         << state.autonomousStatus.bestParabolaSide << "\""
         << ",\"bestParabolaScore\":"
         << state.autonomousStatus.bestParabolaScore
         << ",\"bestParabolaLeftBlack\":"
         << state.autonomousStatus.bestParabolaLeftBlack
         << ",\"bestParabolaRightBlack\":"
         << state.autonomousStatus.bestParabolaRightBlack
         << ",\"bestParabolaSequence\":"
         << state.autonomousStatus.bestParabolaSequence
         << ",\"bestParabolaSideValid\":"
         << (state.autonomousStatus.bestParabolaSideValid ? "true" : "false")
         << ",\"nearForwardLineVisible\":"
         << (state.autonomousStatus.nearForwardLineVisible ? "true" : "false")
         << ",\"nearForwardLineVotes\":"
         << state.autonomousStatus.nearForwardLineVotes
         << ",\"nearForwardLineSamples\":"
         << state.autonomousStatus.nearForwardLineSamples
         << ",\"case3Armed\":"
         << (state.autonomousStatus.case3Armed ? "true" : "false")
         << ",\"case3FusionAcquireTime\":"
         << state.autonomousStatus.case3FusionAcquireTime
         << ",\"case3TimeRemainingMs\":"
         << state.autonomousStatus.case3TimeRemainingMs
         << ",\"servoRoutineWaitingForConfirmation\":"
         << (state.autonomousStatus.servoRoutineWaitingForConfirmation ? "true" : "false")
         << ",\"servoRoutineInternalObjectStored\":"
         << (state.servoRoutineInternalObjectStored ? "true" : "false")
         << ",\"waveBonusRequested\":" << (state.waveBonusRequested ? "true" : "false")
         << ",\"forwardAssistState\":\"" << state.autonomousStatus.forwardAssistState << "\""
         << ",\"forwardAssistDirection\":\"" << state.autonomousStatus.forwardAssistDirection << "\""
         << ",\"forwardAssistLatchedDirection\":\"" << state.autonomousStatus.forwardAssistLatchedDirection << "\""
         << ",\"forwardAssistEntryBlocker\":\"" << state.autonomousStatus.forwardAssistEntryBlocker << "\""
         << ",\"forwardAssistYawDeltaDeg\":" << state.autonomousStatus.forwardAssistYawDeltaDeg
         << ",\"forwardAssistFarTrusted\":" << (state.autonomousStatus.forwardAssistFarTrusted ? "true" : "false")
         << ",\"forwardAssistMediumTrusted\":" << (state.autonomousStatus.forwardAssistMediumTrusted ? "true" : "false")
         << ",\"forwardAssistGapCandidate\":" << (state.autonomousStatus.forwardAssistGapCandidate ? "true" : "false")
         << ",\"forwardAssistEntryAllowed\":" << (state.autonomousStatus.forwardAssistEntryAllowed ? "true" : "false")
         << ",\"forwardAssistYawLimitDeg\":" << config::kForwardAssistMaximumSearchDegrees
         << ",\"bottomStableRequiredFrames\":" << config::kForwardAssistBottomStableFrames
         << ",\"forwardLineVisible\":" << (state.autonomousStatus.forwardLineVisible ? "true" : "false")
         << ",\"forwardPathConfidence\":" << state.autonomousStatus.forwardPathConfidence
         << ",\"forwardPathState\":\"" << state.autonomousStatus.forwardPathState << "\""
         << ",\"gapValidationDecision\":\"" << state.autonomousStatus.gapValidationDecision << "\""
         << ",\"nearLineState\":\"" << state.autonomousStatus.nearLineState << "\""
         << ",\"lineControlSource\":" << std::quoted(state.autonomousStatus.bottomLineControlSource)
         << ",\"forwardLinePosition\":" << state.autonomousStatus.forwardLinePosition
         << ",\"bottomStableFrames\":" << state.autonomousStatus.bottomStableFrames
         << ",\"rescueZoneUltrasonicFresh\":"
         << (state.autonomousStatus.rescueZoneUltrasonicFresh ? "true" : "false")
         << ",\"rescueZoneUltrasonicValid\":"
         << (state.autonomousStatus.rescueZoneUltrasonicValid ? "true" : "false")
         << ",\"rescueZoneUltrasonicDistanceCm\":"
         << state.autonomousStatus.rescueZoneUltrasonicDistanceCm
         << ",\"rescueZoneAlignAimNormalized\":"
         << (rescueZoneAlignAimAvailable
                 ? std::to_string(
                       state.autonomousStatus.rescueZoneAlignAimNormalized)
                 : "null")
         << ",\"rescueZoneAlignState\":"
         << std::quoted(state.autonomousStatus.rescueZoneAlignState)
         << ",\"rescueZoneAlignLockedHeading\":"
         << (rescueZoneAlignHeadingAvailable
                 ? std::to_string(
                       state.autonomousStatus.rescueZoneAlignLockedHeading)
                 : "null")
         << ",\"rescueZoneAlignCompletionReason\":"
         << std::quoted(state.autonomousStatus.rescueZoneAlignCompletionReason)
         << ",\"rescueZoneLockedHeading\":"
         << (rescueZoneLockedHeadingAvailable
                 ? std::to_string(state.rescueZoneLockedHeading)
                 : "null")
         << ",\"rescueZoneApproachLockedHeading\":"
         << (rescueZoneApproachHeadingAvailable
                 ? std::to_string(
                       state.autonomousStatus.rescueZoneApproachLockedHeading)
                 : "null")
         << ",\"rescueZoneApproachHeadingError\":"
         << (rescueZoneApproachErrorAvailable
                 ? std::to_string(
                       state.autonomousStatus.rescueZoneApproachHeadingError)
                 : "null")
         << ",\"rescueZoneApproachNearLatched\":"
         << (state.autonomousStatus.rescueZoneApproachNearLatched
                 ? "true" : "false")
         << ",\"rescueZoneApproachSpeedState\":"
         << std::quoted(
                state.autonomousStatus.rescueZoneApproachSpeedState)
         << ",\"rescueZoneApproachCompletionReason\":"
         << std::quoted(
                state.autonomousStatus.rescueZoneApproachCompletionReason)
         << ",\"rescueZoneSearchTargetColor\":"
         << std::quoted(state.autonomousStatus.rescueZoneSearchTargetColor)
         << ",\"rescueZoneSearchTargetDetected\":"
         << (state.autonomousStatus.rescueZoneSearchTargetDetected
                 ? "true" : "false")
         << ",\"rescueZoneSearchState\":"
         << std::quoted(state.autonomousStatus.rescueZoneSearchState)
         << ",\"rescueZoneSearchCompletionReason\":"
         << std::quoted(
                state.autonomousStatus.rescueZoneSearchCompletionReason)
         << ",\"rescueZoneTrianglePhase\":"
         << std::quoted(state.autonomousStatus.rescueZoneTrianglePhase)
         << ",\"exitSector\":" << state.autonomousStatus.exitSector
         << ",\"exitConfidence\":" << state.autonomousStatus.exitConfidence
         << ",\"exitHeadingDegrees\":" << state.autonomousStatus.exitHeadingDegrees
         << ",\"exitRound\":" << state.autonomousStatus.exitRound
         << ",\"exitAdvanceCm\":" << state.autonomousStatus.exitAdvanceCm
         << ",\"exitReverseCm\":" << state.autonomousStatus.exitReverseCm
         << ",\"exitExplorationHeadingDegrees\":"
         << state.autonomousStatus.exitExplorationHeadingDegrees
         << ",\"exitExplorationAttempt\":"
         << state.autonomousStatus.exitExplorationAttempt
         << ",\"exitExplorationAdvanceCm\":"
         << state.autonomousStatus.exitExplorationAdvanceCm
         << ",\"exitExplorationBlockReason\":"
         << std::quoted(state.autonomousStatus.exitExplorationBlockReason)
         << ",\"exitRejections\":" << std::quoted(state.autonomousStatus.exitRejections)
         << ",\"exitLastFailure\":" << std::quoted(state.autonomousStatus.exitLastFailure)
          << ",\"left\":" << state.left
          << ",\"right\":" << state.right
         << ",\"requestedLeft\":" << state.left
         << ",\"requestedRight\":" << state.right
         << ",\"emergency\":" << (state.emergencyStop ? "true" : "false")
         << ",\"esp32SerialOpen\":" << (esp32.serialOpen ? "true" : "false")
         << ",\"esp32SensorFresh\":" << (esp32.sensorFresh ? "true" : "false")
         << ",\"systemReady\":" << (readyLed_.isReady() ? "true" : "false")
         << ",\"esp32LastSensorAgeMs\":" << esp32.lastSensorAgeMs
         << ",\"mpuOk\":" << (esp32.mpuOk ? "true" : "false")
         << ",\"ultrasonicDistanceCm\":" << esp32.ultrasonicDistanceCm
         << ",\"gyroZDegPerSec\":" << esp32.gyroZDegPerSec
         << ",\"yawZDeg\":" << esp32.yawZDeg
         << ",\"accelX\":" << esp32.accelX
         << ",\"accelY\":" << esp32.accelY
         << ",\"accelZ\":" << esp32.accelZ
         << ",\"gyroXDegPerSec\":" << esp32.gyroXDegPerSec
         << ",\"gyroYDegPerSec\":" << esp32.gyroYDegPerSec
         << ",\"rampAngleDeg\":" << esp32.rampAngleDeg
         << ",\"imuTemperatureCelsius\":" << esp32.imuTemperatureCelsius
         << ",\"batteryVoltage\":" << esp32.batteryVoltage
         << ",\"batteryAdcMillivolts\":" << esp32.batteryAdcMillivolts
         << ",\"leftEncoderCount\":" << esp32.leftEncoderCount
         << ",\"rightEncoderCount\":" << esp32.rightEncoderCount
         << ",\"leftEncoderRate\":" << esp32.leftEncoderRate
         << ",\"rightEncoderRate\":" << esp32.rightEncoderRate
         << ",\"esp32AppliedLeftPower\":" << esp32.appliedLeftPower
         << ",\"esp32AppliedRightPower\":" << esp32.appliedRightPower
         << ",\"commandedLeft\":" << motorSync.correctedLeftPower
         << ",\"commandedRight\":" << motorSync.correctedRightPower
         << ",\"appliedLeft\":" << esp32.appliedLeftPower
         << ",\"appliedRight\":" << esp32.appliedRightPower
         << ",\"leftMotorStarting\":"
         << (motorSync.leftMotorStarting ? "true" : "false")
         << ",\"rightMotorStarting\":"
         << (motorSync.rightMotorStarting ? "true" : "false")
         << ",\"leftMotorRunning\":"
         << (motorSync.leftMotorRunning ? "true" : "false")
         << ",\"rightMotorRunning\":"
         << (motorSync.rightMotorRunning ? "true" : "false")
         << ",\"leftMotorConfirmationSamples\":"
         << motorSync.leftMotorConfirmationSamples
         << ",\"rightMotorConfirmationSamples\":"
         << motorSync.rightMotorConfirmationSamples
         << ",\"motorSyncEligible\":" << (motorSync.eligible ? "true" : "false")
         << ",\"motorSyncActive\":" << (motorSync.active ? "true" : "false")
         << ",\"motorSyncEncoderDataValid\":"
         << (motorSync.encoderDataValid ? "true" : "false")
         << ",\"motorSyncCorrectionApplied\":"
         << (motorSync.correctionApplied ? "true" : "false")
         << ",\"motorSyncDirection\":" << motorSync.direction
         << ",\"motorSyncValidSamples\":" << motorSync.validSamples
         << ",\"motorSyncLeftScale\":" << motorSync.leftScale
         << ",\"motorSyncRightScale\":" << motorSync.rightScale
         << ",\"motorSyncLeftEfficiency\":" << motorSync.filteredLeftEfficiency
         << ",\"motorSyncRightEfficiency\":" << motorSync.filteredRightEfficiency
         << ",\"motorSyncCorrectedLeftPower\":" << motorSync.correctedLeftPower
         << ",\"motorSyncCorrectedRightPower\":" << motorSync.correctedRightPower
         << ",\"startButtonPressed\":" << (esp32.startButtonPressed ? "true" : "false")
         << ",\"pca9685Ok\":" << (esp32.pca9685Ok ? "true" : "false")
         << ",\"armServoAngleDegrees\":" << esp32.armServoAngleDegrees
         << ",\"armServoPulseUs\":" << esp32.armServoPulseUs
         << ",\"armServoEnabled\":" << (esp32.armServoEnabled ? "true" : "false")
         << ",\"wristServoAngleDegrees\":" << esp32.wristServoAngleDegrees
         << ",\"wristServoPulseUs\":" << esp32.wristServoPulseUs
         << ",\"wristServoEnabled\":" << (esp32.wristServoEnabled ? "true" : "false")
         << ",\"gripperServoAngleDegrees\":" << esp32.gripperServoAngleDegrees
         << ",\"gripperServoPulseUs\":" << esp32.gripperServoPulseUs
         << ",\"gripperServoEnabled\":" << (esp32.gripperServoEnabled ? "true" : "false")
         << ",\"armServoTargetAngleDegrees\":" << esp32.armServoTargetAngleDegrees
         << ",\"armServoSlewRateDegreesPerSecond\":"
         << esp32.armServoSlewRateDegreesPerSecond
         << ",\"armServoSlewActive\":" << (esp32.armServoSlewActive ? "true" : "false")
         << ",\"wristServoTargetAngleDegrees\":" << esp32.wristServoTargetAngleDegrees
         << ",\"wristServoSlewRateDegreesPerSecond\":"
         << esp32.wristServoSlewRateDegreesPerSecond
         << ",\"wristServoSlewActive\":" << (esp32.wristServoSlewActive ? "true" : "false")
         << ",\"gripperServoTargetAngleDegrees\":" << esp32.gripperServoTargetAngleDegrees
         << ",\"gripperServoSlewRateDegreesPerSecond\":"
         << esp32.gripperServoSlewRateDegreesPerSecond
         << ",\"gripperServoSlewActive\":" << (esp32.gripperServoSlewActive ? "true" : "false")
         << ",\"servoExtendedControlSupported\":"
         << (esp32.servoExtendedControlSupported ? "true" : "false")
         << ",\"servoHoldSupported\":"
         << (esp32.servoHoldSupported ? "true" : "false")
         << ",\"servoHoldActive\":"
         << (esp32.servoHoldActive ? "true" : "false")
         << ",\"servoCalibrationRequested\":"
         << (state.servoCalibrationActive ? "true" : "false")
         << ",\"servoCalibrationSupported\":"
         << (esp32.servoCalibrationSupported ? "true" : "false")
         << ",\"servoCalibrationActive\":"
         << (esp32.servoCalibrationActive ? "true" : "false")
         << ",\"servoCalibrationSelectedIndex\":"
         << esp32.servoCalibrationSelectedIndex
         << ",\"armServoMinimumPulseUs\":" << esp32.armServoMinimumPulseUs
         << ",\"armServoMaximumPulseUs\":" << esp32.armServoMaximumPulseUs
         << ",\"armServoInverted\":" << (esp32.armServoInverted ? "true" : "false")
         << ",\"wristServoMinimumPulseUs\":" << esp32.wristServoMinimumPulseUs
         << ",\"wristServoMaximumPulseUs\":" << esp32.wristServoMaximumPulseUs
         << ",\"wristServoInverted\":" << (esp32.wristServoInverted ? "true" : "false")
         << ",\"gripperServoMinimumPulseUs\":" << esp32.gripperServoMinimumPulseUs
         << ",\"gripperServoMaximumPulseUs\":" << esp32.gripperServoMaximumPulseUs
         << ",\"gripperServoInverted\":" << (esp32.gripperServoInverted ? "true" : "false")
         << ",\"servoCalibrationAbsoluteMinimumPulseUs\":"
         << config::kServoCalibrationAbsoluteMinimumPulseUs
         << ",\"servoCalibrationAbsoluteMaximumPulseUs\":"
         << config::kServoCalibrationAbsoluteMaximumPulseUs
         << ",\"servoCalibrationMinimumSpanUs\":"
         << config::kServoCalibrationMinimumSpanUs
         << ",\"oledOk\":" << (esp32.oledOk ? "true" : "false")
         << ",\"esp32RemoteOledActive\":" << (esp32.remoteOledActive ? "true" : "false")
         << ",\"esp32RaspberrySystemReady\":" << (esp32.raspberrySystemReady ? "true" : "false")
         << ",\"oledNavigationAlertDurationMs\":"
         << config::kOledNavigationAlertDurationMs
         << ",\"motorSleepPinHigh\":" << (esp32.motorSleepPinHigh ? "true" : "false")
         << ",\"esp32EmergencyStop\":" << (esp32.emergencyStopActive ? "true" : "false")
         << ",\"esp32CalibrationActive\":" << (esp32.calibrationActive ? "true" : "false")
         << ",\"esp32CalibrationStatusKnown\":" << (esp32.calibrationStatusKnown ? "true" : "false")
         << ",\"esp32LastCalibrationSucceeded\":" << (esp32.lastCalibrationSucceeded ? "true" : "false")
         << ",\"esp32UptimeMs\":" << esp32.esp32UptimeMs
         << ",\"raspberryCommandTimeoutMs\":" << config::kCommandTimeoutMs
         << ",\"esp32MotorCommandTimeoutMs\":" << config::kEsp32MotorCommandTimeoutMs
         << ",\"motorStartMinimumPower\":" << config::kMotorStartMinimumPower
         << ",\"motorRunMinimumPower\":" << config::kMotorRunMinimumPower
         << ",\"motorRunConfirmationRequiredSamples\":"
         << config::kMotorRunConfirmationSamples
         << ",\"operationalMaximumReferencePower\":" << config::kOperationalMaximumReferencePower
         << ",\"encoderSyncWarmupSamples\":" << config::kEncoderSyncWarmupSamples
         << ",\"encoderCountsPerCentimeter\":" << config::kEncoderCountsPerCentimeter
         << "}";

    return json.str();
}

std::string DashboardServer::dashboardHtml()
{
  return R"HTML(<!doctype html>
<html lang="pt-BR">
<head>
  <meta charset="utf-8">
  <meta name="viewport" content="width=device-width, initial-scale=1">
  <meta name="theme-color" content="#000000">
  <link rel="icon" type="image/png" sizes="128x128" href="/soul-sync-favicon.png?v=1">
  <title>Soul Sync · OBR 2026</title>
  <style>
    :root {
      color-scheme: dark;
      font-family: Inter, ui-sans-serif, system-ui, -apple-system, BlinkMacSystemFont, "Segoe UI", sans-serif;
      --bg-page: #000000;
      --bg-primary: #0d0d0d;
      --bg-card: #151515;
      --bg-card-hover: #1c1c1c;
      --bg-control: #1f1f1f;
      --bg-overlay: #0d0d0de8;
      --border-primary: #2a2a2a;
      --border-subtle: #202020;
      --text-primary: #f2f2f2;
      --text-secondary: #b4b4b4;
      --text-muted: #777777;
      --text-technical: #8a8a8a;
      --text-disabled: #555555;
      --interactive-hover: #262626;
      --interactive-active: #303030;
      --focus-ring: #666666;
      --semantic-success: #22c55e;
      --semantic-warning: #eab308;
      --semantic-danger: #ef4444;
      --semantic-danger-hover: #c93636;
      --text-on-warning: #111827;
      --dashboard-scale: .8;
      --chart-primary: #f2f2f2;
      --chart-secondary: #b4b4b4;
      --chart-tertiary: #777777;
      --space-1: 4px;
      --space-2: 8px;
      --space-3: 12px;
      --space-4: 16px;
      --space-5: 20px;
      --space-6: 24px;
      --space-7: 32px;
      --page-max-width: 1420px;
      --page-inline-space: 18px;
      --page-block-space: var(--space-6);
      --layout-gap: var(--space-3);
      --card-padding: var(--space-4);
      --control-height: 44px;
      --button-height: 48px;
      --accordion-height: 40px;
      --bg: var(--bg-page);
      --surface: var(--bg-primary);
      --surface-2: var(--bg-card);
      --line: var(--border-primary);
      --line-soft: var(--border-subtle);
      --text: var(--text-primary);
      --muted: var(--text-technical);
      --yellow: var(--semantic-warning);
      --green: var(--semantic-success);
      --danger: var(--semantic-danger);
    }
    * { box-sizing: border-box; }
    body { margin: 0; min-height: 100vh; color: var(--text); background: var(--bg-page); zoom: var(--dashboard-scale); }
    button, input { font: inherit; }
    .shell { width: min(var(--page-max-width), calc(100% - var(--page-inline-space) - var(--page-inline-space))); margin: 0 auto; padding: var(--page-block-space) 0; display: grid; gap: var(--space-4); }
    .topbar { display: flex; align-items: center; justify-content: space-between; gap: var(--space-5); margin: 0; }
    .brand { display: flex; align-items: center; gap: var(--space-3); }
    .brand-mark { width: 52px; height: 52px; flex: 0 0 52px; }
    .brand-mark img { display: block; width: 100%; height: 100%; object-fit: contain; }
    .eyebrow { display: block; margin-bottom: var(--space-1); color: var(--text-secondary); font-size: .72rem; font-weight: 850; letter-spacing: .18em; text-transform: uppercase; }
    h1 { margin: 0; font-size: clamp(1.5rem, 3vw, 2.35rem); line-height: 1; letter-spacing: -.045em; }
    .status-cluster { display: flex; flex-wrap: wrap; justify-content: flex-end; gap: var(--space-2); }
    .status-pill { min-height: 37px; display: inline-flex; align-items: center; gap: var(--space-2); padding: var(--space-2) var(--space-3); border: 1px solid var(--line); border-radius: 999px; background: var(--bg-primary); color: var(--muted); font-size: .8rem; font-weight: 800; }
    .status-pill::before { content: ""; width: 7px; height: 7px; border-radius: 50%; background: var(--text-disabled); }
    .status-pill.ok { color: var(--green); border-color: var(--green); background: var(--bg-primary); }
    .status-pill.ok::before { background: var(--green); }
    .status-pill.warn { color: var(--yellow); border-color: var(--yellow); background: var(--bg-primary); }
    .status-pill.warn::before { background: var(--yellow); }
    .status-pill.danger { color: var(--danger); border-color: var(--danger); background: var(--bg-primary); }
    .status-pill.danger::before { background: var(--danger); }
    .mode-navigation { display: grid; grid-template-columns: repeat(3, minmax(0, 1fr)); gap: var(--space-1); margin: 0; padding: var(--space-1); border: 1px solid var(--line); border-radius: 14px; background: var(--bg-primary); box-shadow: none; }
    .mode-tab { min-height: var(--control-height); padding: var(--space-2) var(--space-4); border-color: transparent; background: transparent; color: var(--muted); font-size: .73rem; letter-spacing: .12em; text-transform: uppercase; }
    .mode-tab:hover { background: var(--bg-card-hover); }
    .mode-tab.active { color: var(--bg-primary); border-color: var(--text-primary); background: var(--text-primary); box-shadow: none; }
    .mode-tab:focus-visible { outline: 2px solid var(--focus-ring); outline-offset: 2px; }
    .dashboard-mode[hidden] { display: none; }
    .dashboard-mode { min-width: 0; display: grid; gap: var(--layout-gap); }
    .mode-heading { display: flex; align-items: end; justify-content: space-between; gap: var(--space-5); margin: 0; }
    .mode-heading h2 { margin: 0; font-size: 1.25rem; }
    .mode-heading p { max-width: 620px; margin: 0; color: var(--muted); font-size: .78rem; line-height: 1.45; text-align: right; }
    .hero-grid { display: grid; grid-template-columns: minmax(0, 1.05fr) minmax(0, 1.45fr) minmax(0, 1.15fr) minmax(0, 1.35fr); gap: var(--layout-gap); margin: 0; }
    .hero-grid > *, .main-grid > *, .telemetry-grid > *, .operation-cockpit > *, .diagnostic-tools > * { min-width: 0; }
    .card { position: relative; min-width: 0; border: 1px solid var(--line); border-radius: 16px; background: var(--bg-card); box-shadow: none; overflow: hidden; }
    .hero-card { min-height: 140px; padding: var(--card-padding); }
    .hero-card::after { display: none; }
    .card-label { margin: 0 0 var(--space-2); color: var(--muted); font-size: .72rem; font-weight: 850; letter-spacing: .13em; text-transform: uppercase; }
    .hero-value { margin: 0; font-size: clamp(1.8rem, 3.3vw, 2.9rem); line-height: 1; font-weight: 900; letter-spacing: -.05em; }
    .hero-value.yellow { color: var(--yellow); }
    .hero-value.status-good { color: var(--green); text-shadow: none; }
    .hero-value.status-warn { color: var(--yellow); text-shadow: none; }
    .hero-value.status-bad { color: var(--danger); text-shadow: none; }
    .hero-detail { margin: var(--space-2) 0 0; color: var(--muted); font-size: .82rem; }
    .battery-track { height: 8px; margin-top: var(--space-3); padding: 2px; border: 1px solid var(--border-primary); border-radius: 99px; background: var(--bg-control); }
    .battery-fill { width: 0; height: 100%; border-radius: inherit; background: var(--text-secondary); box-shadow: none; transition: width .25s ease; }
    .raspberry-card { display: flex; flex-direction: column; }
    .system-metrics { display: grid; grid-template-columns: repeat(3, minmax(0, 1fr)); gap: var(--space-2); }
    .system-metric { --metric: var(--text-secondary); --metric-surface: var(--bg-card); --metric-border: var(--border-primary); --metric-label: var(--text-muted); position: relative; min-width: 0; padding: var(--space-2); border: 1px solid var(--metric-border); border-radius: 11px; background: var(--metric-surface); box-shadow: none; overflow: hidden; transition: border-color .2s, background .2s; }
    .system-metric::after { display: none; }
    .system-metric.cpu, .system-metric.ram, .system-metric.temperature { --metric: var(--text-secondary); --metric-surface: var(--bg-card); --metric-border: var(--border-primary); --metric-label: var(--text-muted); }
    .system-metric[data-level="warn"] { --metric: var(--yellow); --metric-border: var(--yellow); --metric-label: var(--yellow); }
    .system-metric[data-level="danger"] { --metric: var(--danger); --metric-border: var(--danger); --metric-label: var(--danger); box-shadow: none; }
    .metric-header { position: relative; z-index: 1; display: flex; align-items: center; justify-content: space-between; gap: var(--space-1); color: var(--metric-label); font-size: .61rem; font-weight: 850; letter-spacing: .1em; text-transform: uppercase; }
    .metric-dot { width: 6px; height: 6px; flex: 0 0 auto; border-radius: 50%; background: var(--metric); box-shadow: none; }
    .system-metric strong { position: relative; z-index: 1; display: block; margin-top: var(--space-1); color: var(--text); font-size: clamp(1.05rem, 1.6vw, 1.4rem); line-height: 1; letter-spacing: -.035em; white-space: nowrap; font-variant-numeric: tabular-nums; }
    .metric-track { position: relative; z-index: 1; height: 4px; margin-top: var(--space-2); border-radius: 99px; background: var(--bg-control); overflow: hidden; }
    .metric-fill { width: 0; height: 100%; border-radius: inherit; background: var(--metric); box-shadow: none; transition: width .3s ease, background .2s; }
    .raspberry-role { display: flex; align-items: center; gap: var(--space-2); margin: var(--space-2) 0 0; color: var(--muted); font-size: .68rem; }
    .raspberry-role::before { content: ""; width: 5px; height: 5px; flex: 0 0 auto; border-radius: 50%; background: var(--text-muted); box-shadow: none; }
    .main-grid { display: grid; grid-template-columns: minmax(0, 1.65fr) minmax(360px, .85fr); gap: var(--layout-gap); margin: 0; align-items: start; }
    .side-stack { display: grid; gap: var(--layout-gap); min-width: 0; }
    .section-card { padding: var(--card-padding); }
    .section-header { display: flex; align-items: center; justify-content: space-between; gap: var(--space-3); margin: 0 0 var(--space-3); }
    .section-title { display: flex; align-items: center; gap: var(--space-2); margin: 0; font-size: .86rem; letter-spacing: .1em; text-transform: uppercase; }
    .section-title::before { content: ""; width: 3px; height: 16px; border-radius: 4px; background: var(--text-secondary); box-shadow: none; }
    .camera-workspace-header { align-items: flex-start; }
    .camera-heading { min-width: 150px; }
    .camera-heading p { margin: var(--space-2) 0 0 var(--space-3); color: var(--muted); font-size: .68rem; line-height: 1.35; }
    .camera-meta { display: flex; flex-wrap: wrap; justify-content: flex-end; gap: var(--space-2); }
    .meta-chip { padding: var(--space-1) var(--space-2); border: 1px solid var(--line); border-radius: 7px; background: var(--bg-primary); color: var(--muted); font-size: .7rem; }
    .meta-chip strong { color: var(--text); font-variant-numeric: tabular-nums; }
    .camera-view-selector { display: grid; grid-template-columns: repeat(3, minmax(0, 1fr)); gap: var(--space-1); margin: 0 0 var(--space-2); padding: var(--space-1); border: 1px solid var(--line); border-radius: 11px; background: var(--bg-primary); }
    .camera-view-button { min-height: 38px; padding: 6px 10px; border-color: transparent; border-radius: 8px; background: transparent; color: var(--muted); font-size: .68rem; letter-spacing: .09em; text-transform: uppercase; }
    .camera-view-button:hover { background: var(--bg-card-hover); }
    .camera-view-button.active { color: var(--text-primary); border-color: var(--border-primary); background: var(--interactive-active); box-shadow: none; }
    .camera-view-button:focus-visible { outline: 2px solid var(--focus-ring); outline-offset: 2px; }
    .dataset-capture-strip { display: flex; align-items: baseline; flex-wrap: wrap; gap: var(--space-1) var(--space-2); min-height: 30px; margin: 0 0 var(--space-2); padding: 6px var(--space-2); border: 1px solid var(--line-soft); border-radius: 8px; background: var(--bg-primary); color: var(--muted); }
    .dataset-capture-strip strong { color: var(--text-muted); font-size: .59rem; font-weight: 900; letter-spacing: .08em; text-transform: uppercase; }
    .dataset-capture-strip span { min-width: 0; font-size: .62rem; font-variant-numeric: tabular-nums; overflow-wrap: anywhere; }
    .dataset-capture-strip[data-state="active"] strong { color: var(--green); }
    .dataset-capture-strip[data-state="stale"] strong { color: var(--yellow); }
    .camera-feed-grid { display: grid; grid-template-columns: minmax(0, 1fr); gap: var(--space-2); }
    .camera-feed-grid[data-view="dual"] { grid-template-columns: minmax(0, 1fr); grid-template-rows: repeat(2, minmax(0, 1fr)); }
    .camera-feed-card { min-width: 0; padding: var(--space-2); border: 1px solid var(--line-soft); border-radius: 13px; background: var(--bg-primary); }
    .camera-feed-header { display: flex; align-items: center; justify-content: space-between; gap: var(--space-2); min-height: var(--space-7); padding: 0 0 var(--space-2); }
    .camera-feed-identity { display: flex; align-items: center; flex-wrap: wrap; gap: var(--space-2); min-width: 0; }
    .camera-feed-header strong { font-size: .72rem; letter-spacing: .06em; text-transform: uppercase; }
    .camera-mode-selector { display: inline-flex; gap: 2px; padding: 2px; border: 1px solid var(--line); border-radius: 7px; background: var(--bg-primary); }
    .camera-mode-button { min-height: 24px; padding: 3px 7px; border: 0; border-radius: 5px; background: transparent; color: var(--muted); font-size: .56rem; font-weight: 850; letter-spacing: .06em; }
    .camera-mode-button:hover { color: var(--text); background: var(--interactive-hover); }
    .camera-mode-button.active { color: var(--text-primary); background: var(--interactive-active); box-shadow: none; }
    .camera-mode-button:focus-visible { outline: 2px solid var(--focus-ring); outline-offset: 1px; }
    .camera-status { display: inline-flex; align-items: center; gap: 6px; color: var(--muted); font-size: .59rem; font-weight: 900; letter-spacing: .07em; text-transform: uppercase; }
    .camera-status::before { content: ""; width: 6px; height: 6px; border-radius: 50%; background: var(--text-disabled); box-shadow: none; }
    .camera-status.online { color: var(--green); }
    .camera-status.online::before { background: var(--green); box-shadow: none; }
    .camera-status.loading { color: var(--yellow); }
    .camera-status.loading::before { background: var(--yellow); box-shadow: none; }
    .camera-status.offline { color: var(--danger); }
    .camera-status.offline::before { background: var(--danger); box-shadow: none; }
    .camera-status.disabled, .camera-status.unconfigured { color: var(--text-muted); }
    .camera-status.disabled::before { background: var(--text-disabled); box-shadow: none; }
    .camera-feed-actions { display: flex; align-items: center; justify-content: flex-end; gap: 8px; }
    .camera-power-button { min-height: 28px; padding: 4px 8px; border-radius: 7px; color: var(--text-secondary); background: var(--bg-control); font-size: .57rem; letter-spacing: .07em; }
    .camera-power-button.active { color: var(--green); border-color: var(--green); background: var(--bg-control); }
    .camera-frame { position: relative; aspect-ratio: 4 / 3; border: 1px solid var(--border-primary); border-radius: 11px; overflow: hidden; background: var(--bg-page); }
    .camera-feed-card[data-camera-id="forward"] .camera-frame { aspect-ratio: 16 / 9; }
    .camera-frame img { display: block; width: 100%; height: 100%; object-fit: contain; }
    .camera-frame.offline img { opacity: 0; }
    .parabola-best-overlay { position: absolute; z-index: 2; top: 8px; right: 8px; padding: 6px 9px; border: 2px solid #7f8a99; border-radius: 7px; background: rgba(5, 9, 14, .82); color: #d8dee8; font: 800 .72rem/1.35 ui-monospace, SFMono-Regular, Consolas, monospace; white-space: pre-line; pointer-events: none; }
    .parabola-best-overlay[data-best-side="LEFT"] { border-color: #43d7ff; color: #43d7ff; }
    .parabola-best-overlay[data-best-side="RIGHT"] { border-color: #ffd33d; color: #ffd33d; }
    .camera-message { position: absolute; inset: 0; display: grid; place-items: center; color: var(--muted); text-align: center; padding: var(--space-5); }
    .camera-frame.online .camera-message { display: none; }
    .camera-placeholder { display: grid; align-content: center; justify-items: center; gap: var(--space-2); width: 100%; height: 100%; padding: var(--space-6); text-align: center; }
    .camera-placeholder strong { color: var(--text); font-size: .86rem; letter-spacing: .11em; }
    .camera-placeholder p { margin: 0; color: var(--muted); font-size: .72rem; line-height: 1.45; }
    .camera-placeholder .planned-use { margin-top: var(--space-2); color: var(--text-secondary); font-size: .62rem; font-weight: 850; letter-spacing: .08em; text-transform: uppercase; }
    .camera-telemetry-label { margin: var(--space-3) 0 0; color: var(--text-secondary); font-size: .61rem; font-weight: 850; letter-spacing: .1em; text-transform: uppercase; }
    .camera-diagnostics { min-width: 0; display: grid; gap: var(--layout-gap); }
    .camera-diagnostic-list { display: grid; gap: var(--space-1); margin: 0; }
    .camera-diagnostic-item { display: flex; align-items: baseline; justify-content: space-between; gap: var(--space-2); min-width: 0; }
    .camera-diagnostic-item dt { color: var(--muted); font-size: .62rem; }
    .camera-diagnostic-item dd { margin: 0; color: var(--text); font-size: .69rem; font-weight: 800; font-variant-numeric: tabular-nums; overflow-wrap: anywhere; }
    .diagnostic-tools { display: grid; grid-template-columns: minmax(0, 1fr); gap: var(--layout-gap); margin: 0; align-items: start; }
    .diagnostic-oled-card { padding: 0; }
    .diagnostic-oled-card .oled-editor { border: 0; border-radius: 0; background: transparent; }
    .diagnostic-communication-alert { display: grid; grid-template-columns: minmax(190px, .7fr) minmax(0, 1.3fr); align-items: center; gap: var(--space-5); margin: 0; padding: var(--space-3) var(--card-padding); border: 1px solid var(--danger); border-radius: 12px; background: var(--bg-card); }
    .diagnostic-communication-alert[hidden] { display: none; }
    .diagnostic-communication-alert strong { display: block; color: var(--danger); font-size: 1rem; letter-spacing: .08em; }
    .diagnostic-communication-alert span { display: block; margin-top: var(--space-1); color: var(--danger); font-size: .72rem; }
    .diagnostic-communication-alert p { margin: 0; color: var(--text-secondary); font-size: .72rem; line-height: 1.45; }
    .diagnostic-subsystem.communication { grid-column: 1 / -1; min-height: 0; }
    .diagnostic-subsystem .section-header { align-items: center; }
    .subsystem-status { flex: 0 0 auto; padding: 4px 7px; border: 1px solid var(--border-primary); border-radius: 999px; color: var(--text-secondary); background: var(--bg-primary); font-size: .56rem; font-weight: 900; letter-spacing: .07em; text-transform: uppercase; }
    .subsystem-status.ok { color: var(--green); border-color: var(--green); background: var(--bg-primary); }
    .subsystem-status.warn { color: var(--yellow); border-color: var(--yellow); background: var(--bg-primary); }
    .subsystem-status.danger { color: var(--danger); border-color: var(--danger); background: var(--bg-primary); }
    .diagnostic-subsystem[data-telemetry="missing"] { border-color: var(--border-subtle); }
    .diagnostic-subsystem[data-telemetry="missing"] .big-reading { border-color: var(--border-subtle); background: var(--bg-primary); }
    .diagnostic-subsystem[data-telemetry="missing"] .big-reading strong,
    .diagnostic-subsystem[data-telemetry="missing"] .telemetry-row strong { color: var(--text-muted); }
    .diagnostic-maintenance-heading { margin: var(--space-3) 0 0; padding-top: var(--space-4); border-top: 1px solid var(--line-soft); }
    .operation-overview { display: grid; grid-template-columns: minmax(0, 1.15fr) minmax(0, .85fr) minmax(0, .75fr) minmax(0, 2.15fr) minmax(0, .85fr); align-items: stretch; margin: 0; border: 1px solid var(--line); border-radius: 14px; background: var(--bg-card); box-shadow: none; overflow: hidden; }
    .operation-overview > div { min-width: 0; display: flex; flex-direction: column; justify-content: center; gap: var(--space-1); padding: var(--space-3); border-right: 1px solid var(--line-soft); }
    .operation-overview > div:last-child { border-right: 0; }
    .operation-overview span, .operation-overview-label { color: var(--muted); font-size: .58rem; font-weight: 850; letter-spacing: .1em; text-transform: uppercase; }
    .operation-overview strong { color: var(--text); font-size: 1.03rem; line-height: 1.05; font-variant-numeric: tabular-nums; white-space: nowrap; }
    .operation-overview-mode small { color: var(--muted); font-size: .62rem; line-height: 1.25; white-space: nowrap; overflow: hidden; text-overflow: ellipsis; }
    .operation-overview .cockpit-mode-value { color: var(--text-primary); font-size: 1.42rem; letter-spacing: -.035em; }
    .cockpit-mode-value[data-mode="manual"], .cockpit-mode-value[data-mode="autonomous"] { color: var(--text-primary); }
    .cockpit-mode-value[data-mode="emergency"] { color: var(--danger); }
    .operation-overview-item.battery strong { color: var(--text-primary); }
    .operation-overview strong.status-good { color: var(--green); }
    .operation-overview strong.status-warn { color: var(--yellow); }
    .operation-overview strong.status-bad { color: var(--danger); }
    .operation-meter { height: 3px; margin-top: var(--space-1); border-radius: 99px; background: var(--bg-control); overflow: hidden; }
    .operation-meter > div { width: 0; height: 100%; border-radius: inherit; background: var(--text-secondary); box-shadow: none; transition: width .25s ease; }
    .operation-raspberry { gap: var(--space-2) !important; }
    .operation-system-metrics { display: grid; grid-template-columns: repeat(3, minmax(0, 1fr)); gap: var(--space-2); }
    .operation-system-metric { min-width: 0; display: grid; grid-template-columns: auto 1fr; align-items: baseline; gap: var(--space-1); }
    .operation-system-metric span { font-size: .53rem; }
    .operation-system-metric strong { font-size: .82rem; text-align: right; }
    .operation-system-metric > i { grid-column: 1 / -1; height: 2px; border-radius: 99px; background: var(--bg-control); overflow: hidden; }
    .operation-system-metric > i > i { display: block; width: 0; height: 100%; background: var(--text-secondary); transition: width .25s ease; }
    .operation-system-metric[data-level="warn"] > i > i { background: var(--yellow); }
    .operation-system-metric[data-level="danger"] > i > i { background: var(--danger); }
    .operation-cockpit { display: grid; grid-template-columns: minmax(0, 2fr) minmax(360px, 1fr); gap: var(--layout-gap); align-items: stretch; }
    .operation-camera-panel { align-self: start; width: 100%; padding: var(--card-padding); }
    .operation-camera-header, .operation-control-header { display: flex; align-items: flex-start; justify-content: space-between; gap: var(--space-3); margin: 0 0 var(--space-3); }
    .operation-camera-header h2, .operation-control-header h2 { margin: 0; font-size: 1.08rem; letter-spacing: -.02em; }
    .operation-camera-header .eyebrow, .operation-control-header .eyebrow { margin-bottom: var(--space-1); font-size: .58rem; }
    .operation-camera-panel .camera-meta { align-self: center; }
    .operation-camera-panel .meta-chip { padding: 2px 5px; border: 0; background: transparent; font-size: .61rem; }
    .operation-camera-panel .camera-view-selector { width: min(330px, 100%); margin: 0 0 var(--space-2); padding: var(--space-1); }
    .operation-camera-panel .camera-view-button { min-height: 31px; }
    .operation-camera-panel .camera-feed-grid { aspect-ratio: 4 / 3; grid-auto-rows: minmax(0, 1fr); align-items: stretch; }
    .operation-camera-panel .camera-feed-card { display: grid; grid-template-rows: auto minmax(0, 1fr); min-height: 0; height: 100%; padding: 0; border: 0; background: var(--bg-primary); overflow: hidden; }
    .operation-camera-panel .camera-feed-header { padding: var(--space-2); }
    .operation-camera-panel .camera-frame,
    .operation-camera-panel .camera-feed-card[data-camera-id="forward"] .camera-frame { min-height: 0; height: 100%; aspect-ratio: auto; border: 0; border-radius: 8px; background: var(--bg-page); }
    .camera-details { margin: 0 0 var(--space-2); border-top: 1px solid var(--line-soft); border-bottom: 1px solid var(--line-soft); }
    .camera-details summary { display: flex; align-items: center; justify-content: space-between; min-height: var(--accordion-height); color: var(--muted); font-size: .58rem; font-weight: 850; letter-spacing: .08em; text-transform: uppercase; cursor: pointer; list-style: none; }
    .camera-details summary::-webkit-details-marker { display: none; }
    .camera-details summary::after { content: "+"; color: var(--text-secondary); font-size: .9rem; }
    .camera-details[open] summary::after { content: "−"; }
    .camera-technical-metadata { display: flex; flex-wrap: wrap; gap: var(--space-1) var(--space-3); padding: 0 0 var(--space-3); }
    .camera-technical-metadata .meta-chip { padding: 0; border: 0; background: transparent; font-size: .59rem; }
    .camera-message { align-content: center; justify-items: center; gap: 6px; }
    .camera-message strong { color: var(--text); font-size: .78rem; letter-spacing: .08em; text-transform: uppercase; }
    .camera-message span { max-width: 320px; color: var(--muted); font-size: .66rem; line-height: 1.4; }
    .camera-frame.loading .camera-message strong { color: var(--yellow); }
    .camera-frame.offline .camera-message strong { color: var(--danger); }
    .operation-control-panel { align-self: stretch; min-height: 0; display: flex; flex-direction: column; padding: var(--card-padding); overflow: hidden; contain: size; }
    .operation-control-main { min-width: 0; flex: 0 0 auto; display: grid; gap: var(--layout-gap); }
    .operation-control-header { align-items: center; margin-bottom: 0; }
    .operation-control-header .machine-badge { max-width: 48%; }
    .operation-mission-summary, .operation-drive-summary { display: grid; grid-template-columns: repeat(2, minmax(0, 1fr)); gap: var(--space-3); padding: var(--space-3) 0; border-top: 1px solid var(--line-soft); border-bottom: 1px solid var(--line-soft); }
    .operation-mission-summary span, .operation-drive-summary span { display: block; color: var(--muted); font-size: .57rem; font-weight: 800; letter-spacing: .08em; text-transform: uppercase; }
    .operation-mission-summary strong, .operation-drive-summary strong { display: block; margin-top: 5px; color: var(--text); font-size: .9rem; line-height: 1.2; font-variant-numeric: tabular-nums; overflow-wrap: anywhere; }
    .operation-drive-summary strong { font-size: 1.05rem; }
    .operation-drive-summary strong.accent { color: var(--text-primary); }
    .operation-machine-action { min-height: 0; padding: 2px 0; border: 0; background: transparent; }
    .operation-machine-action strong { margin-top: 5px; font-size: 1.13rem; }
    .operation-progress { margin: 0; }
    .operation-mission-selector { padding: 0; border: 0; background: transparent; box-shadow: none; }
    .operation-mission-selector > label::after { display: none; }
    .operation-mission-selector select { min-height: var(--control-height); }
    .operation-mode-buttons { grid-template-columns: repeat(2, minmax(0, 1fr)); }
    .operation-mode-buttons button { min-height: 52px; }
    .operation-accordions { min-width: 0; min-height: 0; flex: 0 1 auto; margin-top: auto; border-top: 1px solid var(--line-soft); overflow-x: hidden; overflow-y: auto; overscroll-behavior: contain; }
    .cockpit-details { border: 0; }
    .cockpit-details + .cockpit-details { border-top: 1px solid var(--line-soft); }
    .cockpit-details summary { display: flex; align-items: center; justify-content: space-between; min-height: var(--accordion-height); color: var(--muted); font-size: .63rem; font-weight: 850; letter-spacing: .08em; text-transform: uppercase; cursor: pointer; list-style: none; }
    .cockpit-details summary::-webkit-details-marker { display: none; }
    .cockpit-details summary::after { content: "+"; color: var(--text-secondary); font-size: 1rem; }
    .cockpit-details[open] summary::after { content: "−"; }
    .cockpit-details-body { display: grid; gap: var(--space-2); padding: 0 0 var(--space-3); }
    .operation-detail-metrics { margin-top: 0; }
    .manual-control-body .keyboard-panel, .manual-control-body .drive-control { border-color: var(--border-subtle); }
    .mission-state-card { --state-color: var(--text-secondary); background: var(--bg-card); }
    .mission-state-card[data-tone="active"] { --state-color: var(--text-primary); }
    .mission-state-card[data-tone="warn"] { --state-color: var(--yellow); }
    .mission-state-card[data-tone="danger"] { --state-color: var(--danger); }
    .mission-state-card .section-title::before { background: var(--state-color); box-shadow: none; }
    .machine-badge { display: inline-flex; align-items: center; gap: var(--space-2); max-width: 52%; padding: var(--space-2); border: 1px solid var(--state-color); border-radius: 999px; color: var(--state-color); background: var(--bg-primary); font-size: .62rem; font-weight: 900; letter-spacing: .08em; text-transform: uppercase; white-space: nowrap; overflow: hidden; text-overflow: ellipsis; }
    .machine-badge::before { content: ""; width: 7px; height: 7px; flex: 0 0 auto; border-radius: 50%; background: var(--state-color); box-shadow: none; }
    .machine-action { min-height: 72px; padding: var(--space-3); border: 1px solid var(--line); border-radius: 12px; background: var(--bg-primary); }
    .machine-action span { display: block; color: var(--muted); font-size: .62rem; font-weight: 850; letter-spacing: .11em; text-transform: uppercase; }
    .machine-action strong { display: block; margin-top: 7px; color: var(--text); font-size: 1.05rem; line-height: 1.25; }
    .machine-progress { margin: var(--space-3) 0; }
    .machine-progress-label { display: flex; justify-content: space-between; gap: 10px; margin-bottom: 6px; color: var(--muted); font-size: .65rem; }
    .machine-progress-label strong { color: var(--state-color); font-variant-numeric: tabular-nums; }
    .machine-progress-track { height: 6px; border-radius: 99px; background: var(--bg-control); overflow: hidden; }
    .machine-progress-fill { width: 0; height: 100%; border-radius: inherit; background: var(--state-color); box-shadow: none; transition: width .18s ease; }
    .machine-flow { display: grid; grid-template-columns: repeat(4, minmax(0, 1fr)); gap: var(--space-1); margin: 0 0 var(--space-3); }
    .machine-step { position: relative; min-width: 0; padding: 8px 3px; border: 1px solid var(--line-soft); border-radius: 8px; color: var(--text-muted); background: var(--bg-primary); text-align: center; font-size: .55rem; font-weight: 850; letter-spacing: .055em; text-transform: uppercase; transition: .2s; }
    .machine-step.active { color: var(--bg-primary); border-color: var(--state-color); background: var(--state-color); box-shadow: none; }
    .machine-metrics { display: grid; grid-template-columns: repeat(2, minmax(0, 1fr)); gap: var(--space-2); }
    .machine-metric { min-width: 0; padding: var(--space-2); border: 1px solid var(--line-soft); border-radius: 9px; background: var(--bg-primary); }
    .machine-metric span { display: block; color: var(--muted); font-size: .58rem; letter-spacing: .06em; text-transform: uppercase; }
    .machine-metric strong { display: block; margin-top: 5px; color: var(--text); font-size: .82rem; font-variant-numeric: tabular-nums; overflow-wrap: anywhere; }
    .machine-metric strong.accent { color: var(--state-color); }
    .command-card { display: flex; flex-direction: column; gap: var(--layout-gap); }
    .command-card .requested-drive { grid-template-columns: minmax(0, 1fr); }
    .mission-selector { padding: var(--space-3); border: 1px solid var(--border-primary); border-radius: 12px; background: var(--bg-primary); box-shadow: none; }
    .mission-selector > label { display: flex; align-items: center; justify-content: space-between; gap: var(--space-2); margin: 0 0 var(--space-2); color: var(--text-secondary); font-size: .68rem; font-weight: 850; letter-spacing: .1em; text-transform: uppercase; }
    .mission-selector > label::after { content: "PADRÃO: PRINCIPAL"; padding: 3px 6px; border: 1px solid var(--border-primary); border-radius: 99px; color: var(--muted); background: var(--bg-primary); font-size: .55rem; letter-spacing: .06em; }
    .mission-selector select { width: 100%; min-height: var(--control-height); padding: 0 var(--space-7) 0 var(--space-3); border: 1px solid var(--border-primary); border-radius: 9px; outline: none; color: var(--text); background: var(--bg-control); font: inherit; font-size: .78rem; font-weight: 850; letter-spacing: .035em; cursor: pointer; }
    .mission-selector select:focus { border-color: var(--focus-ring); box-shadow: 0 0 0 2px var(--focus-ring); }
    .mission-selector option { color: var(--text); background: var(--bg-control); }
    .mission-hint { display: block; margin-top: var(--space-2); color: var(--muted); font-size: .66rem; line-height: 1.35; }
    .oled-editor { border: 1px solid var(--border-primary); border-radius: 12px; background: var(--bg-primary); overflow: hidden; }
    .oled-editor summary { display: flex; align-items: center; justify-content: space-between; gap: var(--space-2); min-height: var(--accordion-height); padding: var(--space-3); color: var(--text-secondary); font-size: .7rem; font-weight: 900; letter-spacing: .09em; text-transform: uppercase; cursor: pointer; list-style: none; }
    .oled-editor summary::-webkit-details-marker { display: none; }
    .oled-editor summary::after { content: "+"; color: var(--text-secondary); font-size: 1.1rem; line-height: 1; }
    .oled-editor[open] summary::after { content: "−"; }
    .oled-summary-state { margin-left: auto; padding: 3px 6px; border: 1px solid var(--border-primary); border-radius: 99px; color: var(--muted); background: var(--bg-primary); font-size: .54rem; letter-spacing: .06em; }
    .oled-editor-body { display: grid; gap: var(--space-3); padding: 0 var(--space-3) var(--space-3); border-top: 1px solid var(--line-soft); }
    .oled-live-state { display: flex; align-items: center; justify-content: space-between; gap: var(--space-4); margin-top: var(--space-3); padding: var(--space-3); border: 1px solid var(--line-soft); border-radius: 10px; background: var(--bg-primary); }
    .oled-live-state div { flex: 0 0 auto; }
    .oled-live-state span { display: block; color: var(--muted); font-size: .57rem; font-weight: 800; letter-spacing: .08em; text-transform: uppercase; }
    .oled-live-state strong { display: block; margin-top: 4px; color: var(--text); font-size: .82rem; letter-spacing: .04em; }
    .oled-editor-state { margin: 0; color: var(--muted); font-size: .65rem; line-height: 1.4; text-align: right; }
    .oled-section { display: grid; gap: var(--space-2); padding-top: var(--space-3); border-top: 1px solid var(--line-soft); }
    .oled-section-heading { display: flex; align-items: end; justify-content: space-between; gap: var(--space-3); }
    .oled-section-heading strong { color: var(--text-secondary); font-size: .68rem; letter-spacing: .08em; text-transform: uppercase; }
    .oled-section-heading span { color: var(--muted); font-size: .61rem; line-height: 1.35; text-align: right; }
    .oled-preset-grid { display: grid; grid-template-columns: repeat(4, minmax(0, 1fr)); gap: var(--space-2); }
    .oled-preset-grid.mission-states { grid-template-columns: repeat(5, minmax(0, 1fr)); }
    .oled-preset { min-height: 58px; display: grid; align-content: center; gap: 3px; padding: var(--space-2); border-color: var(--border-primary); background: var(--bg-control); color: var(--text-primary); text-align: left; }
    .oled-preset:hover:not(:disabled) { border-color: var(--focus-ring); background: var(--interactive-hover); }
    .oled-preset strong { font-size: .72rem; letter-spacing: .06em; }
    .oled-preset span { color: var(--muted); font-size: .58rem; font-weight: 750; line-height: 1.25; }
    .oled-layout-selector { display: grid; grid-template-columns: repeat(2, minmax(0, 1fr)); gap: 2px; padding: 2px; border: 1px solid var(--border-primary); border-radius: 9px; background: var(--bg-primary); }
    .oled-layout-button { min-height: 34px; border: 0; background: transparent; color: var(--muted); font-size: .66rem; }
    .oled-layout-button.active { color: var(--bg-primary); background: var(--text-primary); }
    .oled-fields { display: grid; grid-template-columns: repeat(2, minmax(0, 1fr)); gap: var(--space-2); }
    .oled-fields[hidden] { display: none; }
    .oled-field { min-width: 0; }
    .oled-field.wide { grid-column: 1 / -1; }
    .oled-field label { display: block; margin-bottom: var(--space-1); color: var(--muted); font-size: .59rem; font-weight: 800; letter-spacing: .07em; text-transform: uppercase; }
    .oled-field input { width: 100%; min-width: 0; min-height: var(--control-height); padding: var(--space-2); border: 1px solid var(--border-primary); border-radius: 8px; outline: none; color: var(--text); background: var(--bg-control); font: inherit; font-size: .78rem; }
    .oled-field input:focus { border-color: var(--focus-ring); box-shadow: 0 0 0 2px var(--focus-ring); }
    .oled-layout-hint { margin: 0; color: var(--muted); font-size: .62rem; line-height: 1.4; }
    .oled-actions { display: grid; grid-template-columns: repeat(2, minmax(0, 1fr)); gap: var(--space-2); }
    .oled-actions button { min-height: var(--control-height); font-size: .72rem; }
    .oled-actions .oled-clear { border-color: var(--border-primary); background: var(--bg-control); color: var(--text-primary); }
    .distance-mission-settings { margin: var(--space-2) 0 0; padding: var(--space-2); border: 1px solid var(--border-primary); border-radius: 9px; background: var(--bg-primary); }
    .distance-mission-settings[hidden] { display: none; }
    .distance-input-label { display: block; margin-bottom: var(--space-2); color: var(--muted); font-size: .62rem; font-weight: 800; letter-spacing: .07em; text-transform: uppercase; }
    .distance-input { display: grid; grid-template-columns: minmax(0, 1fr) auto; align-items: center; gap: var(--space-2); }
    .distance-input input { width: 100%; min-width: 0; min-height: var(--control-height); padding: var(--space-2); border: 1px solid var(--border-primary); border-radius: 8px; outline: none; color: var(--text); background: var(--bg-control); font: inherit; font-size: 1rem; font-weight: 900; font-variant-numeric: tabular-nums; }
    .distance-input input:focus { border-color: var(--focus-ring); box-shadow: 0 0 0 2px var(--focus-ring); }
    .distance-input strong { color: var(--text-primary); font-size: .75rem; }
    .distance-calibration { display: block; margin-top: var(--space-2); color: var(--text-muted); font-size: .59rem; line-height: 1.35; }
    .mode-buttons { display: grid; grid-template-columns: repeat(2, minmax(0, 1fr)); gap: var(--space-2); }
    button { min-height: var(--button-height); border: 1px solid var(--border-primary); border-radius: 10px; color: var(--text-primary); background: var(--bg-control); font-weight: 850; cursor: pointer; transition: transform .1s, border-color .1s, background .1s; }
    button:hover { transform: translateY(-1px); border-color: var(--focus-ring); background: var(--interactive-hover); }
    button:focus-visible { outline: 2px solid var(--focus-ring); outline-offset: 2px; }
    button.active { color: var(--text-primary); border-color: var(--focus-ring); background: var(--interactive-active); }
    button.warning { border-color: var(--yellow); background: var(--yellow); color: var(--text-on-warning); }
    button.warning:hover { border-color: var(--yellow); background: var(--yellow); }
    button.danger { border-color: var(--danger); background: var(--danger); color: var(--text-primary); }
    button.danger:hover { border-color: var(--danger); background: var(--semantic-danger-hover); }
    button:disabled { cursor: not-allowed; opacity: .48; transform: none; }
    button.warning:disabled { opacity: 1; }
    .drive-control { padding: var(--space-3); border: 1px solid var(--line-soft); border-radius: 12px; background: var(--bg-primary); }
    .drive-control label { display: flex; justify-content: space-between; gap: var(--space-3); margin: 0 0 var(--space-2); color: var(--muted); font-size: .76rem; font-weight: 750; text-transform: uppercase; letter-spacing: .07em; }
    .drive-control output { color: var(--text); font-variant-numeric: tabular-nums; }
    input[type="range"] { width: 100%; accent-color: var(--text-primary); }
    .manual-speed-grid { display: grid; grid-template-columns: repeat(2, minmax(0, 1fr)); gap: var(--space-2); }
    .manual-speed-grid .drive-control { border-color: var(--border-primary); background: var(--bg-primary); }
    .manual-test-note { grid-column: 1 / -1; margin: 0; color: var(--muted); font-size: .72rem; line-height: 1.45; }
    .servo-control-card { display: grid; gap: var(--space-3); }
    .servo-control-grid { display: grid; grid-template-columns: repeat(3, minmax(0, 1fr)); gap: var(--space-2); }
    .servo-control { min-width: 0; padding: var(--space-3); border: 1px solid var(--border-primary); border-radius: 12px; background: var(--bg-primary); }
    .servo-control label { display: flex; align-items: center; justify-content: space-between; gap: var(--space-2); color: var(--text-secondary); font-size: .72rem; font-weight: 850; letter-spacing: .07em; text-transform: uppercase; }
    .servo-control label output { color: var(--text); font-size: .9rem; font-variant-numeric: tabular-nums; }
    .servo-control input[type="range"] { margin: var(--space-3) 0; }
    .servo-angle-entry { display: grid; grid-template-columns: minmax(0, 1fr) auto; align-items: center; gap: var(--space-2); }
    .servo-angle-entry input { width: 100%; min-width: 0; min-height: var(--control-height); padding: 0 var(--space-2); border: 1px solid var(--border-primary); border-radius: 8px; outline: none; color: var(--text); background: var(--bg-control); font: inherit; font-variant-numeric: tabular-nums; }
    .servo-angle-entry input:focus { border-color: var(--focus-ring); box-shadow: 0 0 0 2px var(--focus-ring); }
    .servo-angle-entry span { color: var(--muted); font-size: .8rem; font-weight: 800; }
    .servo-output-state { display: block; min-height: 1.2em; margin-top: var(--space-2); color: var(--muted); font-size: .66rem; line-height: 1.35; }
    .servo-actions { display: flex; align-items: center; justify-content: space-between; gap: var(--space-3); }
    .servo-actions p { margin: 0; color: var(--muted); font-size: .7rem; line-height: 1.4; }
    .servo-actions button { flex: 0 0 auto; min-height: var(--control-height); }
    .servo-calibration { border-top: 1px solid var(--line-soft); }
    .servo-calibration summary { display: flex; align-items: center; justify-content: space-between; gap: var(--space-3); padding-top: var(--space-3); color: var(--text-secondary); cursor: pointer; font-size: .72rem; font-weight: 850; letter-spacing: .07em; text-transform: uppercase; }
    .servo-calibration-body { display: grid; gap: var(--space-3); padding-top: var(--space-3); }
    .servo-calibration-warning { margin: 0; padding: var(--space-3); border: 1px solid var(--yellow); border-radius: 10px; color: var(--text-secondary); background: var(--bg-primary); font-size: .7rem; line-height: 1.45; }
    .servo-calibration-toolbar { display: flex; flex-wrap: wrap; align-items: end; gap: var(--space-2); }
    .servo-calibration-toolbar label, .servo-calibration-endpoint label { display: grid; gap: var(--space-1); color: var(--muted); font-size: .66rem; font-weight: 800; }
    .servo-calibration-toolbar select, .servo-calibration-endpoint input { min-height: var(--control-height); padding: 0 var(--space-2); border: 1px solid var(--border-primary); border-radius: 8px; color: var(--text); background: var(--bg-control); }
    .servo-calibration-workspace { display: grid; gap: var(--space-3); padding: var(--space-3); border: 1px solid var(--border-primary); border-radius: 12px; background: var(--bg-primary); }
    .servo-calibration-workspace[hidden] { display: none; }
    .servo-calibration-readout { display: flex; align-items: baseline; justify-content: space-between; gap: var(--space-2); }
    .servo-calibration-readout strong { font-size: 1.25rem; font-variant-numeric: tabular-nums; }
    .servo-calibration-adjustments { display: grid; grid-template-columns: repeat(4, auto) minmax(90px, 1fr) auto; gap: var(--space-1); }
    .servo-calibration-adjustments input { width: 100%; min-width: 0; min-height: var(--control-height); padding: 0 var(--space-2); border: 1px solid var(--border-primary); border-radius: 8px; color: var(--text); background: var(--bg-control); text-align: center; font-variant-numeric: tabular-nums; }
    .servo-calibration-endpoints { display: grid; grid-template-columns: repeat(2, minmax(0, 1fr)); gap: var(--space-2); }
    .servo-calibration-endpoint { display: grid; grid-template-columns: minmax(0, 1fr) auto; align-items: end; gap: var(--space-1); }
    .servo-calibration-endpoint label { min-width: 0; }
    .servo-calibration-actions { display: flex; flex-wrap: wrap; gap: var(--space-2); }
    .servo-calibration-actions button { min-height: var(--control-height); }
    .servo-calibration-note { margin: 0; color: var(--muted); font-size: .67rem; line-height: 1.4; }
    .requested-drive { display: grid; grid-template-columns: repeat(2, minmax(0, 1fr)); gap: var(--space-2); }
    .request-value { padding: var(--space-3); border: 1px solid var(--line-soft); border-radius: 10px; background: var(--bg-primary); }
    .request-value span { display: block; color: var(--muted); font-size: .67rem; text-transform: uppercase; }
    .request-adjustment { display: grid; grid-template-columns: 34px minmax(0, 1fr) 34px; gap: var(--space-1); margin-top: var(--space-1); }
    .request-value input { width: 100%; min-width: 0; padding: 5px 4px; border: 1px solid var(--border-primary); border-radius: 7px; outline: none; color: var(--text); background: var(--bg-control); font: inherit; font-size: 1.12rem; font-weight: 900; text-align: center; font-variant-numeric: tabular-nums; }
    .request-value input:focus { border-color: var(--focus-ring); box-shadow: 0 0 0 2px var(--focus-ring); }
    .trim-button { min-height: 34px; padding: 0; border-radius: 7px; font-size: .74rem; }
    .keyboard-panel { display: flex; align-items: center; justify-content: space-between; gap: var(--space-3); padding: var(--space-3); border: 1px solid var(--line-soft); border-radius: 12px; background: var(--bg-primary); }
    .keyboard-copy strong { display: block; font-size: .78rem; letter-spacing: .06em; text-transform: uppercase; }
    .keyboard-copy span { display: block; max-width: 190px; margin-top: 4px; color: var(--muted); font-size: .7rem; line-height: 1.35; }
    .keys { flex: 0 0 auto; display: grid; grid-template-columns: repeat(3, 30px); grid-template-rows: repeat(2, 30px); gap: 4px; }
    .keycap { display: grid; place-items: center; border: 1px solid var(--border-primary); border-radius: 6px; background: var(--bg-control); color: var(--text-secondary); font-size: .72rem; font-weight: 900; box-shadow: none; }
    .keycap.w { grid-column: 2; }
    .keycap.a { grid-column: 1; grid-row: 2; }
    .keycap.s { grid-column: 2; grid-row: 2; }
    .keycap.d { grid-column: 3; grid-row: 2; }
    .keycap.active { border-color: var(--focus-ring); background: var(--interactive-active); color: var(--text-primary); box-shadow: none; }
    .safety-note { margin-top: auto; padding: var(--space-3); border-left: 3px solid var(--yellow); border-radius: 7px; background: var(--bg-primary); color: var(--yellow); font-size: .75rem; line-height: 1.45; }
    .telemetry-heading { display: flex; align-items: end; justify-content: space-between; gap: var(--space-5); margin: 0; }
    .telemetry-heading h2 { margin: 0; font-size: 1.2rem; }
    .telemetry-heading p { margin: 0; color: var(--muted); font-size: .78rem; }
    .telemetry-grid { display: grid; grid-template-columns: repeat(12, minmax(0, 1fr)); gap: var(--layout-gap); align-items: stretch; }
    .telemetry-card { grid-column: span 6; min-height: 0; padding: var(--card-padding); }
    .telemetry-card.wide { grid-column: span 6; }
    .diagnostic-third { grid-column: span 4; }
    .big-pair { display: grid; grid-template-columns: repeat(2, minmax(0, 1fr)); gap: var(--space-2); margin: 0 0 var(--space-3); }
    .big-reading { padding: var(--space-3); border: 1px solid var(--line-soft); border-radius: 11px; background: var(--bg-primary); }
    .big-reading span { display: block; color: var(--muted); font-size: .68rem; text-transform: uppercase; letter-spacing: .06em; }
    .big-reading strong { display: block; margin-top: var(--space-2); font-size: 1.55rem; font-variant-numeric: tabular-nums; }
    .telemetry-list { display: grid; gap: 0; }
    .telemetry-row { min-height: 36px; display: flex; align-items: center; justify-content: space-between; gap: var(--space-3); border-bottom: 1px solid var(--line-soft); font-size: .78rem; }
    .telemetry-row:last-child { border-bottom: 0; }
    .telemetry-row span { color: var(--muted); }
    .telemetry-row strong { min-width: 0; text-align: right; overflow-wrap: anywhere; font-variant-numeric: tabular-nums; }
    .axis { color: var(--text-primary); font-weight: 900; }
    .motor-bar { height: 5px; margin-top: var(--space-2); border-radius: 99px; background: var(--bg-control); overflow: hidden; }
    .motor-bar > div { width: 0; height: 100%; border-radius: inherit; background: var(--text-secondary); transition: width .15s; }
    .state-good { color: var(--green); }
    .state-warn { color: var(--yellow); }
    .state-bad { color: var(--danger); }
    .state-neutral { color: var(--text-muted); }
    footer { width: 100%; display: flex; justify-content: space-between; gap: var(--space-5); margin: 0; padding: var(--space-4) 0 0; border-top: 1px solid var(--line-soft); color: var(--text-muted); font-size: .72rem; }
    @media (max-width: 1050px) {
      .hero-grid { grid-template-columns: repeat(2, minmax(0, 1fr)); }
      .main-grid { grid-template-columns: 1fr; }
      .operation-overview { grid-template-columns: repeat(3, minmax(0, 1fr)); }
      .operation-overview > div:nth-child(3) { border-right: 0; }
      .operation-overview > div { border-bottom: 1px solid var(--line-soft); }
      .operation-overview > div:nth-child(n + 4) { border-bottom: 0; }
      .operation-cockpit { grid-template-columns: 1fr; align-items: start; }
      .operation-control-panel { align-self: auto; contain: none; overflow: visible; }
      .operation-accordions { flex: 0 0 auto; margin-top: 0; overflow: visible; }
      .diagnostic-tools { grid-template-columns: 1fr; }
      .telemetry-card, .telemetry-card.wide,
      .diagnostic-third { grid-column: span 12; }
      .oled-preset-grid, .oled-preset-grid.mission-states { grid-template-columns: repeat(2, minmax(0, 1fr)); }
    }
    @media (max-width: 680px) {
      html, body { overflow-x: hidden; }
      :root { --page-inline-space: 10px; --page-block-space: var(--space-4); }
      .topbar { align-items: flex-start; flex-direction: column; }
      .status-cluster { justify-content: flex-start; }
      .mode-navigation { grid-template-columns: 1fr; }
      .mode-tab { min-height: 40px; }
      .mode-heading { align-items: flex-start; flex-direction: column; }
      .mode-heading p { text-align: left; }
      .hero-grid { grid-template-columns: 1fr; }
      .hero-card { min-height: 124px; }
      .operation-overview { grid-template-columns: repeat(2, minmax(0, 1fr)); }
      .operation-overview > div { border-right: 1px solid var(--line-soft); border-bottom: 0; }
      .operation-overview > div:nth-child(-n + 4) { border-bottom: 1px solid var(--line-soft); }
      .operation-overview > div:nth-child(even) { border-right: 0; }
      .operation-overview > div:last-child { grid-column: 1 / -1; border-right: 0; }
      .operation-camera-header { flex-direction: column; }
      .operation-camera-panel .camera-meta { align-self: stretch; justify-content: flex-start; }
      .operation-mission-summary, .operation-drive-summary { gap: var(--space-2); }
      .operation-mode-buttons { grid-template-columns: repeat(2, minmax(0, 1fr)); }
      .diagnostic-communication-alert { grid-template-columns: 1fr; gap: var(--space-2); }
      .section-header, .telemetry-heading { align-items: flex-start; flex-direction: column; }
      .camera-meta { justify-content: flex-start; }
      .camera-feed-grid[data-view="dual"] { grid-template-columns: 1fr; }
      .camera-view-button { min-width: 0; padding-inline: var(--space-1); }
      .camera-message, .safety-note { overflow-wrap: anywhere; }
      .keyboard-copy span { max-width: none; }
      .manual-speed-grid { grid-template-columns: 1fr; }
      .servo-control-grid { grid-template-columns: 1fr; }
      .servo-actions { align-items: stretch; flex-direction: column; }
      .servo-calibration-adjustments { grid-template-columns: repeat(4, minmax(0, 1fr)); }
      .servo-calibration-adjustments input { grid-column: 1 / 4; }
      .servo-calibration-endpoints { grid-template-columns: 1fr; }
      .oled-live-state, .oled-section-heading { align-items: flex-start; flex-direction: column; }
      .oled-editor-state, .oled-section-heading span { text-align: left; }
      .oled-preset-grid, .oled-preset-grid.mission-states, .oled-fields, .oled-actions { grid-template-columns: 1fr; }
      .oled-field.wide { grid-column: auto; }
      .telemetry-row { align-items: flex-start; flex-wrap: wrap; padding: var(--space-2) 0; }
      footer { flex-direction: column; }
    }
  </style>
</head>
<body>
  <main class="shell">
    <header class="topbar">
      <div class="brand">
        <div class="brand-mark"><img src="/dashboard-logo.png?v=1" width="52" height="52" alt="Logo Soul Sync"></div>
        <div><span class="eyebrow">OBR · Temporada 2026</span><h1>Soul Sync</h1></div>
      </div>
      <div class="status-cluster">
        <div id="connection" class="status-pill">PAINEL OFFLINE</div>
        <div id="esp32Link" class="status-pill">ESP32 OFFLINE</div>
        <div id="safetyStatus" class="status-pill warn">ROBÔ PARADO</div>
      </div>
    </header>

    <nav class="mode-navigation" role="tablist" aria-label="Áreas do dashboard">
      <button id="operationModeButton" type="button" class="mode-tab active" role="tab" data-dashboard-mode="operation" aria-controls="operationMode" aria-selected="true">Operação</button>
      <button id="diagnosticsModeButton" type="button" class="mode-tab" role="tab" data-dashboard-mode="diagnostics" aria-controls="diagnosticsMode" aria-selected="false">Diagnóstico</button>
    </nav>

    <section id="operationMode" class="dashboard-mode" role="tabpanel" aria-labelledby="operationModeButton" data-dashboard-panel="operation">
      <section class="operation-overview" aria-label="Resumo operacional">
        <div class="operation-overview-mode">
          <span>Modo atual</span>
          <strong id="mode" class="cockpit-mode-value">--</strong>
          <small id="modeDetail">Aguardando estado da Raspberry</small>
        </div>
        <div class="operation-overview-item battery">
          <span>Bateria</span>
          <strong id="batteryVoltage">--.-- V</strong>
          <div class="operation-meter"><div id="batteryFill"></div></div>
        </div>
        <div class="operation-overview-item">
          <span>ESP32</span>
          <strong id="esp32Status" class="status-bad">OFFLINE</strong>
        </div>
        <div class="operation-raspberry" aria-label="Estado da Raspberry Pi">
          <span class="operation-overview-label">Raspberry Pi</span>
          <div class="operation-system-metrics">
            <div id="cpuMetric" class="operation-system-metric"><span>CPU</span><strong id="cpu">--%</strong><i><i id="cpuFill"></i></i></div>
            <div id="ramMetric" class="operation-system-metric"><span>RAM</span><strong id="ram">--%</strong><i><i id="ramFill"></i></i></div>
            <div id="temperatureMetric" class="operation-system-metric"><span>Temp.</span><strong id="temp">-- °C</strong><i><i id="temperatureFill"></i></i></div>
          </div>
        </div>
        <div class="operation-overview-item">
          <span>FPS câmera</span>
          <strong id="operationCameraFps">-- FPS</strong>
        </div>
      </section>

      <section class="operation-cockpit">
        <section class="card operation-camera-panel">
          <div class="operation-camera-header">
            <div>
              <span class="eyebrow">Visão principal</span>
              <h2 id="operationCameraName">Câmera inferior</h2>
            </div>
            <div id="cameraMetadata" class="camera-meta" aria-live="polite"></div>
          </div>
          <div class="camera-view-selector" role="group" aria-label="Visualização das câmeras">
            <button type="button" class="camera-view-button active" data-camera-view="downward" aria-pressed="true">Inferior</button>
            <button type="button" class="camera-view-button" data-camera-view="forward" aria-pressed="false">Frontal</button>
            <button type="button" class="camera-view-button" data-camera-view="dual" aria-pressed="false">Dupla</button>
          </div>
          <details class="camera-details">
            <summary>Detalhes da câmera</summary>
            <div id="cameraTechnicalMetadata" class="camera-technical-metadata"></div>
          </details>
          <div id="datasetCaptureStatus" class="dataset-capture-strip" data-state="paused" aria-live="polite">
            <strong id="datasetCaptureState">Dataset pausado</strong>
            <span id="datasetCaptureDetails">Nenhuma coleta configurada.</span>
          </div>
          <div id="cameraFeeds" class="camera-feed-grid" data-view="downward" aria-live="polite"></div>
        </section>

        <aside id="missionStateCard" class="card operation-control-panel mission-state-card" data-tone="idle">
          <div class="operation-control-main">
            <div class="operation-control-header">
              <div><span class="eyebrow">Controle da prova</span><h2>Missão e comando</h2></div>
              <span id="machineStateBadge" class="machine-badge">PARADO</span>
            </div>

            <div class="operation-mission-summary">
              <div><span>Missão atual</span><strong id="machineMission">Principal</strong></div>
              <div><span>Comportamento</span><strong id="machineBehavior">NENHUM</strong></div>
            </div>
            <div class="machine-action operation-machine-action">
              <span>Ação atual</span>
              <strong id="machineAction">Missão parada</strong>
            </div>
            <div class="machine-progress operation-progress">
              <div class="machine-progress-label"><span>Progresso da etapa</span><strong id="machineProgressValue">0%</strong></div>
              <div class="machine-progress-track"><div id="machineProgressFill" class="machine-progress-fill"></div></div>
            </div>
            <div class="operation-drive-summary">
              <div><span>Velocidade E / D</span><strong id="machineAppliedSpeed">-- / --</strong></div>
              <div><span>Comando E / D</span><strong id="machineRequestedSpeed" class="accent">0.00 / 0.00</strong></div>
            </div>

            <div class="mission-selector operation-mission-selector">
              <label for="autonomousMission">Missão autônoma</label>
              <select id="autonomousMission">
                <option value="main_mission" selected>MISSÃO PRINCIPAL</option>
                <option value="turn_right_90">GIRO 90° À DIREITA</option>
                <option value="drive_distance">PERCORRER DISTÂNCIA</option>
                <option value="rescue_zone_detection">ÁREAS DE RESGATE</option>
                <option value="rescue_zone_search">SEARCH_ZONE · PROCURAR ÁREA</option>
                <option value="rescue_zone_align">ALIGN_ZONE · CENTRALIZAR ÁREA</option>
                <option value="rescue_zone_approach">APPROACH_ZONE · APROXIMAR ÁREA</option>
                <option value="rescue_zone_triangle">TRIÂNGULO · BUSCAR E APROXIMAR</option>
                <option value="rescue_exit">SAÍDA · BUSCAR E RETOMAR PERCURSO</option>
                <option value="rescue_exit_with_reverse">SAÍDA · RÉ DE 40 CM + TESTAR YAWS</option>
                <option value="rescue_corner_yaw_test">SAÍDA · TESTAR YAW DAS QUINAS</option>
                <option value="rescue_area">RESGATE · DETECTAR + ALINHAR/IR ATRÁS</option>
                <option value="obstacle_avoidance">DESVIO DE OBSTÁCULO</option>
                <option value="servo_initialize">SERVOS · POSE HOME 15/0/0</option>
                <option value="servo_wave">SERVOS · TCHAUZINHO (BÔNUS)</option>
                <option value="servo_capture">SERVOS · CAPTURA</option>
                <option value="servo_internal_storage">SERVOS · ARMAZENAMENTO INTERNO</option>
                <option value="servo_deposit">SERVOS · DEPÓSITO</option>
                <option value="servo_full_sequence">SERVOS · SEQUÊNCIA COM ARMAZENAMENTO</option>
                <option value="servo_full_sequence_two">SERVOS · SEQUÊNCIA SEM ARMAZENAMENTO</option>
              </select>
              <pre id="exitSearchDetails" hidden style="white-space:pre-wrap"></pre>
              <span id="missionHint" class="mission-hint">Segue-faixa com retorno verde e desvio ultrassônico de obstáculo.</span>
              <div id="distanceMissionSettings" class="distance-mission-settings" hidden>
                <span class="distance-input-label">Distância alvo</span>
                <div class="distance-input">
                  <input id="distanceTargetCm" type="number" min="1" max="300" step="1" value="20" inputmode="decimal" aria-label="Distância alvo em centímetros">
                  <strong>cm</strong>
                </div>
                <small class="distance-calibration">Calibração real: 3600 contagens = 18,7 cm · 192,51 cont/cm.</small>
              </div>
              <div id="rescueZoneAlignSettings" class="distance-mission-settings" hidden>
                <span class="distance-input-label">Cor alvo obrigatória</span>
                <select id="rescueZoneTargetColor" aria-label="Cor alvo da zona">
                  <option value="green" selected>GREEN</option>
                  <option value="red">RED</option>
                </select>
                <small class="distance-calibration">A cor escolhida é usada pelos modos SEARCH, ALIGN e TRIÂNGULO.</small>
              </div>
              <div id="servoRoutineSettings" class="distance-mission-settings" hidden>
                <span id="servoRoutineStorageState" class="distance-input-label">Armazenamento interno vazio</span>
                <button id="servoRoutineConfirmButton" type="button" class="warning" disabled>Confirmar próximo passo</button>
                <small class="distance-calibration">O armazenamento aguarda o pedido de fechamento. No depósito, cada abertura deve ser confirmada em até 2 segundos.</small>
              </div>
              <div id="rescueMemorySettings" class="distance-mission-settings">
                <span class="distance-input-label">Memória de entregas (RAM)</span>
                <span id="rescueMemoryStatus">Prata 0/2 · Preta 0/1</span>
                <div class="distance-input">
                  <label for="rescueTestAlive">Pratas</label>
                  <input id="rescueTestAlive" type="number" min="0" max="2" step="1" value="0">
                  <label for="rescueTestDead">Pretas</label>
                  <input id="rescueTestDead" type="number" min="0" max="1" step="1" value="0">
                </div>
                <button id="rescueTestMemoryButton" type="button" class="warning" disabled>Simular entregas</button>
                <small class="distance-calibration">Só com o robô parado. Simula entregas para testar a missão principal; STOP mantém, reinício/deploy zera. Defina 0/0 para limpar.</small>
              </div>
            </div>
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
