ORC-Robotics/soul-robot/(commit log)

2026-04-29 adiciona deploy na Raspberry e controle pelo dashboard
2026-04-29 add Raspberry deploy flow and robot dashboard control
2026-05-06 camera add
2026-05-10 esp32 e melhorias da cam
2026-05-12 leitura de erro, e verde ok
2026-08-04 Firmware ESP32 Atualizado Nova PCB
2026-08-07 fix ativa motores
2026-08-07 esp32 novos limites
2026-08-10 correção de valores e variaveis motores e gyro
2026-08-10 calibragem +- dos encoders
2026-08-11 feat: add filtered black line mask
2026-08-12 chore: archive Raspberry Pi 4 snapshot
2026-08-13 feat(camera): add explicit forward and downward camera profiles
    - forward: 960x540 sobre sensor 1920x1080
    - down: 640x480 sobre sensor 1640x1232 10-bit
    - seleção por CLI ou OBR_CAMERA_ROLE
    - validação da configuração aplicada
    - filtro estrutural mínimo do perfil down equivalente a 20 px em 480 px
    - comportamento dos motores não foi alterado
2026-08-13 feat(dashboard): show active camera profile and sensor configuration
2026-08-13 test(camera): add profile and IMX219 mode diagnostics
2026-08-13 ops(camera): add systemd camera role override example
2026-08-13 docs(camera): document forward and downward camera roles
2026-08-13 feat(camera): calibrate downward AHEAD and PIVOT regions
2026-08-13 feat(line-following): stabilize downward tracking and ahead alignment
    [camera_line_frame.py, main_mission.cpp, main_mission.h, motor_controller.cpp, test_camera_profiles.py]
2026-08-13 fix(motor): allow full normalized operational output
    [config.h, dashboard_server.cpp]
2026-08-13 docs(motor): document full operational output range
2026-08-14 feat(camera): add diagnostic green marker perception
2026-08-17 checkpoint: deploy current camera pipeline to Raspberry Pi 5
2026-08-17 fix: accept CRLF in line trace samples
2026-08-17 fix: let trace recorder finish 300 samples
    [camera_line_frame.py, test_camera_profiles.py]
2026-08-17 fix: detect Raspberry Pi 5 GPIO base
    [gpio.cpp]
2026-08-17 Add on-demand forward camera stream
2026-08-17 Fix Pi 5 deploy defaults and forward camera display
    [dashboard_server.cpp]
2026-08-17 Mount forward stream immediately on activation
2026-08-17 Keep forward stream active when telemetry fails
    [dashboard_server.cpp]
2026-08-17 fix: estabiliza perfil de visão na Raspberry Pi 5
    [line-regression-trace-300.csv]
2026-08-17 chore: configura IntelliSense para MinGW
2026-08-17 testes de verde, gaps corrigidos e roi corrigida.
    [camera_line_frame.py, camera_monitor.cpp, camera_monitor.h, config.h, dashboard_server.cpp, imu_turn_controller.cpp, imu_turn_controller.h, main.cpp]
2026-08-18 testes de verde (ainda falhando)
2026-08-19 feat(robot): atualiza seguidor de linha, telemetria e dashboard Soul Sync
2026-08-21 fix bug esp32 offline & state da camera
    [dashboard_server.cpp]
2026-08-21 reconhecimento dos verdes
    [line-regression-trace-300.csv]
2026-08-21 feat(line): add calibrated FAR/NEAR virtual sensors
2026-08-22 sensores virtuais funcionando
2026-08-22 tamanho dos sensores ajustados
2026-08-23 perf(seguidor): reduz latência do processamento de linha
    Adiciona telemetria detalhada de BIN, SPEC, MORPH e CONT no dashboard; inclui subtempos de background, comparação binária e morfologia; mantém o reparo especular bypassado; aplica a implementação C2 com OpenCV no binary compare, reduzindo sua latência sem alterar a máscara resultante.
2026-08-23 feat(seguidor): adiciona prioridade de trajetória para verdes laterais
    Implementa seleção de ramo para verdes de esquerda e direita usando os sensores virtuais FAR/NEAR; mantém a decisão ativa durante a curva; detecta início e conclusão pelo NEAR; bloqueia novas decisões até 60 quadros consecutivos sem candidato verde. Retorno de 180 graus permanece fora deste gate.
2026-08-24 relatorio de weak drive unsolved
2026-08-26 fix uturn delay time and improve fine center gain
    [camera_line_frame.py, config.h, imu_turn_controller.cpp, main_mission.cpp, main_mission.h, main_mission_test.cpp, test_camera_line_virtual_turn.py]
2026-08-28 new camera content
2026-08-29 stable new features camera and testing green
2026-08-31 cam fix and top recover add, pics tacked for rescue
    [camera_line_frame.py, camera_monitor.cpp, camera_monitor.h, config.h, dashboard_server.cpp, forward_camera_stream.py, main.cpp, main_mission.cpp]
2026-09-01 green fix removed gyro turn
    [camera_line_frame.py, config.h, main_mission.cpp, main_mission.h, main_mission_test.cpp]
2026-09-03 desativa sincronismo dos encoders no segue-faixa por câmera
2026-09-04 in dev bug fixes
    [camera_line_frame.py, main_mission.cpp, main_mission_test.cpp, test_camera_line_virtual_turn.py]
2026-09-05 servos add e configurados
2026-09-06 Integra desvio autônomo de obstáculos
2026-09-06 Integra detector de vítimas à área de resgate
2026-09-08 feat(vision): calibrate downward line segmentation with real-track metrics
    [deploy_interruption_diff.txt]
2026-09-08 docs(calibration): document remaining issues and resumption workflow
2026-09-09 fix: hold gripper while wrist moves
    [config.h, robot_state.cpp, servo_controller.cpp, servo_controller.h, servo_controller_test.cpp]
2026-09-09 feat: stabilize line vision and gap handling
    Compensate fixed illumination shadows, preserve coherent lateral curves during gap detection, and temporarily disable unvalidated silver mission triggers.
    [application.py, build_line_illumination_reference.py, calibration_capture.py, camera_config.py, camera_line_frame.py, fusion_guidance.py, gap_validation.py, illumination_correction.py]
2026-09-09 feat: atualiza sequencias de coleta e armazenamento
2026-09-10 feat: implementa enquadramento best-effort das zonas
    Adiciona o modo isolado FRAME_ZONE com seleção GREEN/RED, micro-pivôs temporizados e conclusão segura sem exigir FULL_BOUNDS.
    Preserva a visão validada, expõe snapshot e telemetria da zona, mantém ULTRA, condiciona diagnósticos cromáticos e inclui profiling e regressões da CAM1.
    Remove a ré de BOUNDS_UNKNOWN e conclui bounds desconhecidos ou parciais em best effort, sempre com os motores zerados ao terminar.
2026-09-10 feat: completa fluxo autônomo das zonas de resgate
    - ancora a detecção GREEN nos componentes strong-green e preserva RED
    - substitui FRAME_ZONE pelo ALIGN_ZONE com micro-pivôs temporizados
    - adiciona APPROACH_ZONE com ULTRA, heading e parada redundante pela CAM1
    - adiciona SEARCH_ZONE a 0.72 e orquestração TRIÂNGULO
    - amplia dashboard, IPC, telemetria e testes de regressão
2026-09-11 feat: implementa desvio inicial de obstáculo
    Compartilha a centralização de linha com a manobra de 180 graus, seleciona o lado livre durante o sweep ultrassônico e executa avanço, curva e pivot final com telemetria. Preserva os parâmetros calibrados manualmente no robô real.
2026-09-11 feat: atualiza detecção prata e potência de rampa
2026-09-11 fix: publica candidata prata para manobra de entrada
    [camera_monitor.cpp, camera_monitor.h, status_publisher.py, test_camera_profiles.py]
2026-09-11 fix: estabiliza manobras de verde
    [application.py, camera_config.py, camera_line_frame.py, config.h, green_detection.py, green_turn_around_maneuver.cpp, line_control.py, test_camera_profiles.py]
2026-09-11 fix: evita falso retorno verde
    [camera_config.py, camera_line_frame.py, green_detection.py]
2026-09-11 feat: recua antes do desvio de obstaculo
2026-09-11 chore: remove overlay de prata da camera inferior
2026-09-11 feat: acelera detecção de prata e alinha entrada
2026-09-11 feat: valida recuperacao de obstaculos com CAM1
2026-09-13 fix(rescue): correct sweep direction and safe collection sequence
    Remember candidate direction, bound sweeps, speed up sequential servos, align zones with YOLO search pulses, and require reverse before lifting every victim. Run final deposit advance for 1500 ms at 75 percent excluding mission pauses.
    Add regression coverage and update rescue documentation. Rescue tests passed; full C++ and Python suite failures reproduced on HEAD. Final absolute-heading guard remains pending rebuild due to tooling usage limit; hardware validation is pending.
    [ball_tracker.py, camera_monitor.cpp, camera_monitor.h, config.h, forward_camera_stream.py, imu_turn_controller.cpp, imu_turn_controller.h, main_mission_test.cpp]
2026-09-14 feat: treina detector para fita prata fina e restaura overlay
2026-09-15 fix: preserve rescue exit servo state and gate obstacle reacquisition
    [camera_monitor.cpp, camera_monitor.h, main_mission.cpp, main_mission_test.cpp, obstacle_avoidance.cpp, obstacle_avoidance_test.cpp, robot_state.cpp, robot_state.h]
2026-09-16 Salva alterações para a etapa estadual
2026-09-17 Estabiliza confirmação e manobras de verdes, incluindo 180 graus
    Consolida o evento latched, a retenção de decisões confirmadas, os movimentos medidos com correção de yaw e a busca visual do ramo escolhido. Melhora a associação local do verde e evita conflito angular artificial em ROIs superiores totalmente pretas. Inclui diagnósticos e testes de regressão, preservando o Fusion normal fora das manobras.
    Validação: compilação local C++17 e green_maneuver_test --green-only aprovados; testes Python selecionados aprovados; cenários difíceis validados repetidamente na pista pelo usuário.
    Segurança preservada: parada de emergência, timeout de comandos, saídas limitadas e pin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
2026-09-17 feat: estabiliza desvio de obstáculo no estágio ele faz
2026-09-17 Melhora classificador de prata com treino em duas iluminações
2026-09-17 fix(vision): preserve and track primary green marker confirmation
    [application.py, camera_config.py, green_detection.py, test_camera_profiles.py]
2026-09-17 Ajusta saída do resgate, retorno de 180 graus e visão
2026-09-17 fix: limita merge estadual à memória e deploy Linux
    [config.h, rescue_room_mission.cpp, rescue_room_mission.h, rescue_room_mission_test.cpp, servo_routine.cpp, servo_routine.h, servo_routine_test.cpp]
2026-09-17 Ajusta recuperação da câmera, desvio de obstáculos e visão do resgate
2026-09-18 Ajusta rota de saída e continuidade do resgate
2026-09-18 Implementa deploy Windows incremental e referencia de entrada na saida do resgate
2026-09-18 Fix obstacle exit heading correction and incremental Windows deploy
    [config.h, obstacle_avoidance.cpp, obstacle_avoidance.h, obstacle_avoidance_test.cpp]
2026-10-07 Tighten the About section
    Mention the robot's compact size and reword both language versions to
    read more naturally.
